robertrico/a2m2053_controller/docs/captures/m2/2026-10-10_motor_on_tach.txt

> motor on
motor on
OK
> status 4
status 4
STATUS MOTORON=0
OK
> status 13
status 13
STATUS READY=0
OK
> tach
tach
TACH edges=196 rpm=392
OK
> tach
tach
TACH edges=196 rpm=392
OK
