robertrico/a2m2053_controller/docs/captures/m0/2026-10-10_boot-safety-reset.png

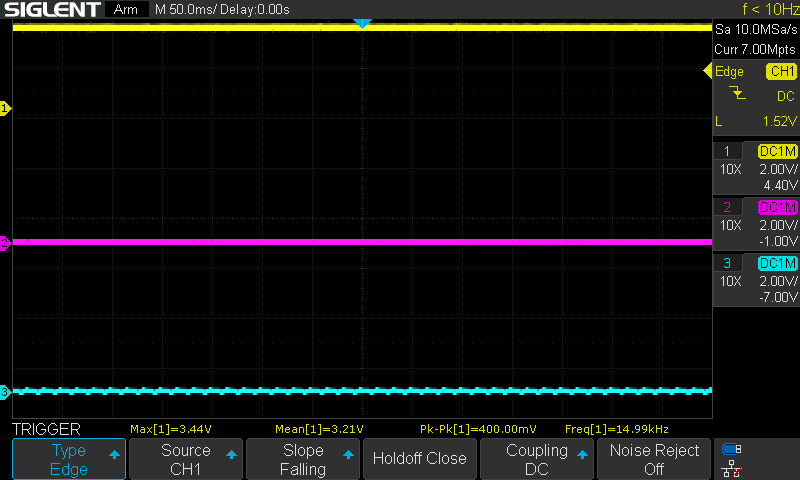
docs/captures/m0/2026-10-10_boot-safety-reset.png
