robertrico/a2m2053_controller/docs/captures/m0/2026-10-10_usb-plug-2us.png

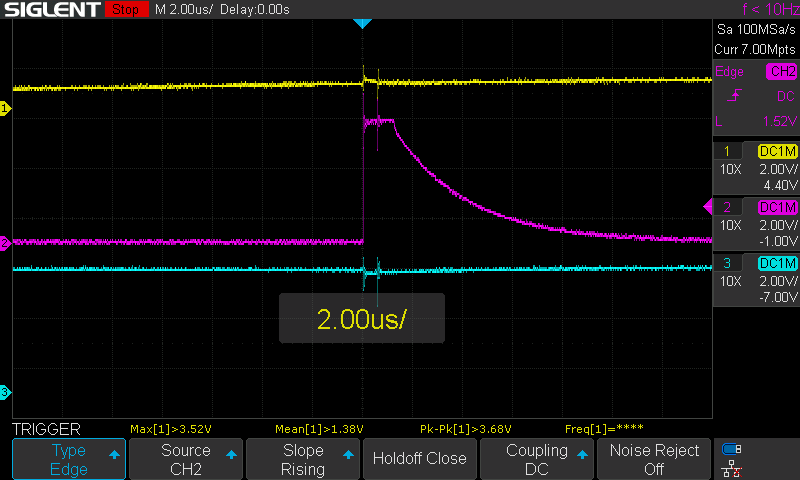
docs/captures/m0/2026-10-10_usb-plug-2us.png
