robertrico/a2m2053_controller/docs/captures/m0/2026-10-10_usb-plug-5ms.png

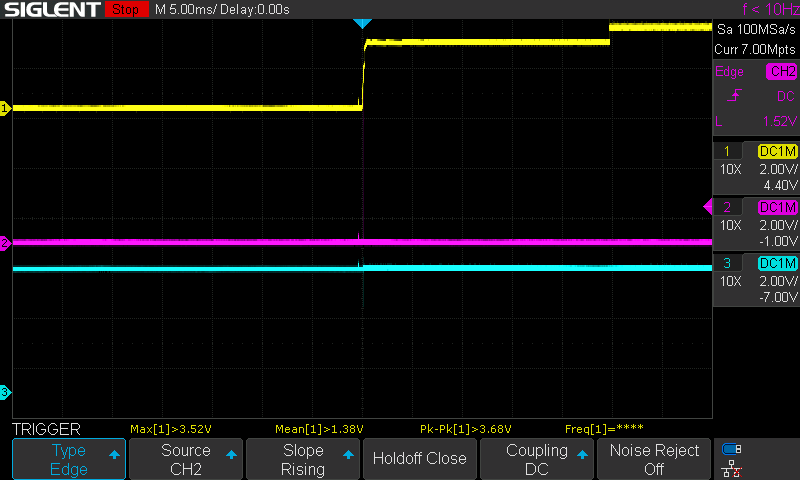
docs/captures/m0/2026-10-10_usb-plug-5ms.png
