robertrico/a2m2053_controller/docs/captures/m1/2026-10-10_settle_ca0-fall_rd-rise_100ns.png

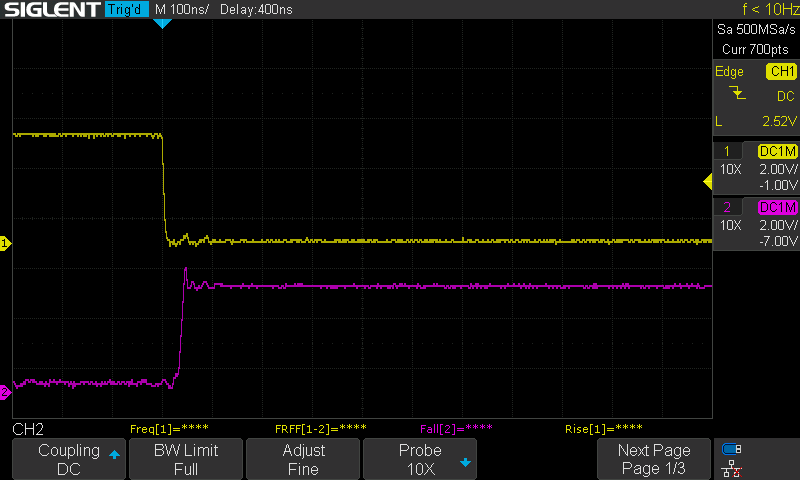
docs/captures/m1/2026-10-10_settle_ca0-fall_rd-rise_100ns.png
