robertrico/a2m2053_controller/docs/captures/m1/2026-10-10_settle_ca0-rise_rd-fall_2us.png

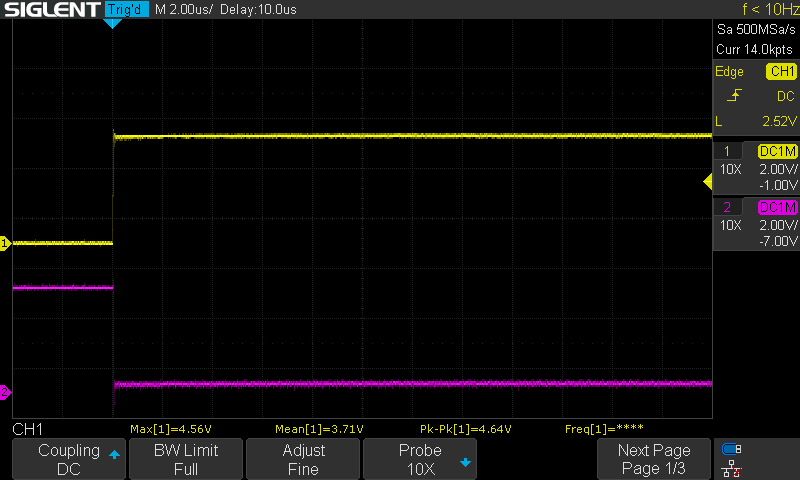
docs/captures/m1/2026-10-10_settle_ca0-rise_rd-fall_2us.png
