robertrico/a2m2053_controller/docs/captures/m2/2026-10-10_tach_track0_2ms.png

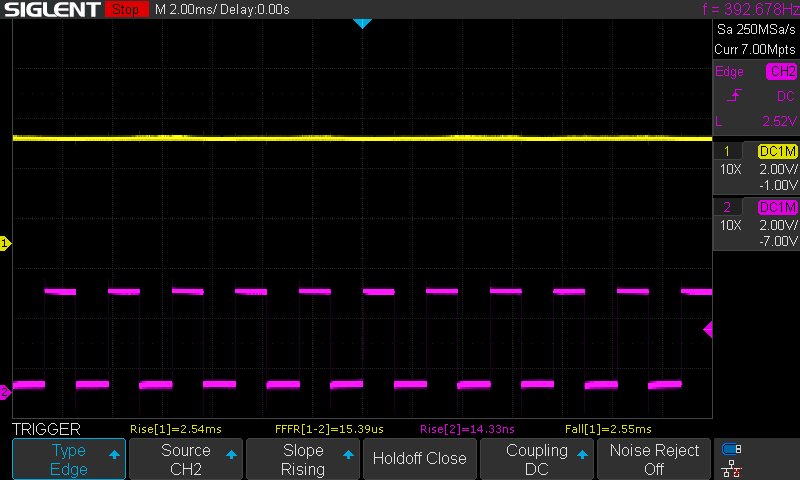
docs/captures/m2/2026-10-10_tach_track0_2ms.png
