robertrico/a2m2053_controller/docs/captures/m3/2026-10-10_rd_rddata0_flat_low_5us.png

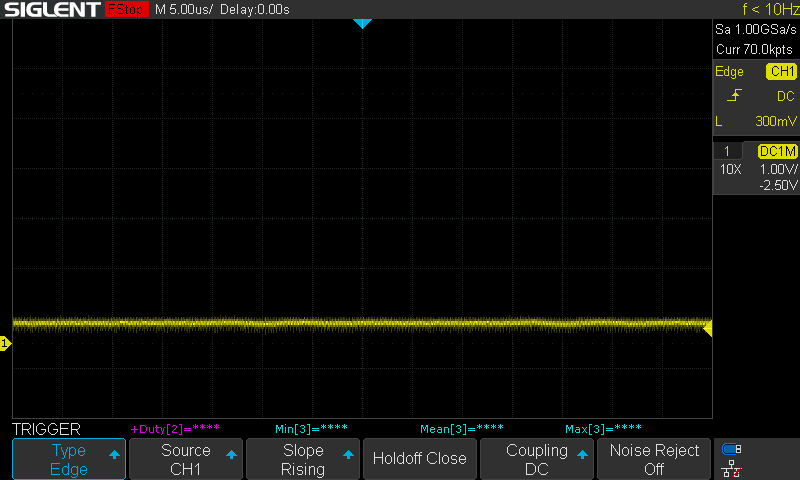
docs/captures/m3/2026-10-10_rd_rddata0_flat_low_5us.png
