robertrico/a2m2053_controller/docs/captures/m5/2026-10-11_console_format-after-readblk.png

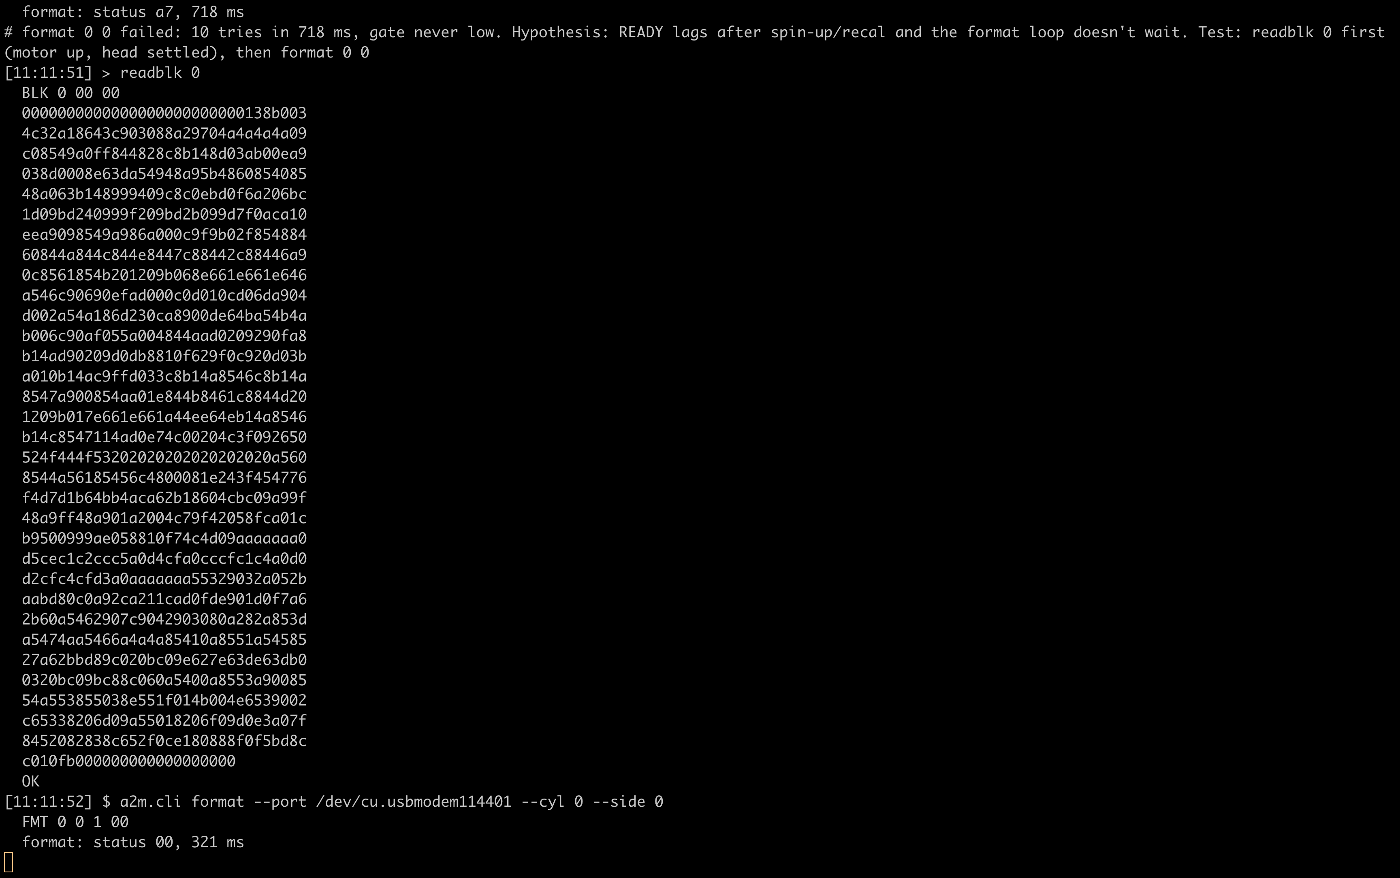
docs/captures/m5/2026-10-11_console_format-after-readblk.png
