robertrico/a2m2053_controller/docs/captures/m5/2026-10-11_console_full-format-46s.png

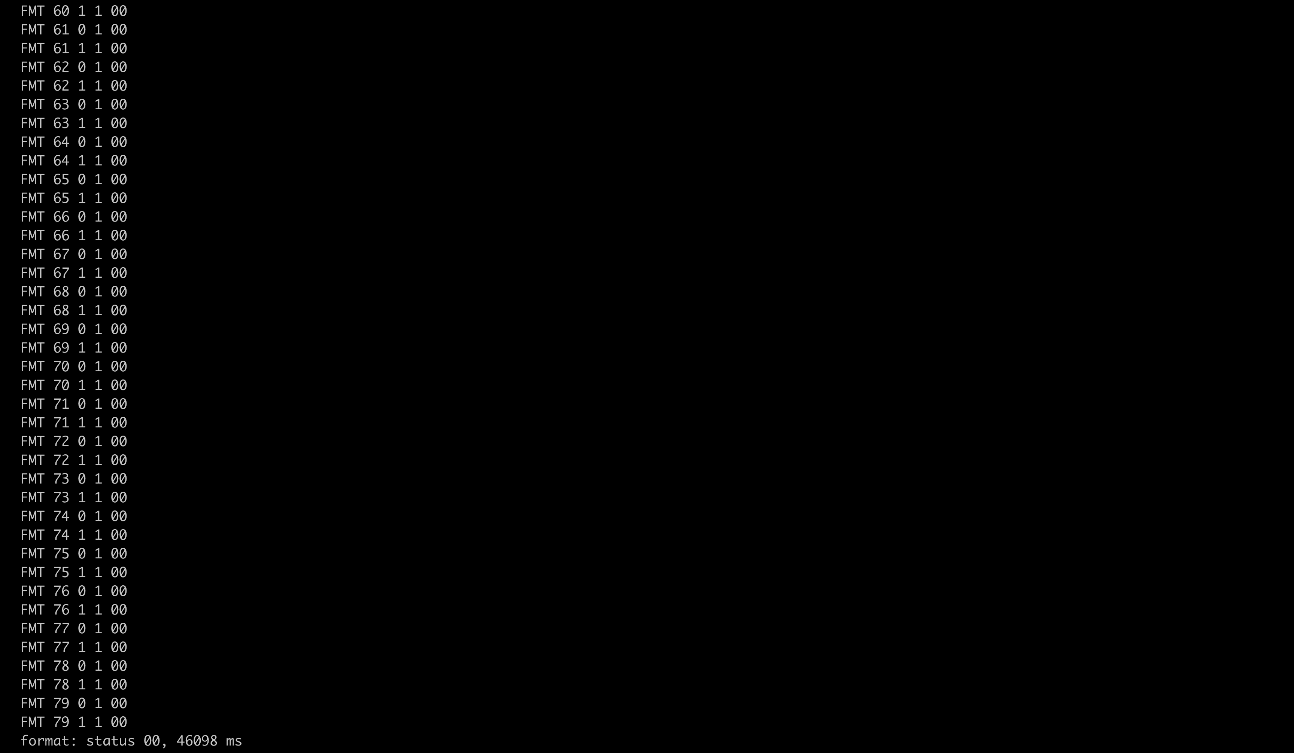
docs/captures/m5/2026-10-11_console_full-format-46s.png
