robertrico/a2m2053_controller/docs/captures/m5/2026-10-11_console_write-timing-notes.png

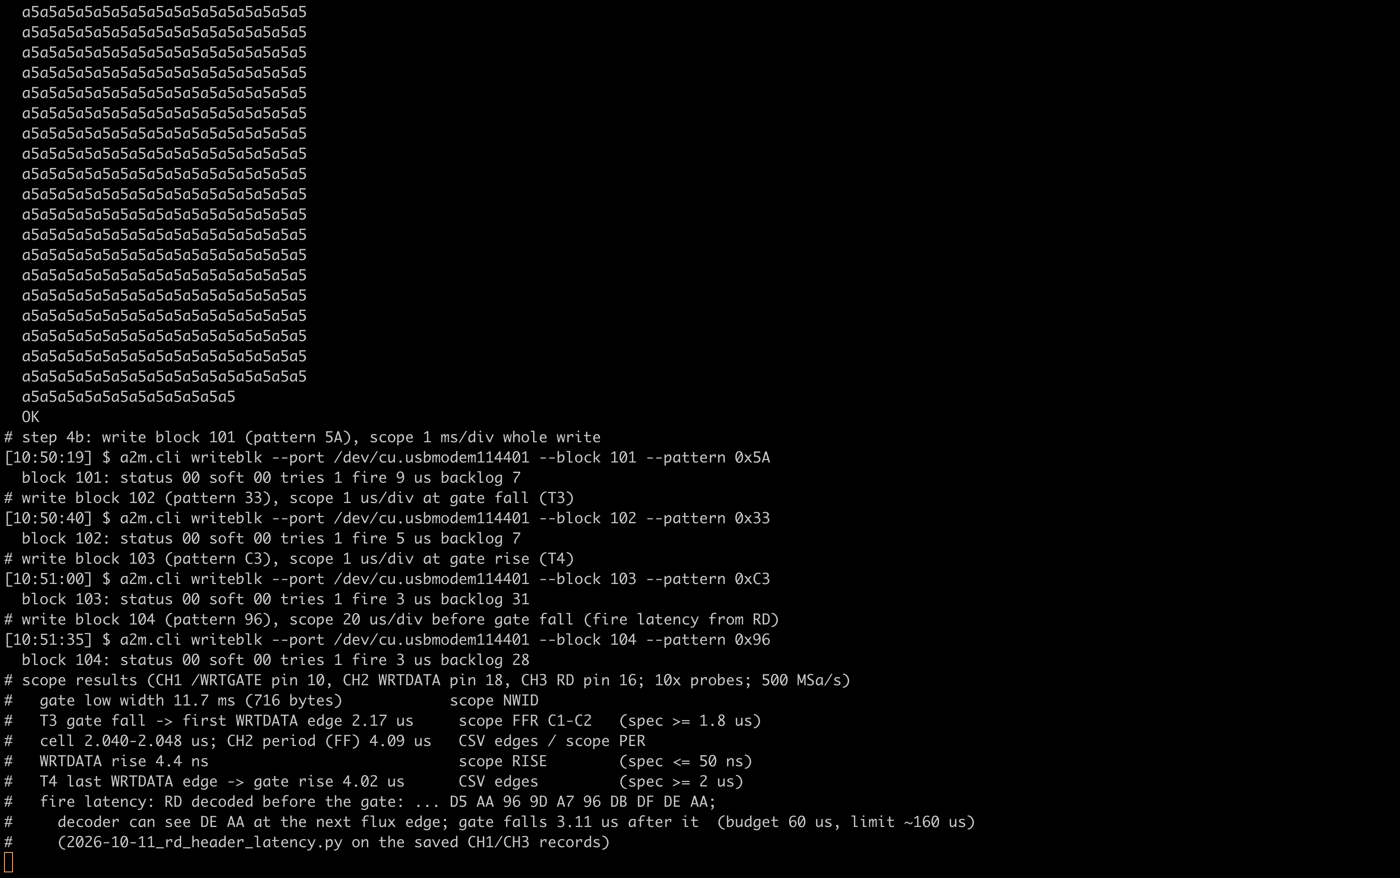
docs/captures/m5/2026-10-11_console_write-timing-notes.png
