robertrico/a2m2053_controller/docs/captures/m5/2026-10-11_first-write_gate-rd_2ms.png

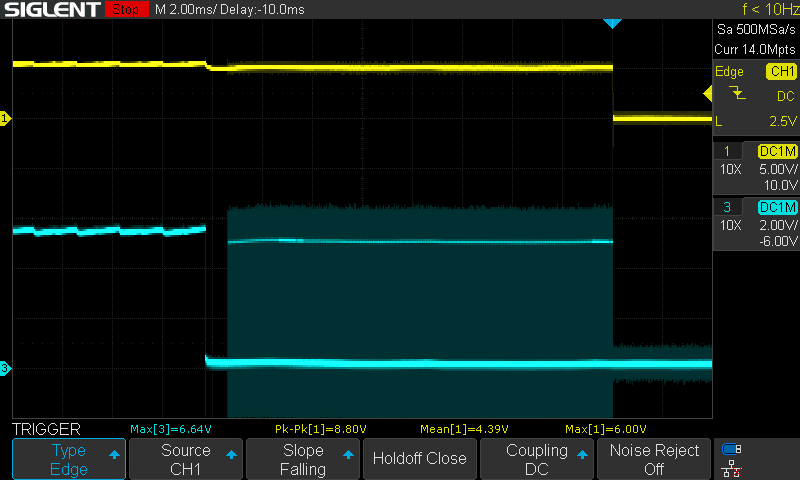
docs/captures/m5/2026-10-11_first-write_gate-rd_2ms.png
