robertrico/a2m2053_controller/docs/captures/m5/2026-10-11_format_t0s0_gate_20ms.png

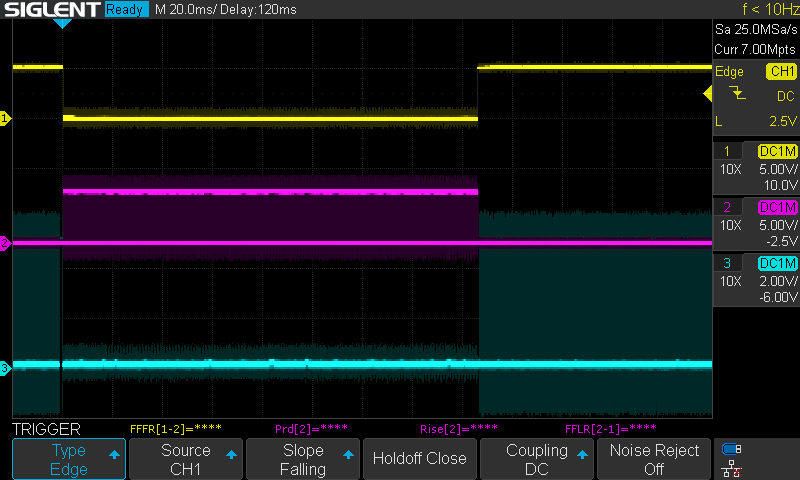
docs/captures/m5/2026-10-11_format_t0s0_gate_20ms.png
