robertrico/a2m2053_controller/docs/captures/m5/2026-10-11_iie_disk2_catalog_unidisk.png

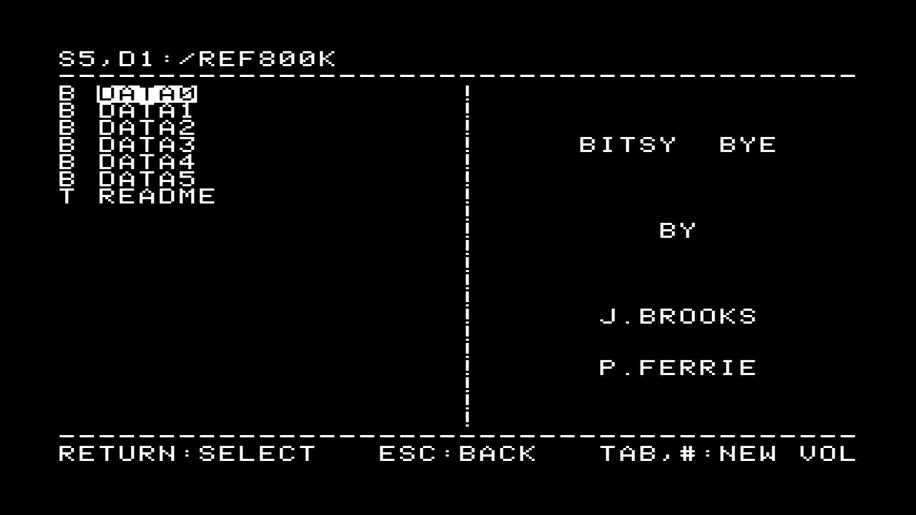
docs/captures/m5/2026-10-11_iie_disk2_catalog_unidisk.png
