robertrico/a2m2053_controller/docs/captures/m5/2026-10-11_write_gate-fall_T3_1us.png

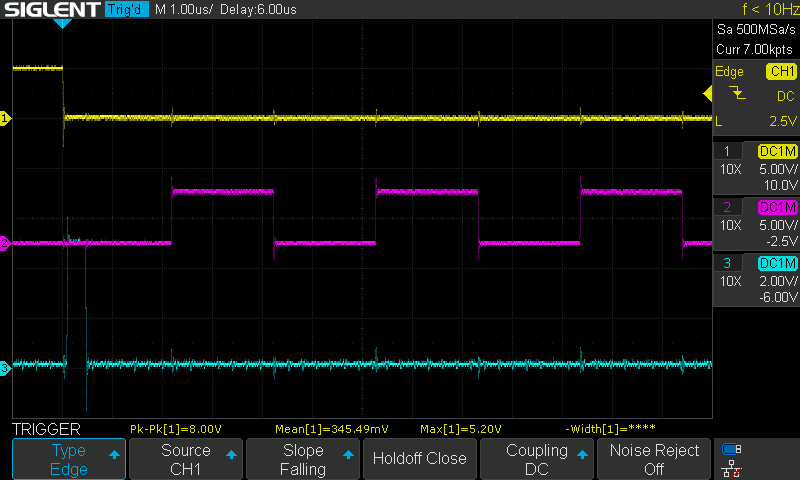
docs/captures/m5/2026-10-11_write_gate-fall_T3_1us.png
