robertrico/a2m2053_controller/docs/captures/m5/2026-10-11_write_rd-before-gate_20us.png

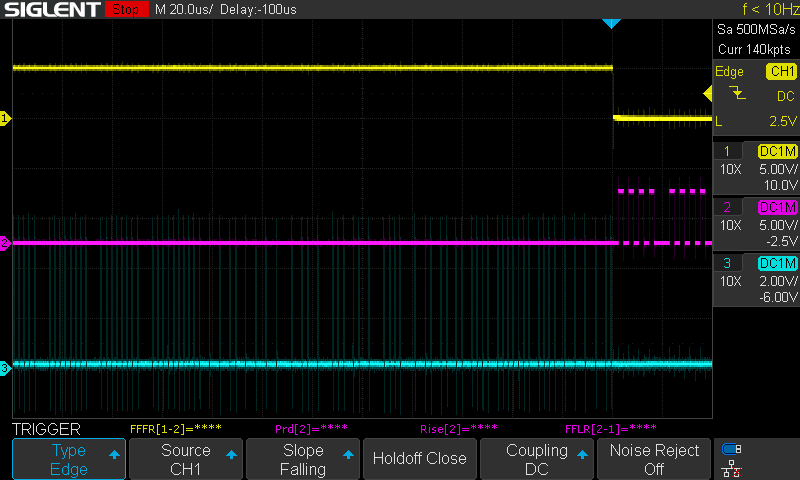
docs/captures/m5/2026-10-11_write_rd-before-gate_20us.png
