robertrico/a2m2053_controller/docs/captures/m5/2026-10-11_writedisk_cadence_100ms.png

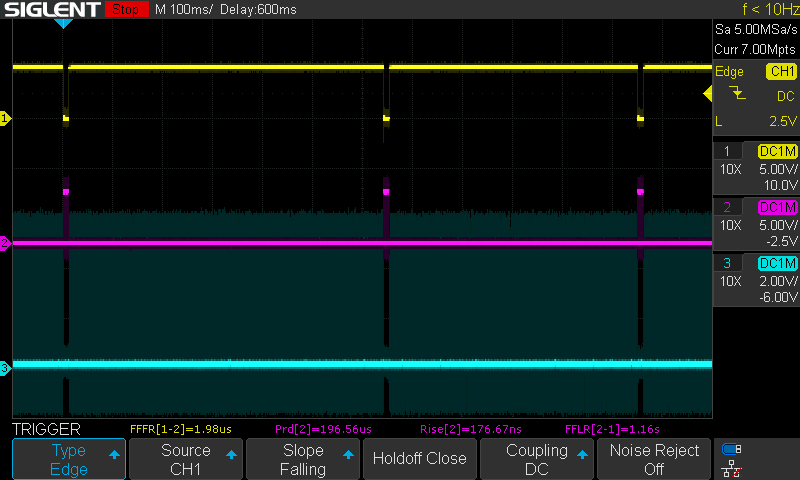
docs/captures/m5/2026-10-11_writedisk_cadence_100ms.png
