robertrico/a2m2053_controller/docs/captures/m5/2026-10-11_writedisk_gcr-data_5us.png

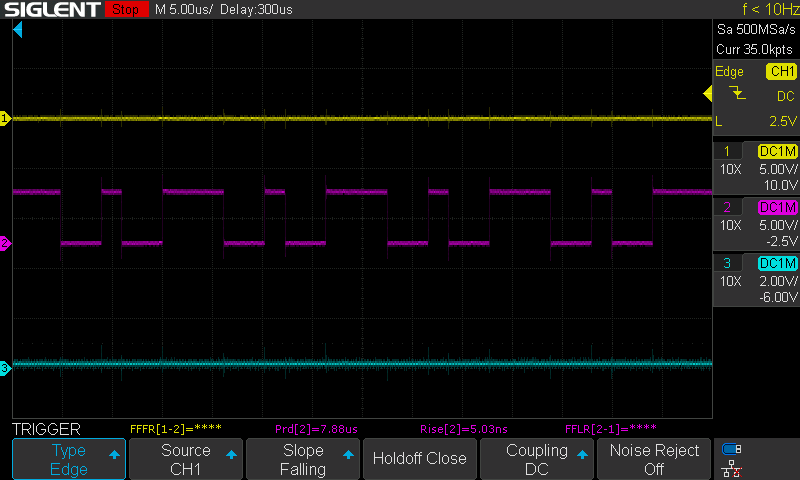
docs/captures/m5/2026-10-11_writedisk_gcr-data_5us.png
