robertrico/a2m2053_controller/docs/captures/m5/2026-10-11_writedisk_one-block_2ms.png

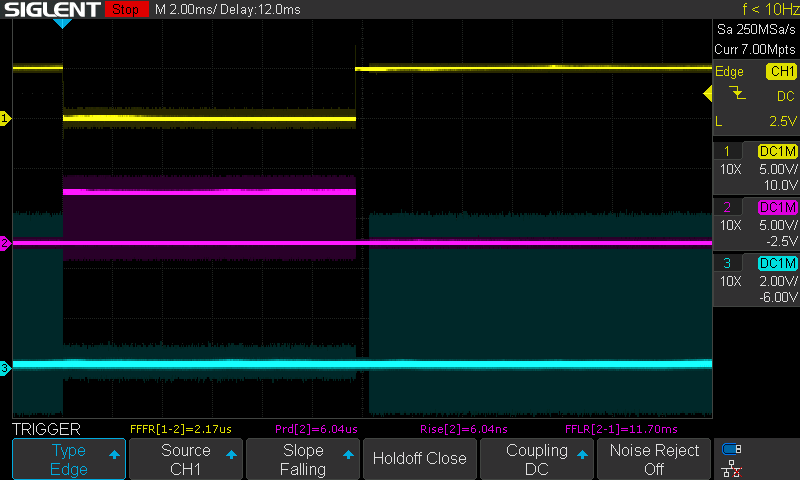
docs/captures/m5/2026-10-11_writedisk_one-block_2ms.png
