robertrico/a2m2053_controller/docs/captures/m6/2026-10-12_ack2_pr5-first-packet_20us.png

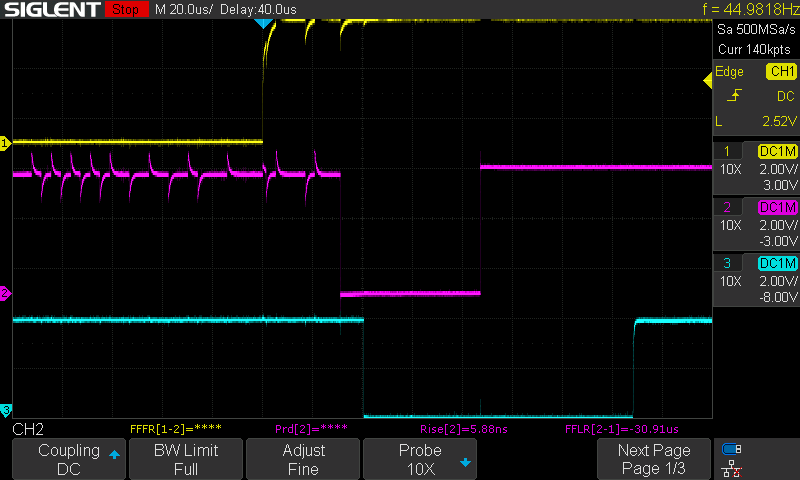
docs/captures/m6/2026-10-12_ack2_pr5-first-packet_20us.png
