robertrico/a2m2053_controller/docs/captures/m6/2026-10-12_ack3_pr5-init-ramfunc_20us.png

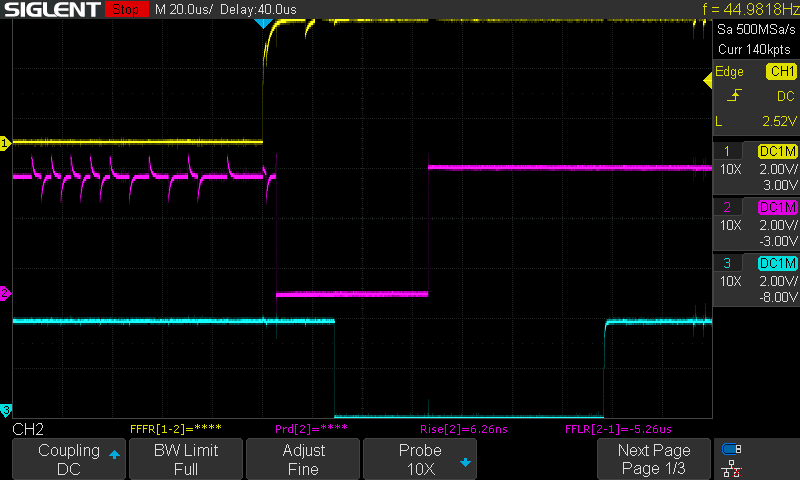
docs/captures/m6/2026-10-12_ack3_pr5-init-ramfunc_20us.png
