robertrico/a2m2053_controller/docs/captures/m6/2026-10-12_ack_wrreq-rise_20us.png

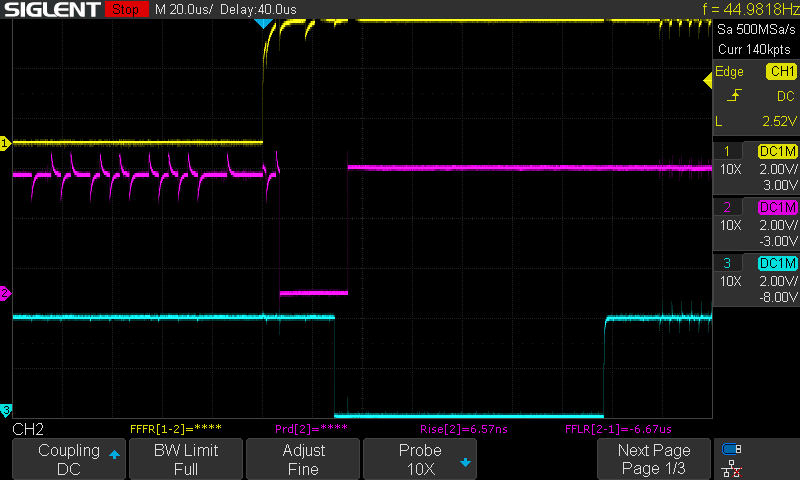
docs/captures/m6/2026-10-12_ack_wrreq-rise_20us.png
