robertrico/a2m2053_controller/docs/captures/m6/2026-10-12_iie_hello-load-list.png

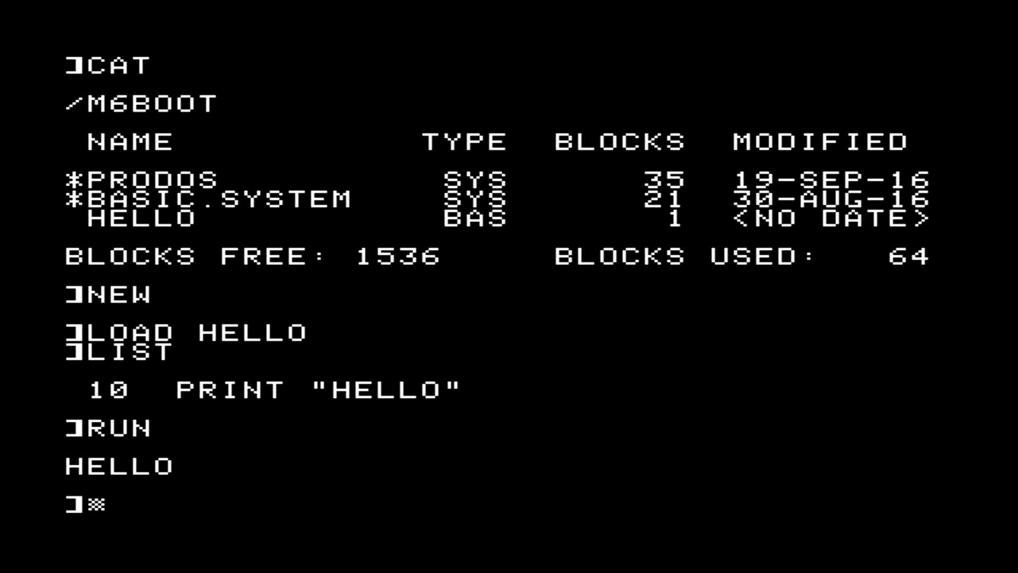
docs/captures/m6/2026-10-12_iie_hello-load-list.png
