robertrico/a2m2053_controller/docs/captures/m6/2026-10-12_iie_prodos-boot-from-board.png

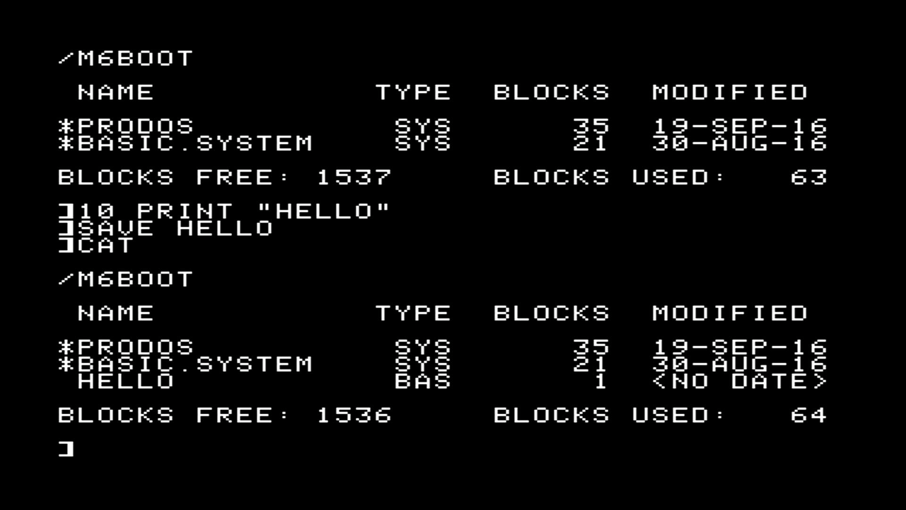
docs/captures/m6/2026-10-12_iie_prodos-boot-from-board.png
