robertrico/a2m2053_controller/docs/captures/m6/2026-10-12_iterm_console.png

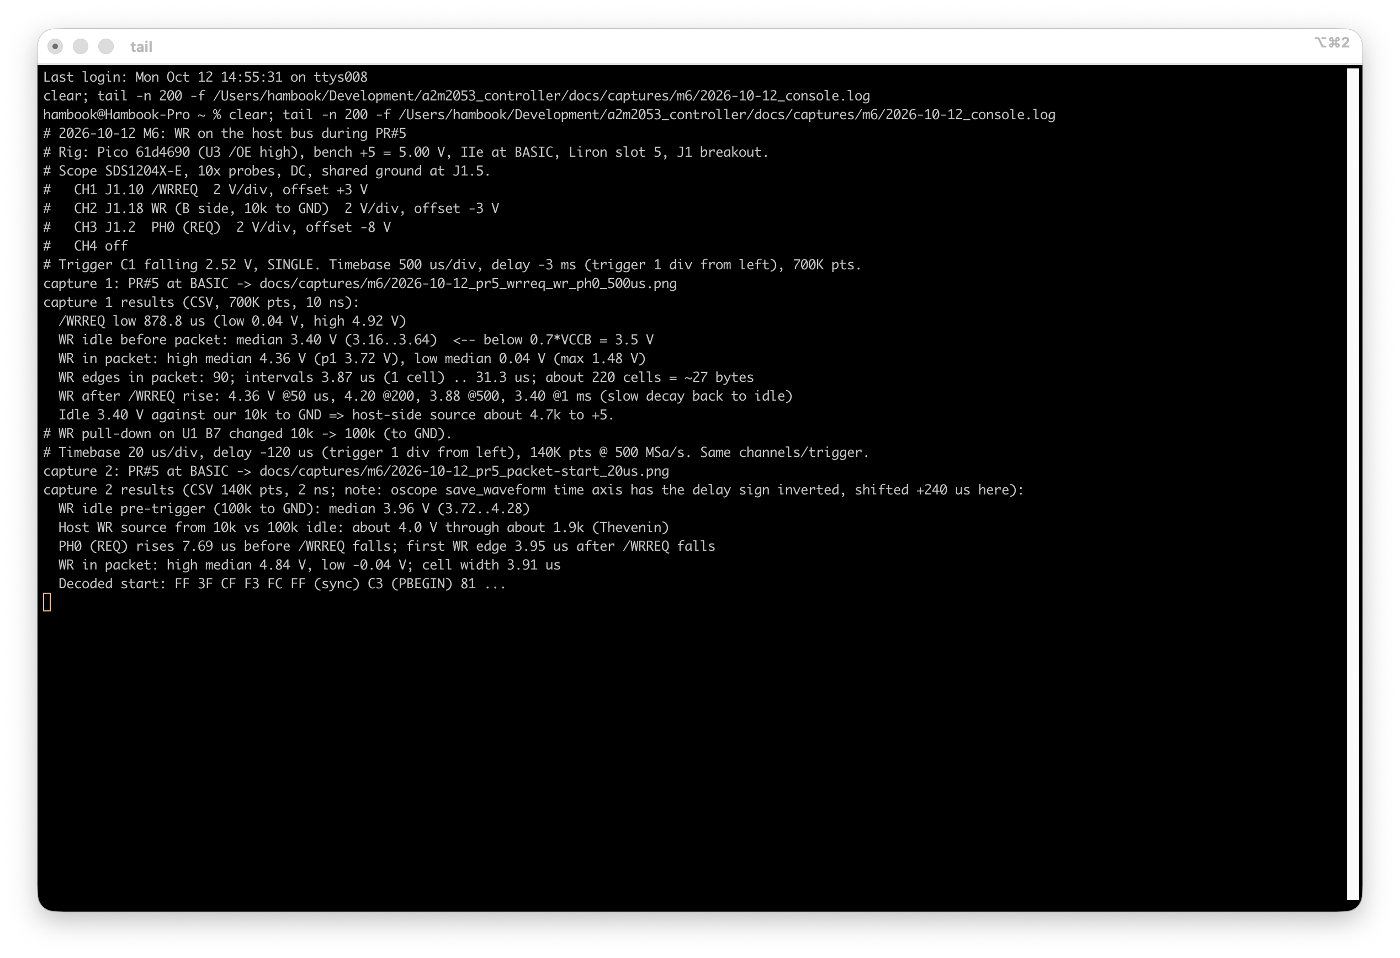
docs/captures/m6/2026-10-12_iterm_console.png
