robertrico/a2m2053_controller/docs/captures/m7/2026-10-12_iie_copy-readme.png

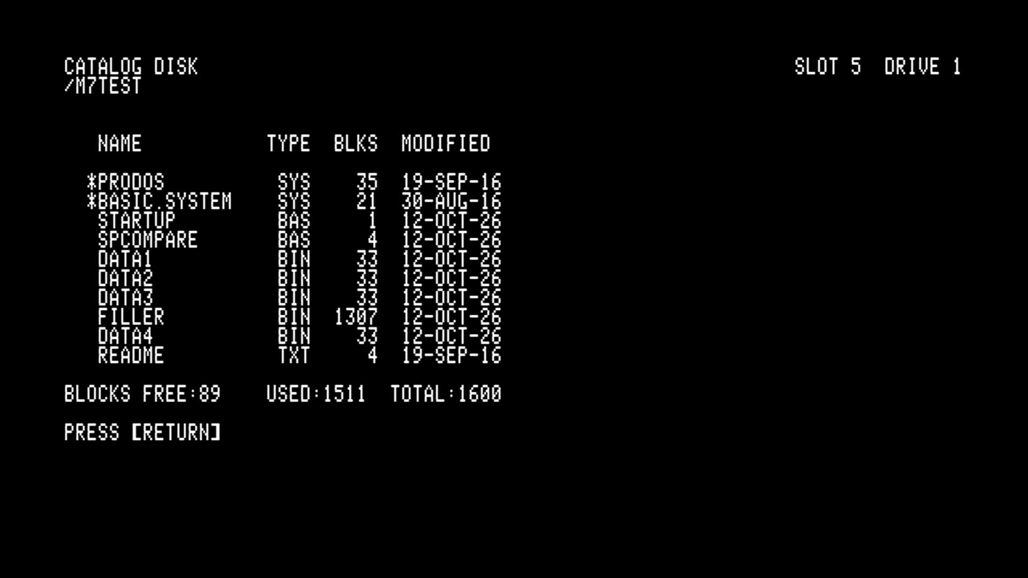
docs/captures/m7/2026-10-12_iie_copy-readme.png
