robertrico/a2m2053_controller/docs/captures/m8/2026-10-15_iie_copyplus-copydisk-done.png

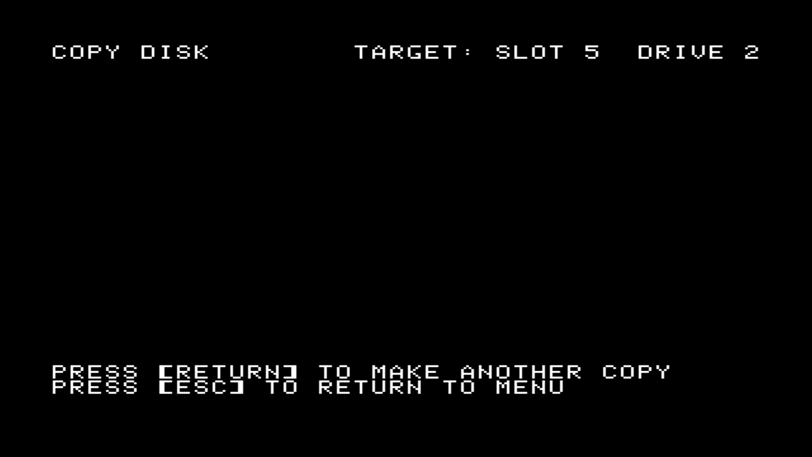
docs/captures/m8/2026-10-15_iie_copyplus-copydisk-done.png
