robertrico/a2m2053_controller/docs/captures/m8/2026-10-15_unidisk-behind_wrreq-ack-ph3out_2ms.png

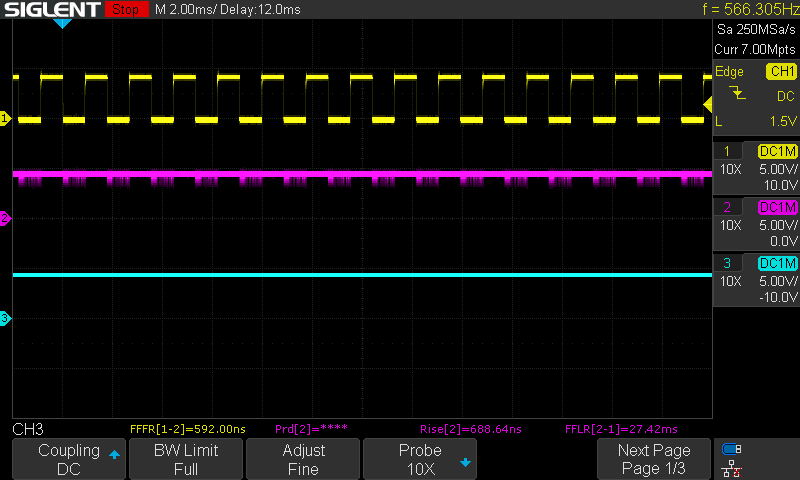
docs/captures/m8/2026-10-15_unidisk-behind_wrreq-ack-ph3out_2ms.png
