robertrico/a2m2053_controller/docs/captures/m9/2026-10-15_iie_copyplus-catalog-ref800k-after-swap-write.png

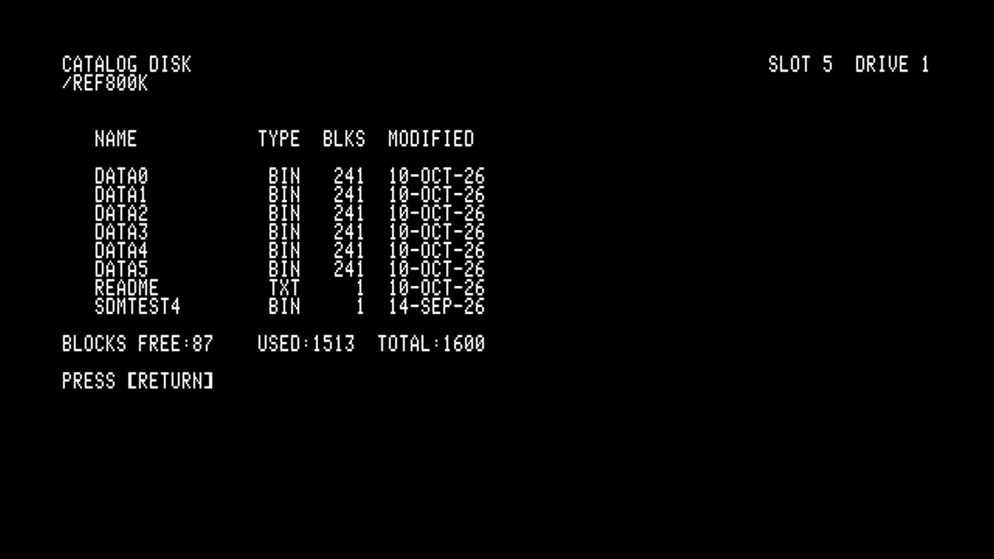
docs/captures/m9/2026-10-15_iie_copyplus-catalog-ref800k-after-swap-write.png
