robertrico/a2m2053_controller/docs/captures/m9/2026-10-15_iie_copyplus-format-wp.png

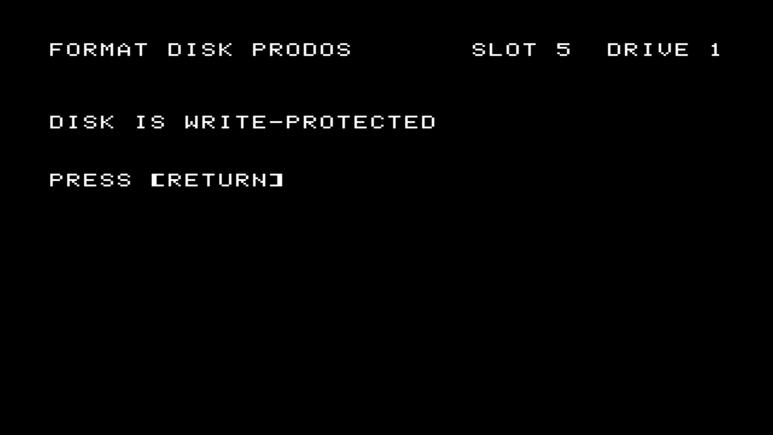
docs/captures/m9/2026-10-15_iie_copyplus-format-wp.png
