robertrico/a2m2053_controller/docs/photos/IF-83_505_bottom_cxd1013.jpeg

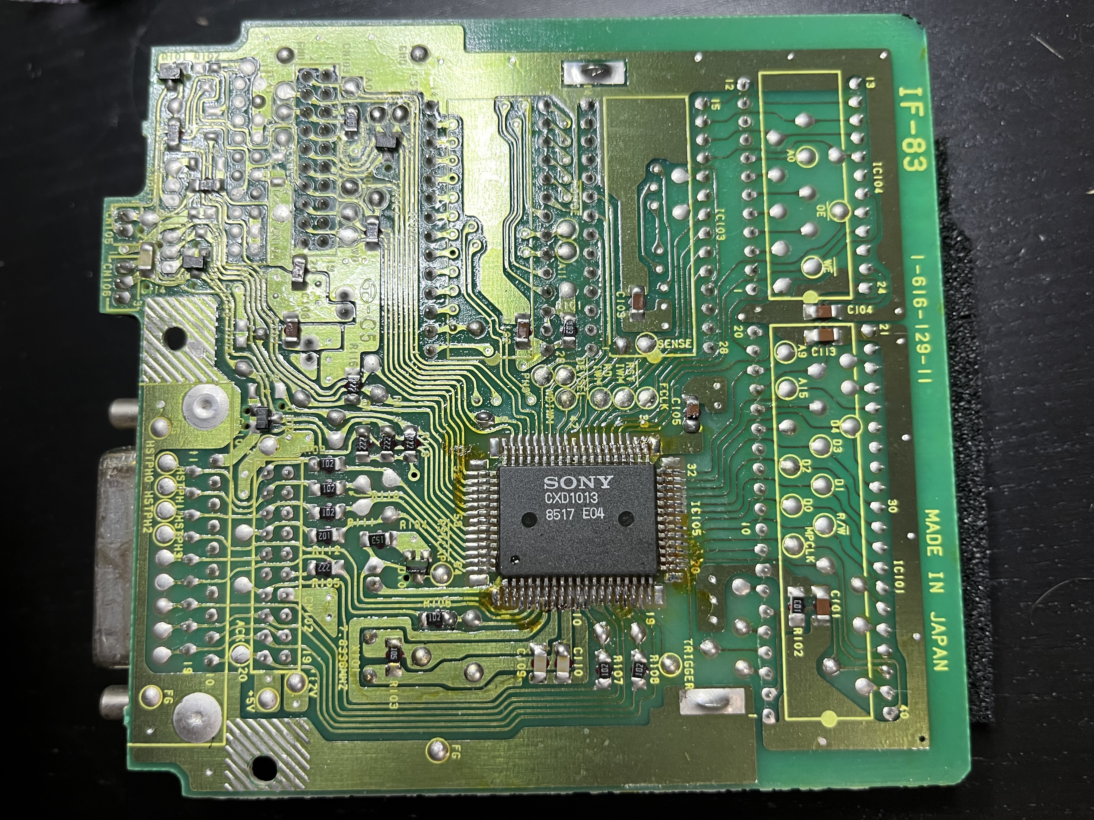
docs/photos/IF-83_505_bottom_cxd1013.jpeg
