robertrico/a2m2053_controller/docs/photos/IF-83_505_top_with_mechanism.jpeg

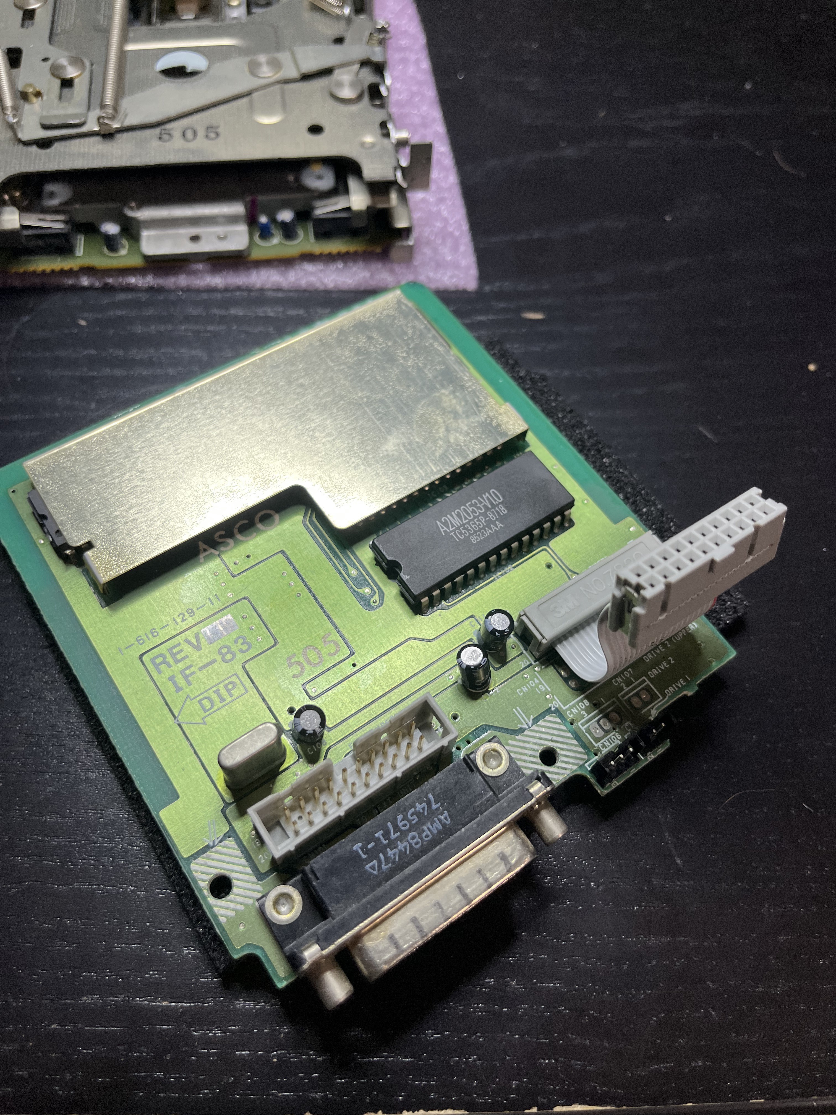
docs/photos/IF-83_505_top_with_mechanism.jpeg
