robertrico/a2m2053_controller/docs/photos/m0/2026-10-10_breadboard-pico-u1-u2.jpg

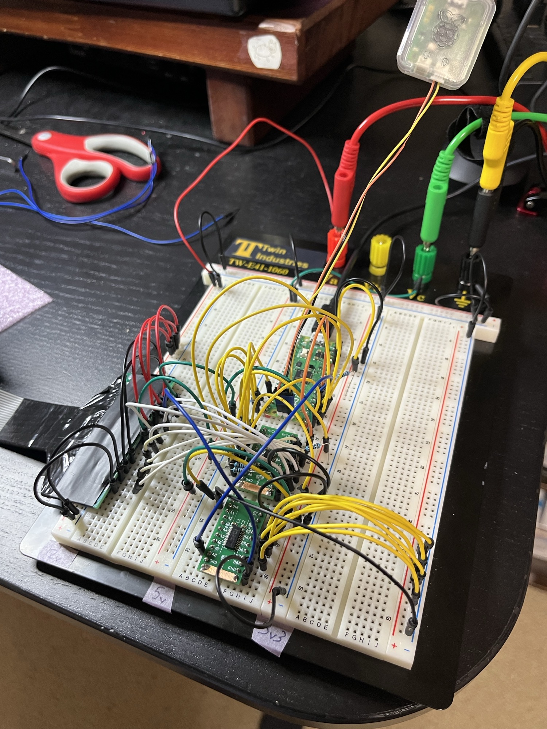
docs/photos/m0/2026-10-10_breadboard-pico-u1-u2.jpg
