robertrico/a2m2053_controller/docs/photos/m0/2026-10-10_rig-overview.jpg

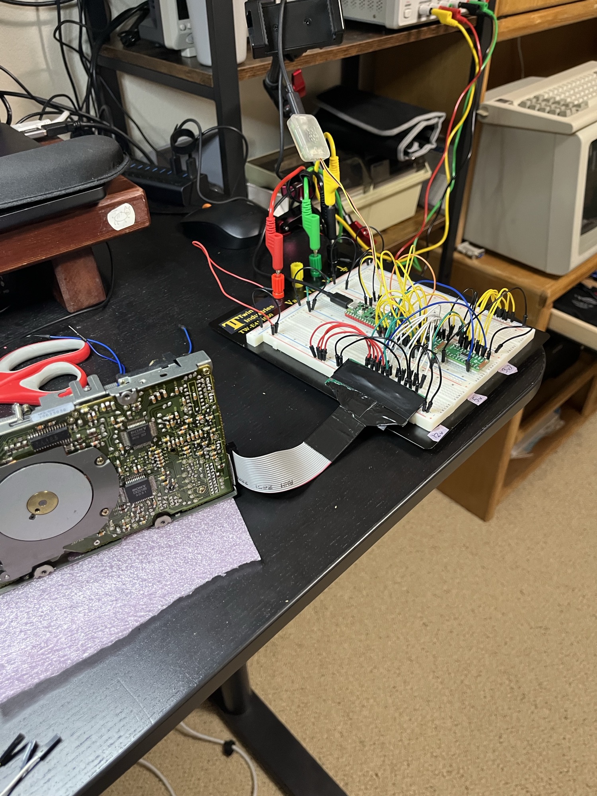
docs/photos/m0/2026-10-10_rig-overview.jpg
