robertrico/a2m2053_controller/docs/photos/m6/2026-10-11_adapter-stray-strand-pos9-pos10.jpg

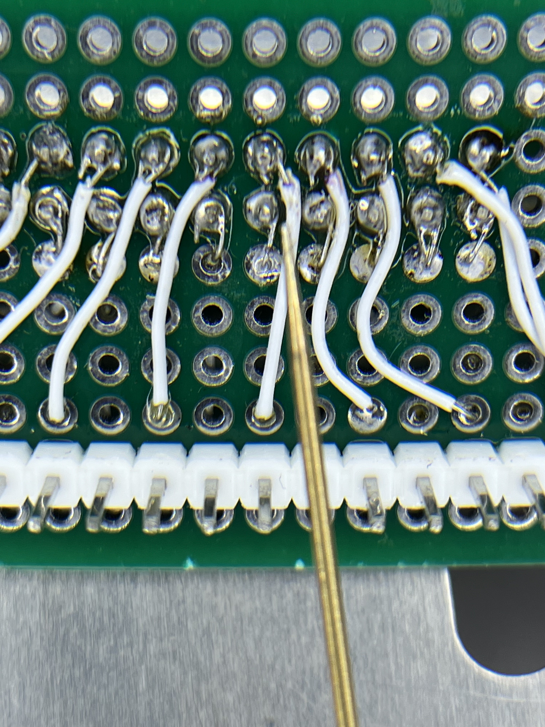
docs/photos/m6/2026-10-11_adapter-stray-strand-pos9-pos10.jpg
