robertrico/a2m2053_controller/docs/photos/m6/2026-10-11_if83-donor-board.jpg

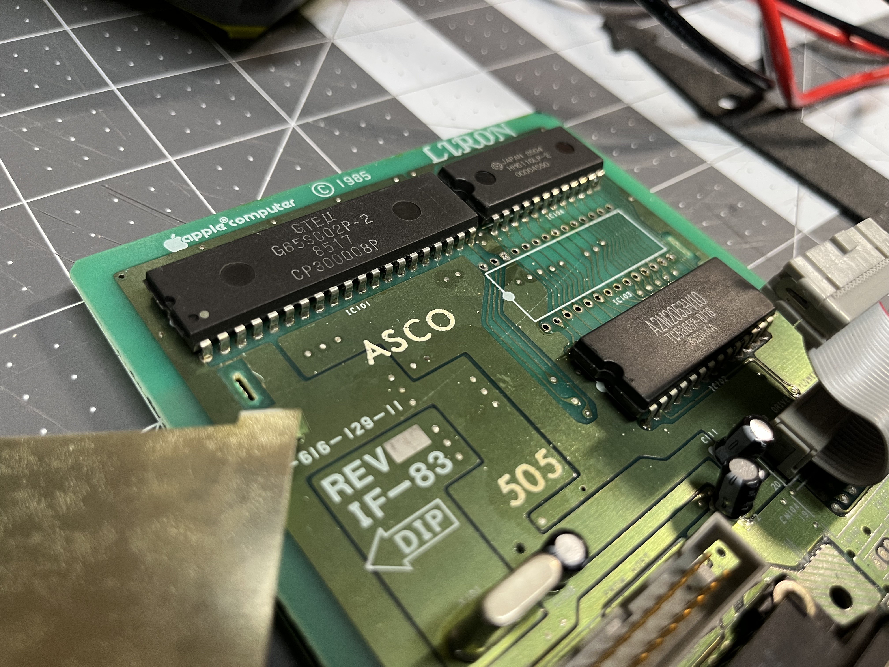
docs/photos/m6/2026-10-11_if83-donor-board.jpg
