robertrico/a2m2053_controller/docs/photos/m6/2026-10-11_iwm-dead-mexico-vs-donor-korea.jpg

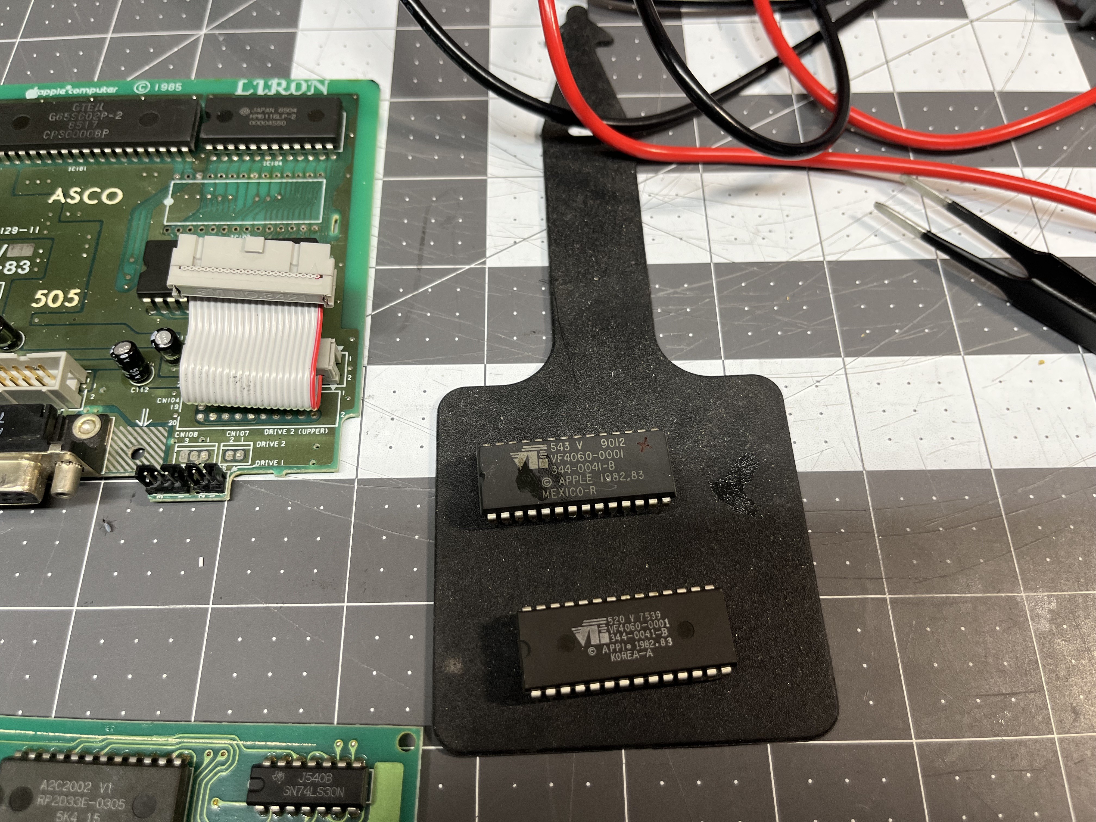
docs/photos/m6/2026-10-11_iwm-dead-mexico-vs-donor-korea.jpg
