robertrico/a2m2053_controller/docs/photos/m6/2026-10-11_liron-iwm-socket-ic105.jpg

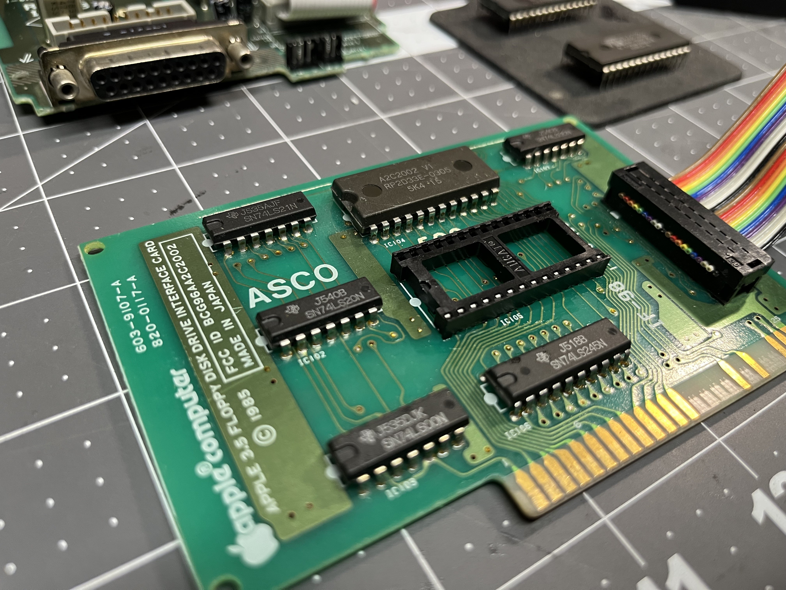
docs/photos/m6/2026-10-11_liron-iwm-socket-ic105.jpg
