robertrico/a2m2053_controller/docs/photos/m6/2026-10-11_u1-burned-8t245.jpg

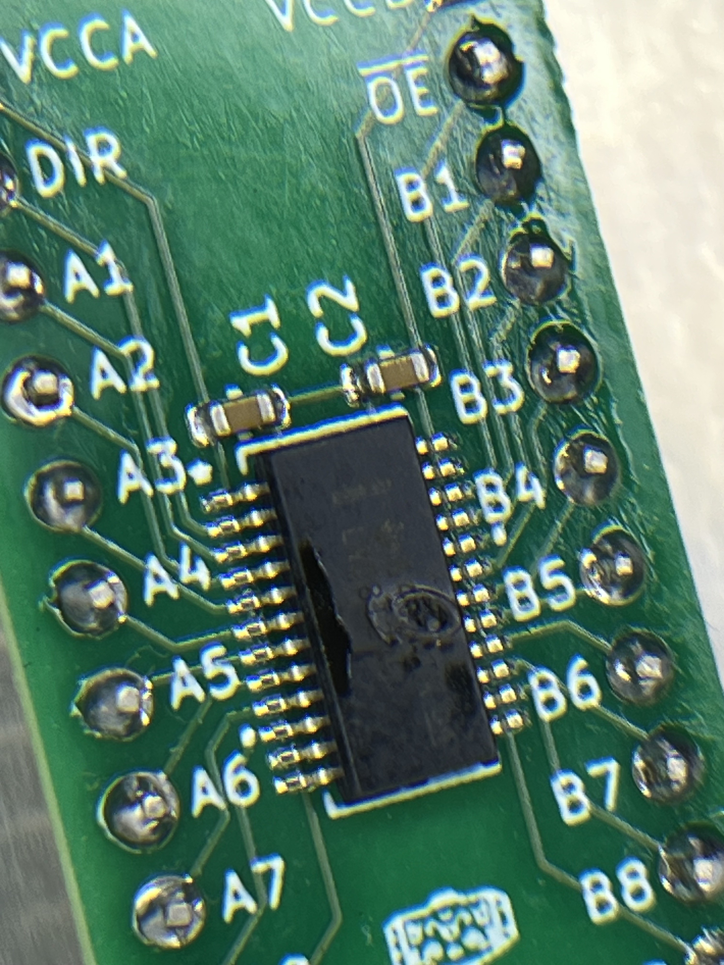
docs/photos/m6/2026-10-11_u1-burned-8t245.jpg
