robertrico/a2m2053_controller/docs/photos/m6/2026-10-11_u1-resistor-leads-over-module.jpg

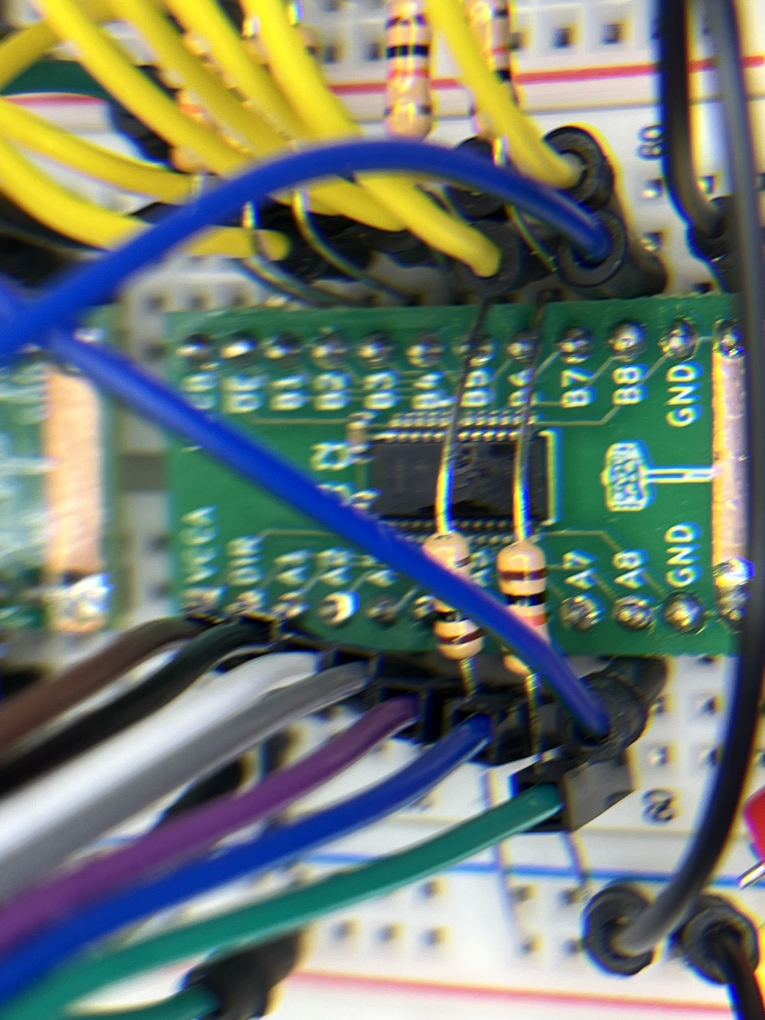
docs/photos/m6/2026-10-11_u1-resistor-leads-over-module.jpg
