robertrico/a2m2053_controller/docs/photos/m7/2026-10-12_bench-all-wired.jpg

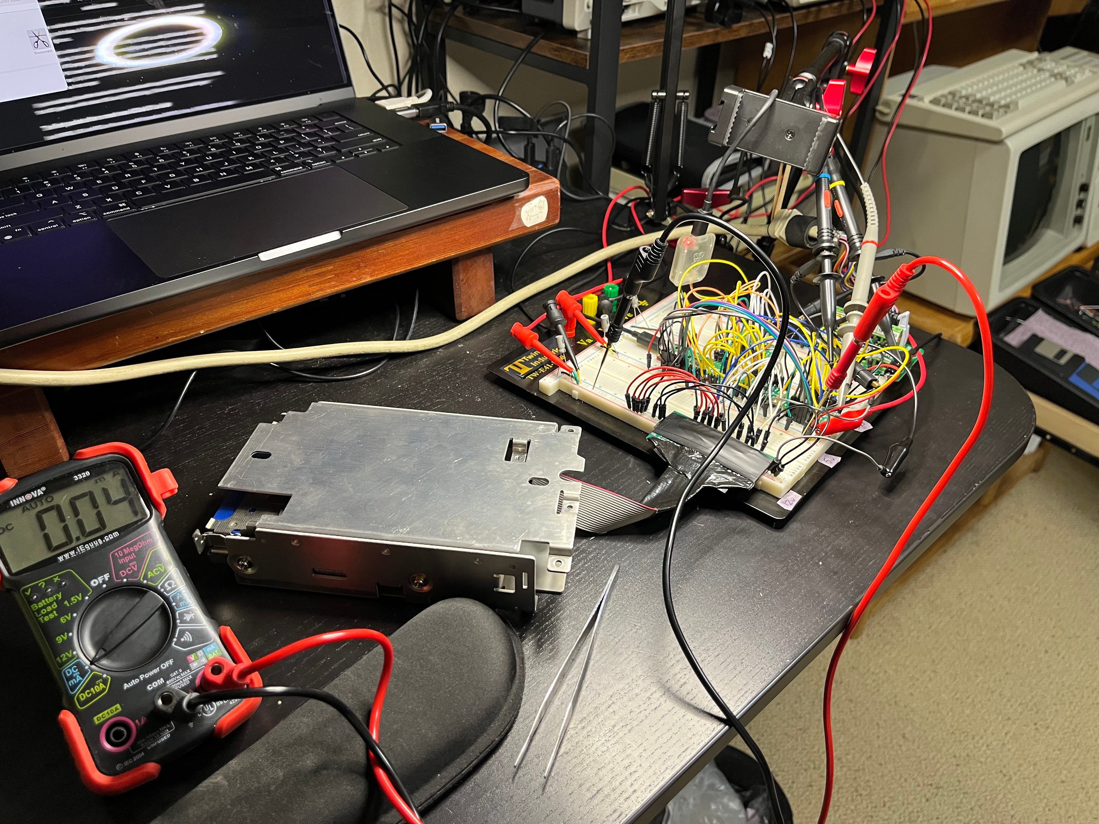
docs/photos/m7/2026-10-12_bench-all-wired.jpg
