robertrico/a2m2053_controller/docs/photos/m7/2026-10-14_j1-in-chassis.jpg

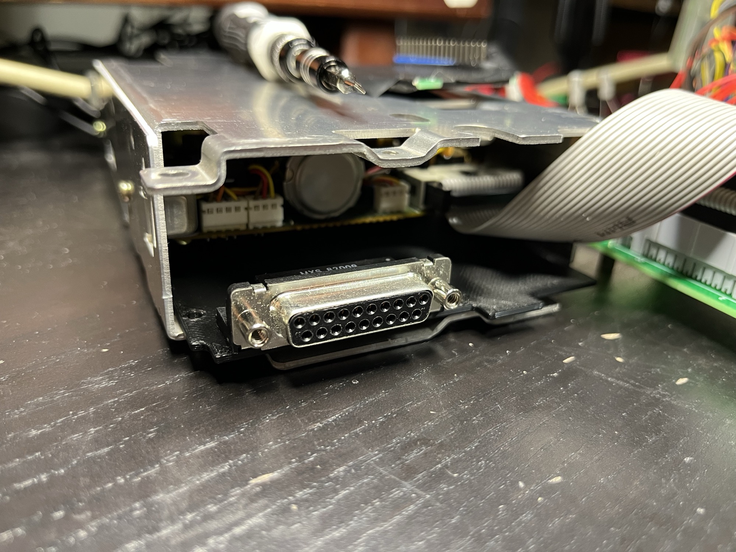
docs/photos/m7/2026-10-14_j1-in-chassis.jpg
