robertrico/a2m2053_controller/docs/photos/mechanism_board_cx23077a_cx20185.jpeg

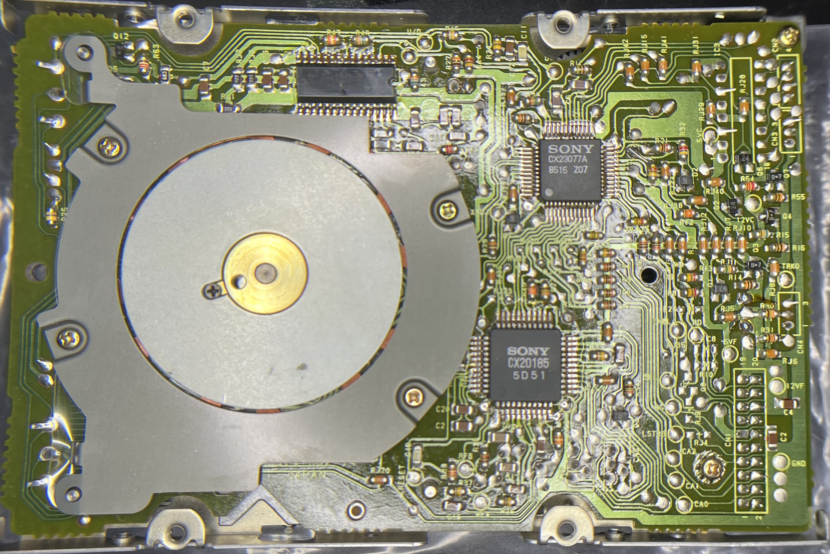
docs/photos/mechanism_board_cx23077a_cx20185.jpeg
