robertrico/a2m2053_controller/hardware/kicad/render/a2m2053.png

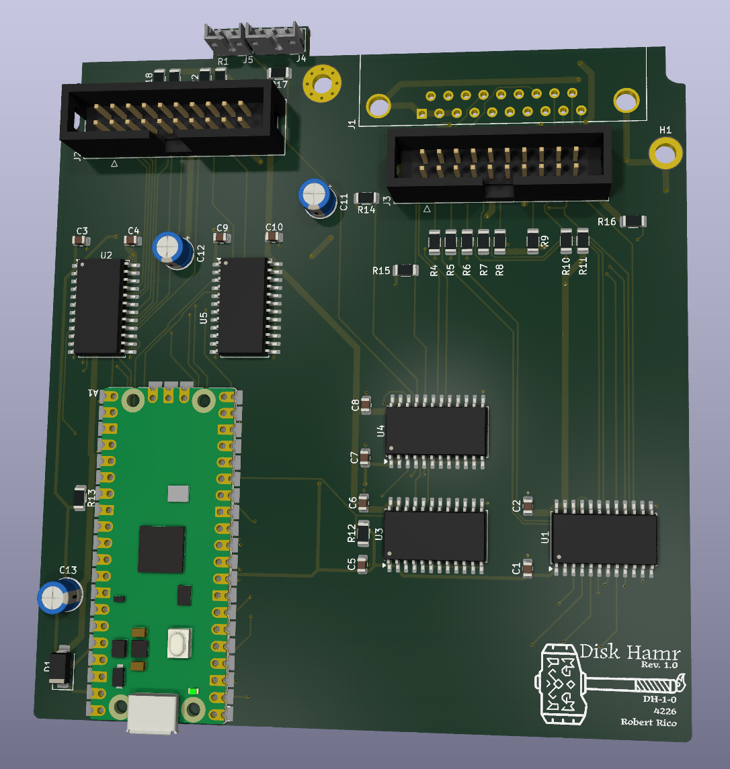
hardware/kicad/render/a2m2053.png
