robertrico/a2m2053_controller/hardware/bom.csv

Item | Qty | References | Value | Package / footprint | Manufacturer | MPN | Vendor | Vendor part | Est. unit USD (unverified; see bom.md) | Notes
1 | 1 | A1 | Pico 2 | Castellated module (RaspberryPi_Pico_SMD_HandSolder) | Raspberry Pi | SC1631 | Digikey | 2648-SC1631CT-ND | 6.12 | Plain Pico 2, no headers, not W. Soldered flat by castellations. $12 min per unit (2026-10-18).
2 | 5 | U1,U2,U3,U4,U5 | SN74LVC8T245DWR | SOIC-24W 7.5 mm 1.27 mm | Texas Instruments | SN74LVC8T245DWR | Digikey | 296-23280-1-ND | 1.10 | Level shifters. Alternates (TSSOP, respin): 74LVC8T245PW, SN74LXC8T245PWR.
3 | 1 | D1 | STPS2L40AF | SMA | STMicroelectronics | STPS2L40AF | Digikey | 497-18870-1-ND | 0.63 | Pico VSYS feed from IIe +5V, blocks USB back-feed. Any 2 A low-Vf SMA Schottky.
4 | 10 | C1,C2,C3,C4,C5,C6,C7,C8,C9,C10 | 100nF 50V X7R | 0805 | Samsung | CL21B104KBCNNNC | Digikey | 1276-1003-1-ND | 0.03 | Decoupling, one VCCA and one VCCB per shifter. Order 15.
5 | 3 | C11,C12,C13 | 4.7uF 50V electrolytic | Radial D5 mm P2.0 mm | Panasonic | ECA-1HM4R7 | Digikey | P5177-ND | 0.145 | Bulk at CN104 (+12V, +5V) as on the IF-83, and 3V3 bulk. Polarized.
6 | 15 | R1,R2,R3,R4,R5,R6,R7,R8,R9,R11,R12,R13,R14,R15,R18 | 10k | 1206 | Yageo | RC1206FR-0710KL | Digikey | 311-10.0KFRCT-ND | 0.02 | Pull-ups and pull-downs, see bom.md for each net. Order 20.
7 | 1 | R10 | 100k | 1206 | Yageo | RC1206FR-07100KL | Digikey | 311-100KFRCT-ND | 0.02 | Host WR pull-down. 100k not 10k (measured, m6).
8 | 1 | R16 | 2k | 1206 | Yageo | RC1206FR-072KL | Digikey | 311-2.00KFRCT-ND | 0.02 | LASTONE/ pull-up on the rear port, pin 16.
9 | 1 | R17 | 180 | 1206 | Yageo | RC1206FR-07180RL | Digikey | 311-180FRCT-ND | 0.02 | In-use LED series resistor. Same value as the IF-83 LED anode pull-up (180 ohm, measured 2026-10-25). About 17 mA from 5 V, inside the 8T245 32 mA rating.
10 | 1 | J1 | DB-19 female right angle PCB mount | D-sub 19 with board locks 38.8 mm apart | - | - | eBay / AliExpress | "DB19 female right angle" | 15.00 | Rear daisy-chain port. Rarest and most expensive part on the board, $15 each on eBay. Purchased; fit-tested in the printed outline and the case opening, M7.2 2026-10-14.
11 | 2 | J2,J3 | 2x10 shrouded box header 2.54 mm vertical | IDC-Header_2x10_P2.54mm_Vertical | Wurth | 61202021621 | Digikey | 732-2096-ND | 0.885 | J2 = CN104 mechanism ribbon, J3 = CN102 host ribbon.
12 | 1 | J4 | AMP CT header 1x3 2.0 mm vertical | TE_AMP_CT_1x03_P2.00mm_Vertical (custom) | TE Connectivity | 292161-3 | Digikey | A98589-ND | 0.72 | Eject button (CN108). Black alternate 6-292161-3. Mates the drive's own lead (TE 173977 receptacle).
13 | 1 | J5 | AMP CT header 1x2 2.0 mm vertical | TE_AMP_CT_1x02_P2.00mm_Vertical (custom) | TE Connectivity | 292161-2 | Digikey | A98588-ND | 0.38 | In-use LED (CN107). Black alternate 6-292161-2. Mates the drive's own lead.
14 | 2 | H1,H2 | M3 mounting hole | 3.2 mm plated on GND | - | - | - | - | 0.00 | Drive's own M3 screws and standoffs. Not a purchased part.
15 | 1 | PCB | Disk Hamr rev 1.0 | 2 layer 100 x 110 mm 1.6 mm FR-4 | - | - | JLCPCB / PCBWay / OSH Park | - | 6.00 | Min track 0.25, clearance 0.2, drill 0.3. ENIG preferred. Qty 5 pricing.
16 | 1 | CBL1 | 20-way IDC ribbon cable; socket to socket | - | - | - | DigiKey | - | 2.50 | Ships with the board. Disk Hamr J2 to the mechanism 20-pin header; the IF-83 mechanism ribbon ends in a flat connector that does not fit the shrouded J2. Length and part number [guess]: about 150 mm; confirm against the drive before ordering.
