robertrico/a2m2053_controller/docs/manual/Disk_Hamr_Owners_Guide_DRAFT.pdf

# Disk Hamr

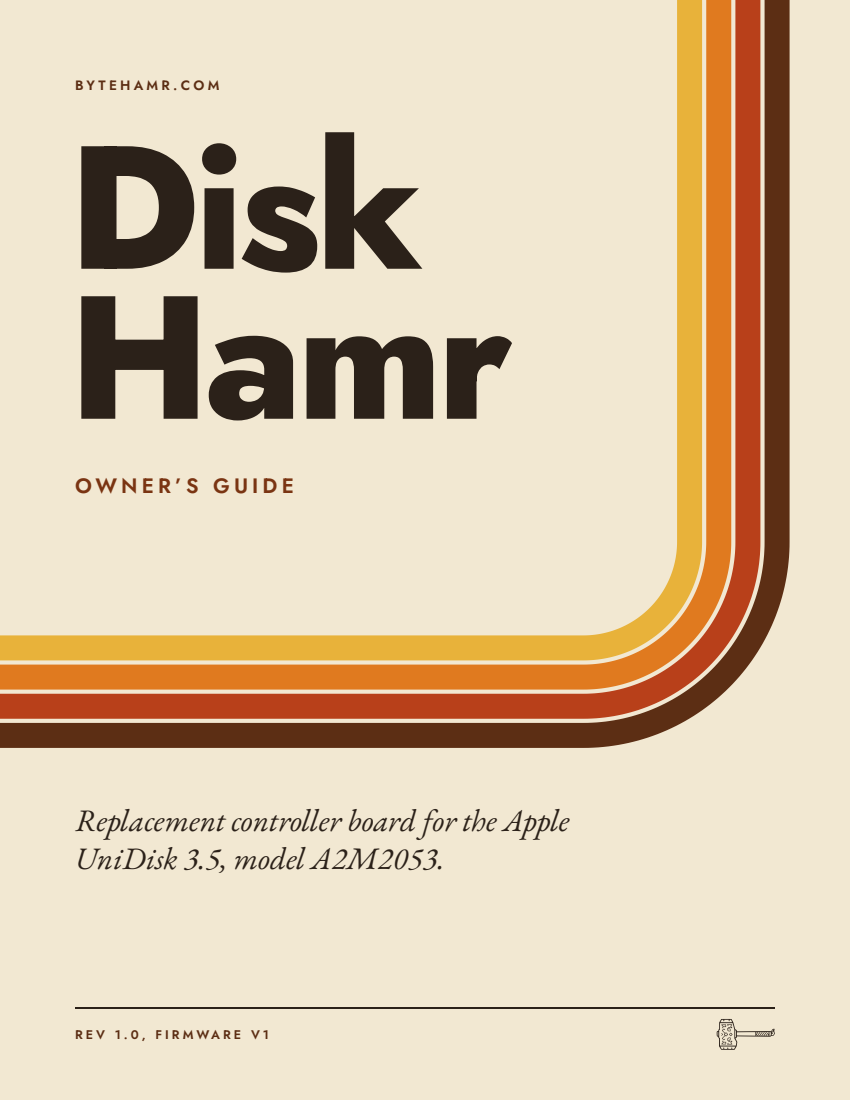
[picture p65: page 1]

Replacement controller board for the Apple
UniDisk 3.5, model A2M2053.

# Contents

## Disk Hamr rev 1.0, firmware v1

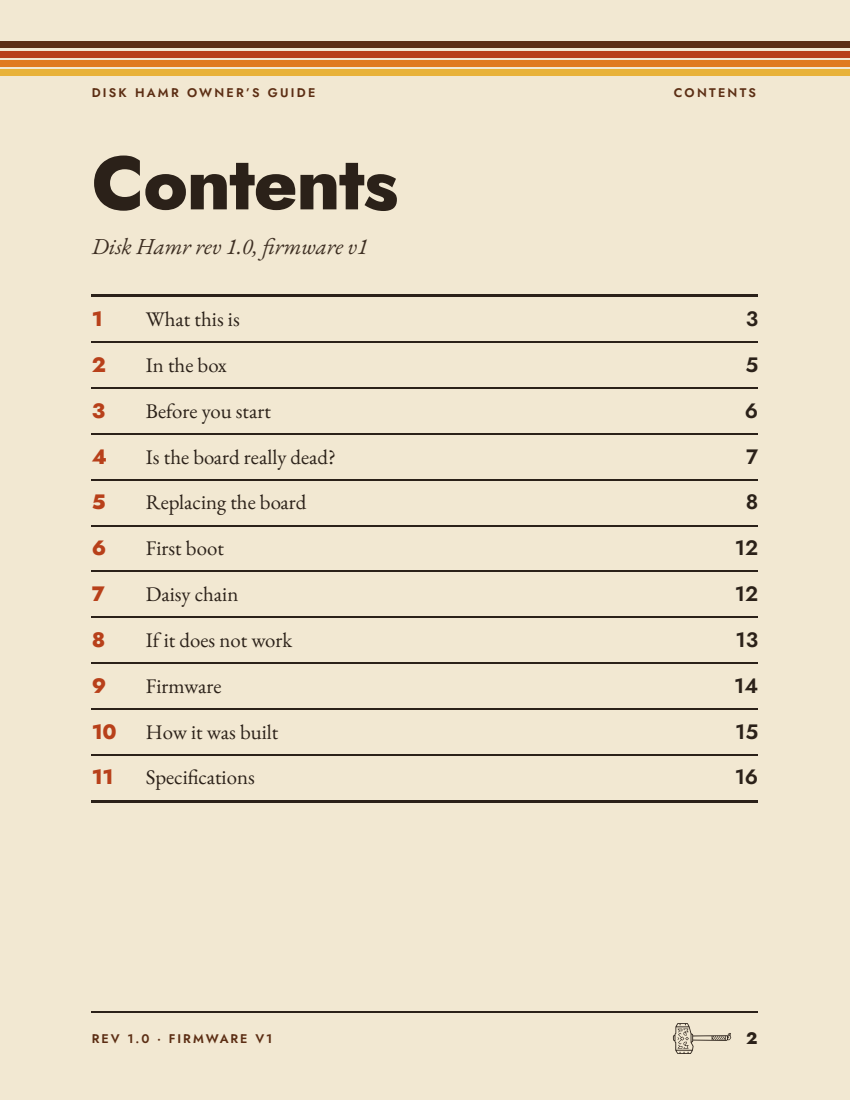
[picture p66: page 2]
What this is; In the box; Before you start; Is the board really dead?; Replacing the board; First boot; Daisy chain; If it does not work; Firmware; 10 How it was built; 11 Specifications; R E V 1 .0 · F I R MWA R E V 1

D I S K H A M R OW N E R ’ S G U I D E | S E CT I O N 1
1

S E CT I O N O N E

# What this is

## Which drive this is for: the UniDisk 3.5, model A2M2053

Apple sold several 3.5-inch drives that look alike and share the same Sony mechanism. Disk Hamr fits exactly one of them. Check before you buy or open anything:

It is not for:

PHOTO 1a

F I G 1 - 1 The underside label with A2M2053 circled, and the front badge.

Front badge reads “UniDisk 3.5”. Beige case, matching the Apple IIe.
Label on the underside reads model A2M2053.
Rear panel has a DB-19 socket for the next drive in the chain, next to the captive cable.
Inside, the controller board’s silk reads IF-83, and it carries a 65C02, ROM, RAM and a large Sony gate array marked CXD1013.

the Apple 3.5 Drive, model A9M0106 (platinum, badge “Apple 3.5 Drive”, for the IIgs, IIc Plus and Macintosh). Same mechanism, different board, different protocol.
the Macintosh 800K External Drive, model M0131, or any Macintosh-only drive.
the Disk II, UniDisk 5.25 or any 5.25-inch drive.
R E V 1 .0 · F I R MWA R E V 1 | 3

D I S K H A M R OW N E R ’ S G U I D E | S E CT I O N 1

## 1 What this is, continued

The UniDisk 3.5 is Apple’s 800K floppy drive for the Apple II. Inside it are a Sony mechanism and a controller board, Apple part IF-83 (service part 661-0307). When the controller board fails there is no repair path: it is built around a Sony gate array with no datasheet and no replacement.

Disk Hamr replaces the whole controller board. The mechanism, the case, the front panel, the LED, the eject button and the drive’s own cables stay. The board speaks SmartPort to the Apple and drives the Sony mechanism directly. The firmware is new code on an RP2350. The original drive’s ROM served as a reference for protocol, status codes and timing.

How it was built. Every step from the first power-up of a bare mechanism to the board in your hands is written up, with scope traces, Apple screenshots and the mistakes, on the project page: bytehamr.com/projects/unidisk-controller. Section 10 of this manual is the short version, with a link to each log.

T E S T E D O N | U N T E S T E D

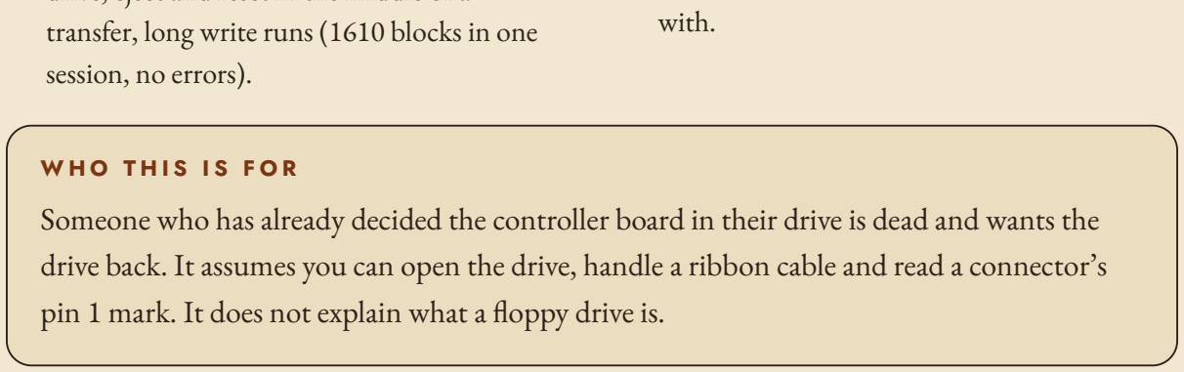
[picture p67: figure]
session, no errors).; with.

Someone who has already decided the controller board in their drive is dead and wants the drive back. It assumes you can open the drive, handle a ribbon cable and read a connector’s pin 1 mark. It does not explain what a floppy drive is.

Apple IIe with the Liron card (Apple 3.5 Disk Controller), ProDOS.
800K double-sided ProDOS disks: boot, read, write, format, catalog, copy.
Daisy chain: Disk Hamr in front of a stock UniDisk 3.5, and behind one.
Disk swaps, write-protected disks, empty drive, eject and reset in the middle of a transfer, long write runs (1610 blocks in one

Apple IIc (with the UniDisk 3.5 ROM) and Apple IIgs (built-in disk port). Both talk the same SmartPort protocol, so it should work. It has never been plugged into either.
Macintosh disks (524-byte blocks) and 400K single-sided disks. Out of scope by design. Any mechanism other than the Sony 800K double-sided unit the UniDisk 3.5 shipped
R E V 1 .0 · F I R MWA R E V 1 | 4

D I S K H A M R OW N E R ’ S G U I D E | S E CT I O N 2
2

S E CT I O N T W O

# In the box

Not included: a micro-USB cable. You only need one for a firmware update, and you already have one.

PHOTO

F I G 2- 1 Box contents on the bench: board, ribbon, QR card.

Disk Hamr rev 1.0, assembled and tested, firmware v1 loaded.

One 20-way ribbon cable, IDC socket at both ends. It connects Disk Hamr’s mechanism header (J2) to the mechanism’s own 20-pin header. The IF-83’s mechanism ribbon ends in a flat connector that does not fit a shrouded header, so this cable replaces it.
This manual, as a QR code to the PDF.
R E V 1 .0 · F I R MWA R E V 1 | 5

D I S K H A M R OW N E R ’ S G U I D E | S E CT I O N 3
3

S E CT I O N T H R E E

# Before you start

The drive’s cables carry three power rails.

The DB-19 and the ribbon from it carry +5 V, +12 V and −12 V next to signal lines. The mechanism ribbon carries +5 V and +12 V. A ribbon plugged in backwards or off by one row puts a supply on a signal pin.

M A RKE D E D G E , P I N 1

P I N 1

KE Y N OTC H

F I G 3- 1 Ribbon cables have a red or marked edge on pin 1; shrouded headers have a key notch.

During development a homemade DB-19 adapter put −12 V on a signal line (the log). (https://bytehamr.com/projects/unidisk-controller/logs/m6-a-loose-strand-put-12-v-on-wrreq/) It destroyed the IWM chip on the Liron card, which then had to be replaced with a donor. (https://bytehamr.com/projects/unidisk-controller/logs/the-liron-card-runs-on-a-unidisk-s-iwm-now/) That chip is socketed and a donor was found, but it is the most expensive mistake available in this job and it is entirely avoidable.

Static. The board has a bare RP2350 module and CMOS level shifters. Touch the chassis before you touch the board.

Use the drive’s own cables and the ribbon in the box. Do not improvise a DB-19 adapter. Match pin 1 on every connector before you push it home. Ribbon cables have a red or marked edge on pin 1; shrouded headers have a key notch; the mechanism header has a pin 1 mark.
Power off the Apple before plugging or unplugging anything on the disk port.
R E V 1 .0 · F I R MWA R E V 1 | 6

D I S K H A M R OW N E R ’ S G U I D E | S E CT I O N 4
4

S E CT I O N F O U R

# Is the board really dead?

Most “dead” UniDisks have dirty heads or a dry carriage rail, so start there: isopropyl on the heads, a drop of light oil on the rail, and try the disk again.

Here is how I knew mine were dead. With the drive plugged into the Liron card, the Apple wouldn’t boot ProDOS from any disk at all, including a Disk II in another slot. The board was holding a line on the SmartPort bus and nothing could get past it. Unplug the drive and the Apple boots again. Two of my drives did exactly that, and cleaning changed nothing.

If you see the same thing, the board is the problem. It doesn’t matter which chip on it failed, since the gate array in the middle of it has no datasheet and no replacement, and that’s why this project replaced the whole board instead of repairing it (Going around the CXD1013). (https://bytehamr.com/projects/unidisk-controller/logs/going-around-the-cxd1013/)

If the Apple boots fine with the drive attached and the drive just never spins or never reads, the mechanism is the more likely suspect, and a new controller board won’t change that.

R E V 1 .0 · F I R MWA R E V 1 | 7

D I S K H A M R OW N E R ’ S G U I D E | S E CT I O N 5 · S T E P S 1 A N D 2
5
S E CT I O N F I V E

# Replacing the board

Tools: a Phillips screwdriver. Nothing else.

1 Open the drive. Four screws on the underside, lid lifts off toward the rear.

PHOTO 5a

F I G 5- 1 The drive on the bench, lid on, rear toward the camera, the four underside screws visible or called out.

### 2 Unplug four cables from the IF-83. Front-panel LED lead (2 pins), eject button lead (3

pins), the ribbon from the front DB-19 (20 way), and the mechanism ribbon (20 way, flat connector). Note which way each one faces.

PHOTO 5b
This is the photo the whole section hangs on.

F I G 5-2 Lid off, the IF-83 in place with all four cables attached and labeled.

R E V 1 .0 · F I R MWA R E V 1 | 8

D I S K H A M R OW N E R ’ S G U I D E | S E CT I O N 5 · S T E P S 3 A N D 4

## 5 Replacing the board, continued

### 3 Unscrew the IF-83. Four M3 screws into the standoffs. Keep the screws; Disk Hamr uses

the same holes.

PHOTO 5c

F I G 5-3 Old board out, standoffs visible.

### 4 Set the old mechanism ribbon aside. It stays with the IF-83. The mechanism end of the

new ribbon goes where it was: pin 1 to pin 1.

PHOTO 5d

F I G 5-4 New ribbon seated on the mechanism header, pin 1 edge and the header’s pin 1 mark both visible.

R E V 1 .0 · F I R MWA R E V 1 | 9

D I S K H A M R OW N E R ’ S G U I D E | S E CT I O N 5 · S T E P S 5 A N D 6

5 Place Disk Hamr on the standoffs, rear DB-19 through the case opening. Four screws. The outline and the rear connector were fitted with 3D prints before the board was made (outline, (https://bytehamr.com/projects/unidisk-controller/logs/the-pcb-outline-fitted-with-a-3d-print/) DB-19, (https://bytehamr.com/projects/unidisk-controller/logs/m7-2-the-rear-db-19-fitted-with-a-3d-print/) populated board). (https://bytehamr.com/projects/unidisk-controller/logs/disk-hamr-printed-fitted-ordered/)

PHOTO 5e

F I G 5-5 Disk Hamr screwed down, no cables yet.

### 6 Plug in the four cables. The silk on Disk Hamr labels each header by its reference; the

two 20-way headers sit at the top edge of the board, the two small ones on the tab beside the rear DB-19:

PHOTO 5f

F I G 5-6 All four cables in, labeled J2, J3, J4, J5.

J2, top left: the new ribbon from the mechanism. Shrouded, keyed.
J3, top right, under the rear DB-19: the ribbon from the front DB-19. Shrouded, keyed. J5, the 2-pin header on the tab: the front-panel LED lead. The shroud only lets it in one way. J4, the 3-pin header beside it: the eject lead. Same.
R E V 1 .0 · F I R MWA R E V 1 | 10

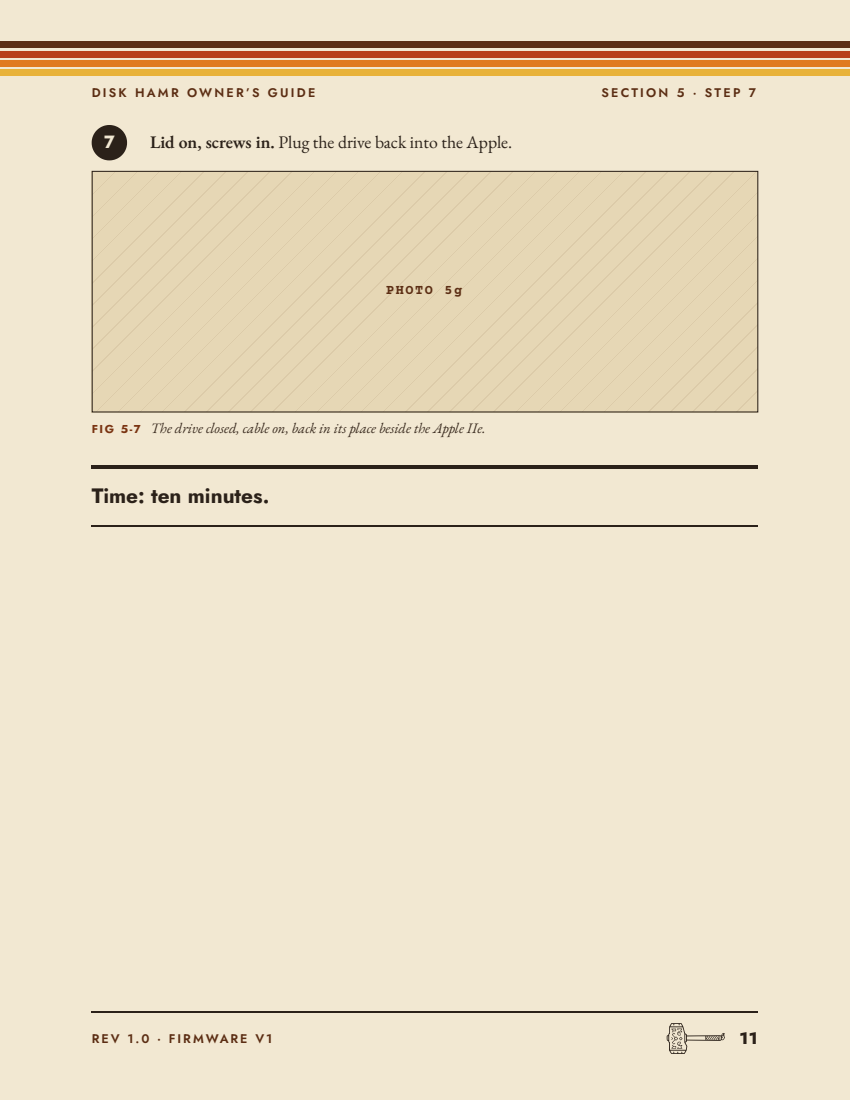
[picture p68: page 11]
PHOTO 5g; R E V 1 .0 · F I R MWA R E V 1

7 Lid on, screws in. Plug the drive back into the Apple.

F I G 5-7 The drive closed, cable on, back in its place beside the Apple IIe.

Time: ten minutes.

D I S K H A M R OW N E R ’ S G U I D E | S E CT I O N S 6 A N D 7
6
S E CT I O N S I X

# First boot

Plug the drive into the Liron card’s DB-19, or into the rear port of another drive. Turn the Apple on.

If the Apple does not boot and the drive is the only thing on the bus, go to section 8.
7
S E CT I O N S E V E N

# Daisy chain

The rear DB-19 is a full SmartPort pass-through. Disk Hamr can sit in front of a stock UniDisk 3.5 or behind one; both orders are tested (the chain log). (https://bytehamr.com/projects/unidisk-controller/logs/m8-the-daisy-chain-once-5v-reached-the-second-drive/) The Apple numbers the drives in cable order: the one plugged into the card is D1, the next is D2.

Liron card

D1
Disk Hamr

D2
stock UniDisk 3.5

N OTHIN G O N
ITS REAR
P O RT

F I G 7- 1 The one plugged into the card is D1, the next is D2.

Chain rules are the same as for the original:

The front LED lights while the drive is being accessed and goes out between accesses. It flickers through a boot and a catalog.
PR#5 (or whichever slot the Liron card is in) boots from the disk in the drive. ProDOS lists it as an 800K SmartPort device in that slot.
The eject button ejects the disk, at any time, as the original did.

The last drive in the chain has nothing on its rear port. Disk Hamr senses this (the LASTONE line on rear pin 16) and tells the Apple it is the last device.
A drive further down the chain only becomes visible after the one in front of it has been initialized, which the Apple does at boot. Plugging a drive onto the rear port after boot needs a reboot.
R E V 1 .0 · F I R MWA R E V 1 | 12

D I S K H A M R OW N E R ’ S G U I D E | S E CT I O N 8
8

S E CT I O N E I G H T

# If it does not work

In order, stopping when it works.

1 Apple will not boot at all with the drive attached. Power off. Reseat J3 (the ribbon from the front DB-19) and check its pin 1 edge. Reseat the DB-19 cable at the Liron card.

### 2 Apple boots, drive never spins. Power off. Reseat J2 at both ends, pin 1 to pin 1. A

reversed mechanism ribbon is the most likely cause of a dead-quiet drive.

### 3 Drive spins, Apple says I/O error. Try a known-good disk. Clean the heads. Try the disk

in a working drive if you have one.

### 4 LED never lights but everything works. The LED lead is in J5 the right way around by

the shroud, so check the LED board itself and its lead.

### 5 Eject button does nothing. Reseat J4. The button is a changeover switch; Disk Hamr

reads the contact that closes when pressed.

Still stuck: open an issue on the repository with what the Apple shows, which slot the card is in and what else is on the chain.

[REPOSITORY URL]

R E V 1 .0 · F I R MWA R E V 1 | 13

D I S K H A M R OW N E R ’ S G U I D E | S E CT I O N 9
9

S E CT I O N N I N E

# Firmware

The board ships with firmware v1, the code that passed the bench milestones. It needs nothing from you, and the plan is that it never will.

If a later version does ship, know this first: updating means taking the board out of the drive. The Pico’s USB jack and its BOOTSEL button face the inside of the case and can’t be reached with the board on its standoffs, so an update is section 5 in reverse, the whole board out, then the swap again. There is no update port on the case and I’m not adding one; a drive from 1985 with a USB socket in the back is a different project.

With the board out:

1 Unplug the drive from the Apple before anything else.

### 2 Hold the BOOTSEL button on the Pico module, plug a micro-USB cable from the Pico

to a computer, release the button. A drive called | RP2350 | appears.
3 | Drag the new | .uf2 | file onto it. The drive disappears when it is done.

### 4 Unplug USB, put the board back in (section 5, steps 5 to 7), plug the drive back into

| the Apple.

If you work out a tidy way to do this without the teardown, a cable routed to a spare opening, a part, a bracket, send it. I’ll link it from the project page.

Source, schematic and firmware: [REPOSITORY URL] . MIT license. Build it yourself with the Pico SDK; the README covers it.

R E V 1 .0 · F I R MWA R E V 1 | 14

D I S K H A M R OW N E R ’ S G U I D E | S E CT I O N 1 0
10

S E CT I O N T E N

# How it was built

Disk Hamr started as a Pico 2 and five level-shifter boards on a breadboard, wired to a mechanism from a dead UniDisk. It was brought up in nine milestones on the bench, each one logged with scope captures and Apple screenshots:

M0 (https://bytehamr.com/projects/unidisk-controller/logs/m0-the-strobe-on-every-power-edge/) and M1 (https://bytehamr.com/projects/unidisk-controller/logs/m1-the-mechanism-answers/) | Power-up behavior of the mechanism, then status reads.
M2 and M3 (https://bytehamr.com/projects/unidisk-controller/logs/m2-m3-the-whole-disk-once-5v-got-there/) | Motor, seek and eject, then raw flux capture decoded on a Mac.
M4 (https://bytehamr.com/projects/unidisk-controller/logs/m4-the-board-reads-the-disk-itself/) | Whole-disk reads on the board itself.
M5 (https://bytehamr.com/projects/unidisk-controller/logs/m5-the-unidisk-reads-a-disk-my-board-wrote/) | Writes and formats. A disk written by Disk Hamr was read back by a working UniDisk, and the other way around.
M6 | SmartPort on the RP2350. The Liron card’s first packet, (https://bytehamr.com/projects/unidisk-controller/logs/m6-the-liron-s-first-packet-reaches-my-board/) then ProDOS booting from a RAM disk (https://bytehamr.com/projects/unidisk-controller/logs/m6-prodos-boots-from-my-board/) through the card.
M7 (https://bytehamr.com/projects/unidisk-controller/logs/m7-a-real-floppy-through-the-liron-card/) | ProDOS booted from a real floppy. Every block the Apple read through Disk Hamr was compared byte for byte against the same disk in a working UniDisk, with the disk in, write-protected and with no disk.
M8 and M9 (https://bytehamr.com/projects/unidisk-controller/logs/m8-the-daisy-chain-once-5v-reached-the-second-drive/) | Daisy chain with the working UniDisk, both orders, a full 800K disk copied across and booted from the copy. Then disk swaps, swap-then-write, write-protected disks, empty drive, eject and resets mid-transfer, 1610 block writes without an error.
The board | Routed, (https://bytehamr.com/projects/unidisk-controller/logs/disk-hamr-the-pcb-is-routed/) laid out again by hand, (https://bytehamr.com/projects/unidisk-controller/logs/disk-hamr-laid-out-again-by-hand-this-time/) printed, fitted and ordered. (https://bytehamr.com/projects/unidisk-controller/logs/disk-hamr-printed-fitted-ordered/)

The board itself was measured against a real IF-83: connector positions, the LED circuit (180 Ω pull-up, transistor sink), the eject switch wiring, and the rear-port pinout, all with a meter on the original board. The layout was printed five times and fitted in the case with the mechanism before any copper was ordered.

All of it, with photos, scope traces and the things that went wrong: bytehamr.com/projects/unidisk-controller.

R E V 1 .0 · F I R MWA R E V 1 | 15

11

# Specifications

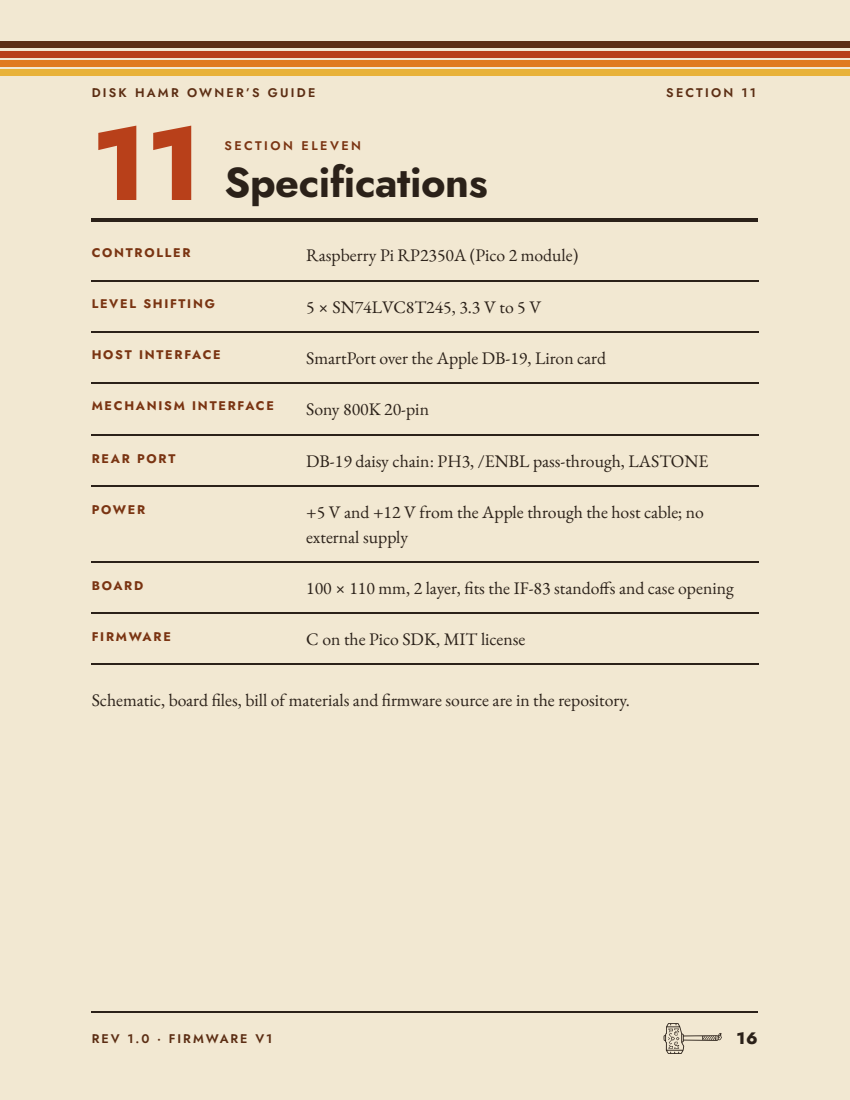
[picture p69: page 16]
C O NTR O L LER; Raspberry Pi RP2350A (Pico 2 module); LEVEL SHI FTIN G; 5 × SN74LVC8T245, 3.3 V to 5 V; H O ST INTERFACE; SmartPort over the Apple DB-19, Liron card; MECHANISM INTERFACE; Sony 800K 20-pin; REAR P O RT; DB-19 daisy chain: PH3, /ENBL pass-through, LASTONE; P OWER; +5 V and +12 V from the Apple through the host cable; no; external supply; B OARD; 100 × 110 mm, 2 layer, fits the IF-83 standoffs and case opening; F IRMWARE; C on the Pico SDK, MIT license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

Schematic, board files, bill of materials and firmware source are in the repository.

# Disk Hamr

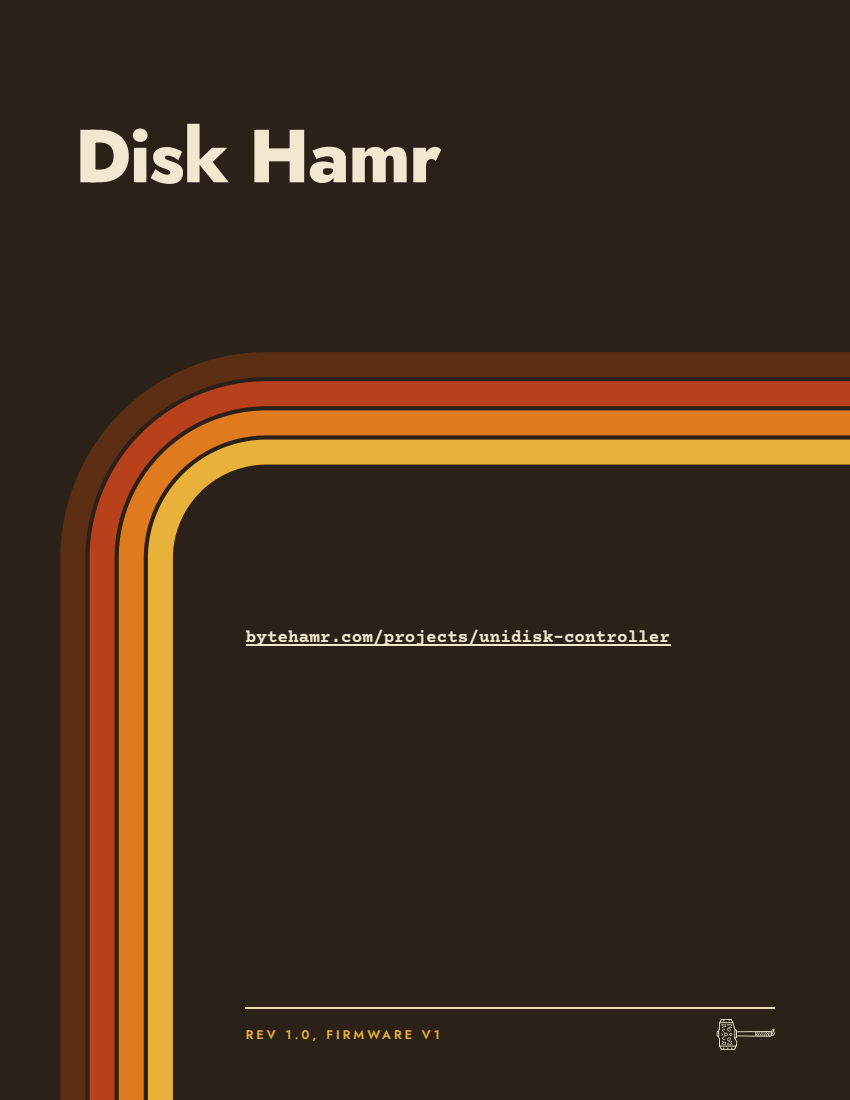
[picture p70: page 17]

bytehamr.com/projects/unidisk-controller
