robertrico/a2m2053_controller/docs/captures/m4/2026-10-10_bracket_step2_readblk.txt

['server on']
block 0: status 00 soft 00
matches reference
block 1: status 00 soft 00
matches reference
block 23: status 00 soft 00
matches reference
block 400: status 00 soft 00
matches reference
block 900: status 00 soft 00
matches reference
block 1300: status 00 soft 00
matches reference
block 1599: status 00 soft 00
matches reference
