robertrico/a2m2053_controller/docs/captures/m4/2026-10-10_step6_errors.txt

readblk 1600
ERR bad command (try help)
status 1
ERR server on
server off
OK
status 1
ERR oe off
OK
BLK 0 af 00
OK
OK
