robertrico/a2m2053_controller/docs/photos/m6/2026-10-11_liron-if98-solder-side.jpg

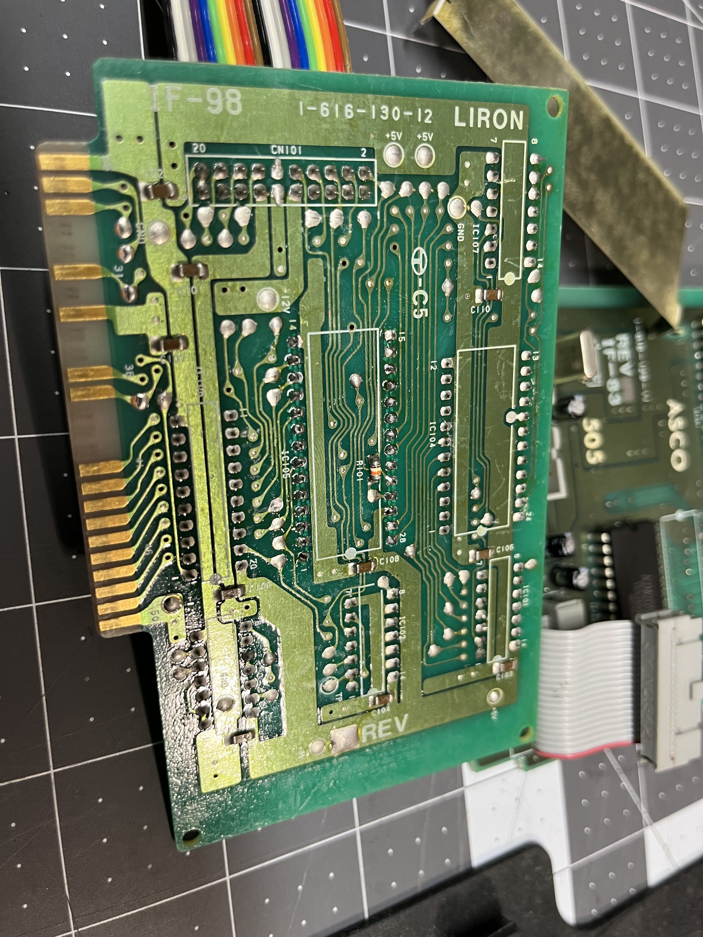
docs/photos/m6/2026-10-11_liron-if98-solder-side.jpg
