robertrico/a2m2053_controller/docs/captures/m3/2026-10-10_rd_testpoint_rddata0_flat_5us.png

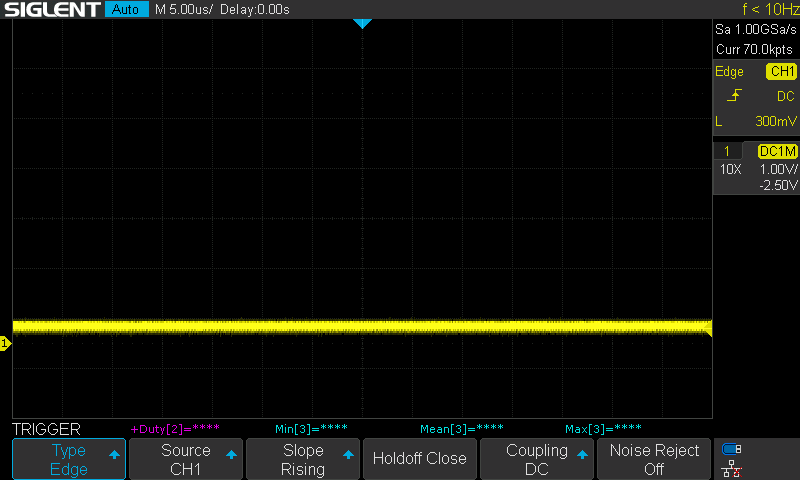
docs/captures/m3/2026-10-10_rd_testpoint_rddata0_flat_5us.png
