robertrico/a2m2053_controller/docs/photos/m05/2026-10-11_drive-a-bracket_test-write-disk.jpg

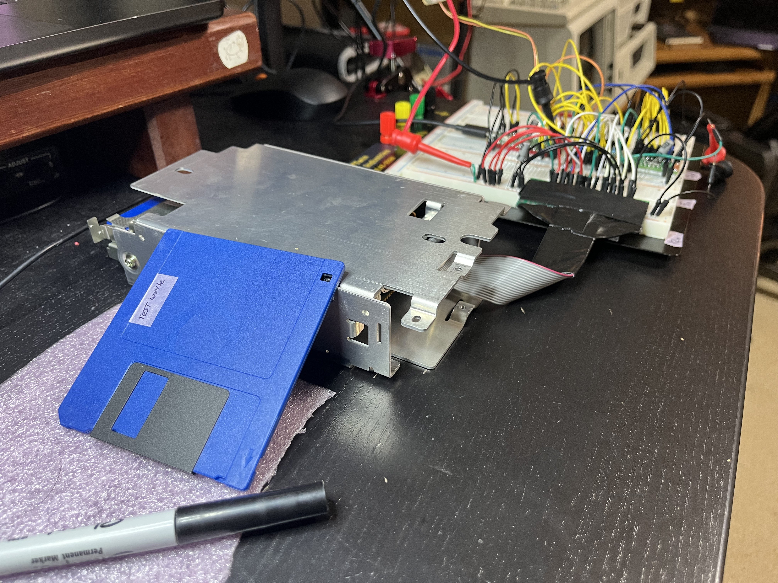
docs/photos/m05/2026-10-11_drive-a-bracket_test-write-disk.jpg
