robertrico/a2m2053_controller/docs/build_log/m4.md

# M4: blocks read on the board

Date: 2026-10-10. Plan: `docs/superpowers/plans/2026-10-10-m4-board-read.md`, Task 9.
Spec: `docs/superpowers/specs/2026-10-10-m4-board-read-design.md`.
Firmware: branch `m4-board-read` at `4908f0a`. Drive A only. REF800K floppy, tab protected.

**Result: PASS.** The RP2350 decodes 800K Apple GCR itself. The whole disk reads
byte-identical to REF800K in 26.1 s.

## Step 1: regression with the server off

`docs/captures/m4/2026-10-10_step1_regression.txt`. Drive ID 800K (DRVIN=0,
SIDES=1, REVISED=1), disk in, protected; motor, recal, seek 40 OK; tach 470 rpm
(zone 3, ERS 472).

## Step 2: single blocks

`docs/captures/m4/2026-10-10_step2_readblk.txt`. Blocks 0, 1, 23, 400, 900, 1300,
1599 (all five zones, both sides): status 00, soft 00, each matches REF800K.

## Step 3: whole disk, Drive A

```
readdisk: 26102 ms, decode 1179 ns/interval (mean), ring backlog max 37 of 8192,
          0 failed track sides, 0 with soft errors
compare vs REF800K.po: 0 blocks differ []
```

Image SHA-256 equals REF800K's (`bfed064f...657742ab`).
`docs/captures/m4/2026-10-10_step3_readdisk_driveA.txt`.

| | M3 (decode on the Mac) | M4 (decode on the RP2350) |
|---|---|---|
| Whole disk | 2 min 12 s | 26.1 s |
| Blocks | 1600/1600 | 1600/1600 |

## Step 4: decode headroom

Mean decode 1179 ns per flux interval (budget 2000 ns: one interval per 2 us at
the worst-case rate). DMA ring backlog peaked at 37 of 8192 intervals, so core 1
never fell behind. Pass. Below the plan's 1500 ns watch line but not far: at the
worst-case rate core 1 would be about 60 % busy; M5 adds encoding work.

## Step 5: Drive B

Skipped (Drive A only).

## Step 6: error paths

`docs/captures/m4/2026-10-10_step6_errors.txt`.

| Check | Result |
|---|---|
| `readblk 1600` | `ERR bad command` |
| mechanism command with the server on | `ERR server on` |
| `server off` | `OK`; outputs off afterwards (`status` -> `ERR oe off`) |
| eject (server off), then `server on` + `readblk 0` with no disk | `BLK 0 af 00`, no mechanism movement |

## Bench findings

### OpenOCD left core 1 debug-halted

After `make flash` / `make reset`, `server on` reported `ERR server did not
start`. Core 1 sat in the boot ROM (PC 0xda, SP 0xf0000000). A cold power cycle
fixed it; `multicore_reset_core1()` before launch did not. Cause: OpenOCD attaches
to both cores (SMP) and leaves core 1 halted under debug. Fix: `set USE_CORE 0`
in the Makefile's OpenOCD config (`4908f0a`); `server on` then works straight
after a reset. The core-1 reset before launch stays (`51f9ff7`, harmless).

### Read data vanished again: disk touching the desk

Mid-session every block came back `0xA7` with only `SOFT_RECAL` set: the decoder
saw no headers at all. The M3-era one-shot `capture` also returned 0 intervals,
and so did the M3 firmware (`e8fc67a`, flashed for an A/B test), so the M4 code
was cleared. Supply voltages at CN104 were normal. The spinning disk was found
touching the desk. After freeing it, flux came back (100000 intervals, 12/12
sectors) and every M4 step passed.

Working theory [guess]: the mechanism mutes RD while spindle speed is out of
tolerance, so drag (or the M3 +5V sag) silences reads instead of corrupting them.
Check next time flux disappears: `tach` and `status 13` (READY). Bench fix: mount
the mechanism so the hub and disk can't touch anything.

## Retest with the mechanism in a bracket

Drive A was mounted in a bracket so the hub and disk can't touch anything, then
reran steps 1 to 3 on `main` (`04ce33c`, same firmware as the pass above).

The first `make flash` failed before anything was erased: OpenOCD's flash ROM
calls timed out (`failed to exit flash XIP mode`) and the QSPI flash ID read back
garbled (`0x0316ef`, then `0x16ef00`), at 5 MHz and at 1 MHz SWD. SWD itself
connected (DPIDR 0x4c013477). A power cycle of the Pico (mechanism supply off
first) cleared it, and the next flash verified OK.

| Step | Result |
|---|---|
| 1 regression | Same as the first pass: 800K ID, disk in, protected, tach 470 rpm at track 40 |
| 2 single blocks | 0, 1, 23, 400, 900, 1300, 1599: status 00, soft 00, all match |
| 3 whole disk | 26101 ms, decode 1179 ns/interval, backlog max 36 of 8192, 0 failed, 0 soft; 0 blocks differ; SHA-256 equals REF800K |

Captures: `docs/captures/m4/2026-10-10_bracket_step{1,2,3}_*.txt`.

## Open

- Drive B whole-disk read (skipped today).
- Decode headroom 1179 ns/interval: watch it in M5 (encode + write).
- Deferred minors from the reviews (in the SDD ledger): core 1 stack for M5,
  encode-side masking, test-depth items.
- Next: M5, write and format.
