robertrico/a2m2053_controller/docs/build_log/m6.md

# M6: SmartPort on the RP2350

Started 2026-10-11. **Paused 2026-10-11** after a bench failure: a homemade
DB-19 adapter bridged -12 V onto a host signal, burned U1 and damaged the
Liron card's IWM. Resumes when proper IDC breakouts arrive and the Liron card
is repaired. No M6 firmware yet; design (spec) not written yet.

## What I tried

Wire the host side (DB-19 from the Liron card) to the prototype for the first
time: 7 host inputs on U1, RD and ACK on a new U3, through a homemade
DB-19-to-breadboard adapter.

### DB-19 breadboard adapter

The adapter brings the DB-19 out on a ribbon in interleaved order. Strip
position (along the breadboard) to DB-19 pin:

| Pos | 1 | 2 | 3 | 4 | 5 | 6 | 7 | 8 | 9 | 10 | 11 | 12 | 13 | 14 | 15 | 16 | 17 | 18 | 19 | 20 |
|---|---|---|---|---|---|---|---|---|---|---|---|---|---|---|---|---|---|---|---|---|
| DB-19 | 1 | 11 | 2 | 12 | 3 | 13 | 4 | 14 | 5 | 15 | 6 | 16 | 7 | 17 | 8 | 18 | 9 | 19 | 10 | - |
| Signal | GND | PH0 | GND | PH1 | GND | PH2 | GND | PH3 | -12V | /WRREQ | +5V | N/C | +12V | /HSTEN | +12V | RD | N/C | WR | ACK | - |

The Apple rails (positions 9, 11, 13, 15) sit between signal positions. They
stay unconnected; the board runs from the bench supply. This interleave is what
made the failure below possible.

### Host-side wiring

Pico pins are physical pin numbers. Shifter silk is 1-indexed (A1-A8, B1-B8).

| Board | Silk | Signal | Strip pos | Pico pin (GPIO) | B-side pull |
|---|---|---|---|---|---|
| U1 (B->A) | B1-B4 | PH0-PH3 | 2, 4, 6, 8 | 4, 5, 6, 7 (GP2-5) | 10k to GND |
| U1 | B5 | /WRREQ | 10 | 9 (GP6) | 10k to +5 |
| U1 | B6 | /HSTEN | 14 | 10 (GP7) | 10k to +5 |
| U1 | B7 | WR | 18 | 11 (GP8) | 10k to GND (100k since 2026-10-12) |
| U1 | B8 | mechanism RD | CN104 16 | 26 (GP20) | 10k to +5 (M0) |
| U3 (A->B) | B1 | RD | 16 | 14 (GP10) | none |
| U3 | B2 | ACK | 19 (J1.20 since 2026-10-12) | 12 (GP9) | 10k to +5 |

U3: DIR to VCCA, /OE = Pico pin 15 (GP11) with 10k to 3V3, unused A pins to
GND. ACK rides U3 with RD and is released with it, the way the original drive
gates both with ENBUS. No 74LVC1G07 (never on hand; dropped).

## What I measured

- Adapter: DB-19 pins 1-4 beep to GND; power pins isolated with the adapter
  alone. Beep tests between rails with the adapter plugged into the Liron, or
  at the IIe PSU connector, are meaningless (bulk caps and board loads read as
  a short while they charge). IIe chip VCC to the +5V position: about 0 ohm;
  to +12V: 750 ohm (load path).
- Rails at the strip, Liron card in, IIe on, nothing on the breadboard:

| Pos | DB-19 | Rail | Measured |
|---|---|---|---|
| 9 | 5 | -12V | -11.98 V |
| 11 | 6 | +5V | 4.80 V |
| 13 | 7 | +12V | 12.3 V |
| 15 | 8 | +12V | 12.3 V |

- `PR#5` with no drive: `NO DEVICE CONNECTED`, as `liron-if.asm` predicts
  (INIT gets no ACK, unit count 0, boot read returns `stat_no_drive`). The
  first try hung with a DMM probe on the adapter; likely the floating ACK line
  [guess]. The ACK pull-up on our side is required.
- Powered, no Apple (bench supply about 5.0 V, M5 firmware): U3 /OE 3.3 V
  (Hi-Z), ACK at +5, PH0-3 and WR at 0 V, /WRREQ and /HSTEN at +5. As expected.

## What broke

### U1 burned on first Apple connect

- Adapter on the Liron, bench supply on, then the IIe on. U1 (8T245) smoked:
  cracked package, burn across the die (latch-up into a VCC-GND short). The
  IIe kept working.
- **Root cause:** a loose wire strand on the adapter bridged strip pos 9
  (-12 V) to pos 10 (/WRREQ, U1 B5). -12 V on a B input drives the input clamp
  hard; the chip latched up. Photo:
  `docs/photos/m6/2026-10-11_adapter-stray-strand-pos9-pos10.jpg`.
- Contributing: pull-up resistors with long bare leads arched over the shifter
  module (`2026-10-11_u1-resistor-leads-over-module.jpg`).
- Process gap: the Apple-rail isolation checks (each rail position vs its
  neighbours and every U1 B pin) were not run before the Apple was connected.
  The rail voltage check could not catch it: rails read correctly, and the
  bridge only shows as rail-to-neighbour continuity.
- Pico check afterwards (SWD, internal pull-down then pull-up on GP2-8 and
  GP20, new U1 seated, VCCB unpowered): every pin follows both pulls. Pico
  inputs survived. Console log: `docs/captures/m6/2026-10-11_console.log`.

### Liron card: IWM WRDATA output damaged

- With the working UniDisk back on the Liron (adapter out), the drive is not
  recognised. The IIe boots normally; the drive makes mechanism sounds and its
  LED pulses faintly. The UniDisk was disconnected right away and stays off
  the card until it is repaired.
- Liron DB-19, IIe at the BASIC prompt, nothing attached (DC volts to pin 1):
  rails normal; PH0-3 about 1.3 V; /WRREQ about 1.0 V; /HSTEN 3.92 V; WR about
  0.6 V. No pre-failure baseline, so these idle levels prove nothing on their
  own.
- Diode mode, card pulled from the IIe (red on pin 1): PH0-3 0.825-0.834 V,
  /WRREQ 0.925 V, /HSTEN 0.751 V, ACK 0.87 V, RD 0.866 V, **WR (pin 19) 0**.
- WR traces to IWM pin 8 (WRDATA). Diode mode on the IWM, red on pin 14
  (GND), a dead IF-83 drive board vs the Liron (an earlier 0.643 V for the
  drive board's pin 8 was a misread):

| IWM pin | Signal | Dead IF-83 board | Liron |
|---|---|---|---|
| 13 | D3 | 0.588 | 0.468 |
| 12 | D2 | 0.587 | 0.468 |
| 11 | D1 | 0.588 | 0.468 |
| 10 | D0 | 0.588 | 0.467 |
| 9 | /WRREQ | 0.812 | 0.927 |
| 8 | WRDATA | 0.814 | 0 |
| 7 | /DEV | 0.679 | 0.513 |

  The data pins read uniformly lower on the Liron (board-level difference).
  **The Liron IWM's WRDATA output is dead;** every other pin has its diode. Pin 8 is next to pin 9 (/WRREQ), which took the
  -12 V. With WR dead the host cannot send command packets, which explains the
  UniDisk not being found.

## Lessons

- No homemade connectors carrying live rails next to signals. Proper IDC
  breakouts are on order, one for the host side and one for the mechanism
  side (the homemade CN104 tap has the same weaknesses).
- Before any Apple power, always run the rail-isolation checks: each Apple rail
  position against its neighbours and every signal row. These are never
  trimmed from a checklist.
- Pull resistors: short leads, flat on the breadboard, never over a module or
  header.
- Set a low current limit on the bench +5 for any first connect.

## Next

1. Liron repair: confirm the card's IWM part number matches the donor
   (344-0041-B) and whether it's socketed. Diode-check the donor IWM's output
   pins (1, 2, 27, 28, 8, 9, 19, 20) against the other dead board's IWM. Swap.
2. Test the repaired card without the UniDisk: scope PR#5 for the PH0+PH2 reset
   pulse and FM on WR. Then a write test on the working UniDisk (save a file).
3. Rebuild the host and mechanism sides on the IDC breakouts, rail-isolation
   checks first, low current limit on first connect.
4. Then resume M6 design: RAM disk content (proposed: ProDOS image in flash
   with a RAM write overlay), spec, plan.

## Liron repaired (2026-10-11, same day)

- The Liron card is the Apple 3.5 Floppy Disk Drive Interface Card,
  820-0117-A, board IF-98 (1-616-130-12). Its IWM (IC105) was soldered in.
  It and the donor (also soldered on the IF-83) were desoldered, and a
  28-pin socket fitted at IC105.
- Dead IWM pulled: VF4060-0001 / 344-0041-B, date code 543 V 9012, MEXICO-R.
- Donor fitted: VF4060-0001 / 344-0041-B, 520 V 7539, KOREA-A, from a dead
  IF-83 drive board (same part number).
- Result: with the working UniDisk on the card, the IIe lists S5,D1 /REF800K,
  1600 blocks (`docs/captures/m6/2026-10-11_iie_liron-repaired_volumes.png`).
- Photos: `docs/photos/m6/2026-10-11_liron-*.jpg`, `..._iwm-dead-mexico-vs-donor-korea.jpg`,
  `..._if83-donor-board*.jpg`.
- Cost of the accident: one 8T245 and one IWM (no longer made). One dead
  IF-83 board has given up its IWM.
- Write check: ADTPro sent REF800K from the Mac onto disk 2
  through the repaired Liron and the working UniDisk, and read it back. The card
  writes, so WR and /WRREQ work on the donor IWM.
- Disk 2 no longer holds the M5 board-formatted copy. Re-format it with our
  board once the host side is rebuilt.

## Host side rebuilt on an IDC breakout (2026-10-12)

The homemade DB-19 adapter is replaced by a 2x10 IDC-to-screw-terminal
breakout (J1, IDC20P-B, DIN-rail mount) on a fabricated DB-19-to-IDC20
cable. The cable follows Apple's drive-internal mapping (same as CN102,
research_notes sec. 10): DB-19 n -> J1 2n-1 for 1-9, DB-19 11-19 -> J1
2, 4 ... 18, and **ACK (DB-19 10) -> J1.20**; J1.19 has no wire. The old
adapter had ACK on position 19; U3 B2 now goes to J1.20.

J1 splits the rows: the odd row carries GND and every Apple rail, the even
row carries the signals (plus ACK on 20). -12 V (J1.9) and /WRREQ (J1.10)
are on different rows.

| J1 | DB-19 | Signal | Shifter |
|---|---|---|---|
| 1, 3, 5, 7 | 1-4 | GND | - |
| 2 | 11 | PH0 | U1 B1 |
| 4 | 12 | PH1 | U1 B2 |
| 6 | 13 | PH2 | U1 B3 |
| 8 | 14 | PH3 | U1 B4 |
| 9 | 5 | -12V | - (no wire) |
| 10 | 15 | /WRREQ | U1 B5 |
| 11 | 6 | +5V | - (no wire) |
| 12 | 16 | N/C | - |
| 13, 15 | 7, 8 | +12V | - (no wire) |
| 14 | 17 | /HSTEN | U1 B6 |
| 16 | 18 | RD | U3 B1 |
| 17 | 9 | N/C (HDSEL) | - |
| 18 | 19 | WR | U1 B7 |
| 19 | - | no wire | - |
| 20 | 10 | ACK | U3 B2 |

### Continuity and isolation (beeper, all unpowered)

Setup: IIe off, DB-19 end unplugged from the Liron, Pico and Debug Probe
unplugged, bench supply off.

| Check | Result |
|---|---|
| DB-19 11, 12, 13, 14, 15, 17, 19 -> U1 B1-B7 | all beep |
| DB-19 18 -> U3 B1 (RD), DB-19 10 -> U3 B2 (ACK) | beep |
| DB-19 1-4 -> board GND | beep |
| DB-19 5, 6, 7, 8 (Apple rails) -> every other DB-19 pin | open |
| Bench +5 rail and 3V3 (VCCA) -> DB-19 5-8 | open |
| DB-19 1 (GND) and bench +5 rail -> DB-19 9-19 | open |
| U1 B1-B8 adjacent pairs, U3 B1-B2, B2-B3 | open |
| DB-19 18 (RD) -> DB-19 10-19; DB-19 10 (ACK) -> 11-19 | open |

### First low-power connect (2026-10-12)

Setup: Pico unplugged (VCCA = 0, shifters Hi-Z), mechanism ribbon unplugged,
bench +12 off, bench +5 only (limit 0.05 A), DMM in series in the bench +5
lead. DB-19 plugged into the Liron with the IIe off, then IIe on.

- Bench +5 current: 0.04 mA before and after IIe power-on. No step, no
  back-feed.
- Per board (DMM in series with each VCCB): U1, U2, U3 0.04 mA each.
- The bench supply's own current readout is not usable at this level: it
  showed 0.03 A for a 0.1 mA load, and its 0.01 A limit tripped well below
  10 mA. Use the DMM for small currents; 0.05 A is the practical limit floor.
- A first attempt read 1.43 V in CC at 0.01 A: the mechanism was still on the
  bench +5 through the old CN104 tap. Its logic draws tens of mA on +5 alone.

Levels at J1, reference J1.1, IIe on, bench +5 at 5.15 V:

| J1 | Signal | Measured |
|---|---|---|
| 9 | -12V | -12.16 V |
| 11 | +5V (Apple) | 4.73 V |
| 13, 15 | +12V | 12.38 V, 12.38 V |
| 2, 4, 6, 8 | PH0-3 | about 40 mV, changing (Liron boot scan) |
| 10 | /WRREQ | 5.15 V (idle, our 10k pull-up) |
| 14 | /HSTEN | 5.15 V (idle, our 10k pull-up) |
| 16 | RD | 4.67 V (Liron pull-up; U3 Hi-Z) |
| 18 | WR | 3.56 V (IWM high against our 10k to GND) |
| 20 | ACK | 4.88 V |

Bench +5 was at 5.15 V (5.13 V at VCCB vs J1.1). Lowered to 5.00 V: U3
drives RD and ACK at VCCB, which should not sit 0.4 V above the Liron's
4.73 V supply. The mechanism's +5 margin comes from the J2 rework, not from
a higher setpoint.

### Pico on the host bus: inputs over SWD (2026-10-12)

Pico running `61d4690` (M5 firmware; U3 /OE held high, so RD and ACK stay
off the bus), bench +5 at 5.00 V, IIe at BASIC. Host inputs read from SIO
GPIO_IN (`0xd0000004`) over SWD without halting.

- First read: PH0-3 = 0110 while J1 showed PH2 low (50 mV) and PH3 high
  (3.89 V). The PH2/PH3 jumpers were shifted at the Pico header. Fixed;
  after that the Pico read 0x1e8 on GP2-8 (PH1 + PH3 high, /WRREQ, /HSTEN
  and WR high), matching J1.
- WR idles at 3.56 V on the B side against a 0.7 x VCCB = 3.5 V input
  threshold; it reads 1, but the margin is 60 mV. Check on the scope with
  live FM data.

Live test: 25 s of sampling (99856 reads, about 4 kHz) while typing `PR#5`.
The IIe reports "no device connected" (expected: no SmartPort firmware yet).

| GP2-8 | Reads | State |
|---|---|---|
| 0x1e8 | 99491 | idle: PH1 + PH3 |
| 0x1d4 | 321 | PH0 + PH2: SmartPort reset |
| 0x1c0 | 42 | all phases low |
| 0x1ec | 1 | PH0 (REQ) + PH1 + PH3 |
| 0x1ac | 1 | REQ + PH1 + PH3 with /WRREQ low: host sending a packet |

The reset pulse, REQ and a packet write all reach the Pico. Our 10k
pull-up holds ACK high, so the Liron sees a ready device and starts a
command packet. That packet is what the M6 receiver has to decode.

### WR on the scope during PR#5 (2026-10-12)

Scope: CH1 J1.10 /WRREQ, CH2 J1.18 WR, CH3 J1.2 PH0 (REQ), 10x, 2 V/div,
trigger CH1 falling 2.52 V, single. Setup and numbers:
`docs/captures/m6/2026-10-12_console.log`.

- Whole packet (`2026-10-12_pr5_wrreq_wr_ph0_500us.png`): /WRREQ low for
  879 us. WR in the packet swings 0.04 V to 4.36 V (median high). WR idle sat
  at **3.40 V**, below the 8T245's guaranteed 3.5 V input-high at VCCB = 5 V,
  with +/-0.25 V noise. After the packet WR decays back to idle over about 1 ms.
- Cause: our 10k pull-down on U1 B7. Changed it to **100k**: idle WR is now
  3.96 V (3.72-4.28 V). From the two idle levels, the host drives WR idle as
  about 4.0 V through about 1.9k, so 4.0 V is the ceiling.
- Packet start (`2026-10-12_pr5_packet-start_20us.png`): REQ (PH0) rises
  7.7 us before /WRREQ falls; the first WR edge comes 3.95 us after. Cell
  width 3.91 us. Decoded (a 1 is a transition): `FF 3F CF F3 FC FF` sync,
  `C3` packet begin, then `81` (destination). This is the standard SmartPort
  command packet, and the same self-sync bytes the 3.5 drive writes as its
  track preamble (M5).

## Next (2026-10-12)

The 2026-10-11 list above is done except the mechanism-side breakout.

1. M6 brainstorm and spec: FM receiver, ACK handshake, RAM disk content
   (proposed: ProDOS image in flash plus a RAM write overlay). The spec also
   replaces the 74LVC1G07 references with "ACK on U3 with RD".
2. Mechanism side on the J2 breakout (arrives 2026-10-13), with the +5 V/GND
   rework and a read scan at 5.0 V.
3. Re-format disk 2 with our board, whenever it's convenient.

## Firmware ready for the bench (2026-10-12)

Spec `docs/superpowers/specs/2026-10-12-m6-smartport-ramdisk-design.md`,
plan `docs/superpowers/plans/2026-10-12-m6-smartport-ramdisk.md`, branch
`m6`. Not yet run on hardware.

What the firmware does:

- Answers the Liron card as a SmartPort device from power-on (`sp on`),
  serving an 800K ProDOS volume: `docs/private/ref/m6_boot800k.po` (PRODOS +
  BASIC.SYSTEM from ProDOS 2.4.1, built with AppleCommander, git-ignored)
  linked into flash, with a 384-block RAM write overlay (lost at power off).
- fm_rx (PIO0 SM0) arms on /WRREQ low and DMAs one bit per 3.911 us cell;
  fm_tx (PIO0 SM1) sends a 0.98 us low pulse per 1. ACK (GP9) and RD (GP10)
  reach the bus only while U3 /OE (GP11) is low.
- INIT takes the ID only when we have none; LASTONE/ (GP1, internal pull-up)
  high makes the INIT reply `$40` ("last"), so the card stops there.
- Console: `sp` (state, counters, ACK latency, host pin levels), `sp on|off`,
  `splog on|off` (one `SPL` line per transaction, on at boot). M5 commands
  are unchanged; while one runs, the bus is not served.

Host tests (no hardware): 12 C test programs and 87 pytest cases pass. A
code review against both ROMs found no protocol bug; it led to an ACK guard
(no ACK once the card has given up, stat `late`), 0.5 us edge blanking in
fm_rx, and more simulated cases (stalled main loop, stray command during a
WRITEBLOCK). The
bus engine runs against a simulated Liron card with the card ROM's
timeouts; the PIO programs run in a cycle model. Model results:
- ACK comes about 1 us before the card's write underrun (`C8` always closes
  an RX chunk half a cell before its cell ends); the card's window is about
  105 us after underrun.
- fm_tx: falling edges on whole 3.911 us cells, pulse 0.98 us, parks high.

### Bench steps

Setup as at the end of the 2026-10-12 session: J1 wired and checked, bench
+5 at 5.00 V, mechanism ribbon unplugged, bench +12 off, U3 fitted with the
ACK pull-up, scope probes on J1.

1. `make -C firmware` (expect "M6 RAM disk image: ..."), then `make -C
   firmware flash`. The flash holds 864 KB, so programming takes longer than
   before.
2. Console tail. `sp`: expect `SP on id=0`, `img=819200`, `ovl=0/384`, and
   pins with the IIe off PH0-3=0, WRREQ=1, HSTEN=1.
3. IIe on (always after the Pico is up: the card sends INIT only once at
   boot; otherwise `PR#5`), card in slot 5. Expect `SPL RESET`, `SPL CMD dest=1 cmd=05` (INIT,
   `st=40`), then STATUS (`cmd=00`) and READBLOCK (`cmd=01 blk=0, 1, ...`), and
   the IIe boots to BASIC.SYSTEM's `]` prompt. If it shows `NO DEVICE
   CONNECTED` instead, run `sp` and note the counters (pkts, acks, cksum, ign,
   tmo).
4. Scope, ACK timing: CH1 J1.10 /WRREQ, CH2 J1.20 ACK, trigger CH1 rising,
   single, during `PR#5`. `measure_delay` CH1 rise to CH2 fall. Expect ACK low
   around the /WRREQ rise (model: about 1 us before). The card gives up
   about 105 us after it.
5. Scope, reply: CH3 J1.16 RD, trigger CH2 (ACK) rising after a command.
   Expect 1 us low pulses on 3.91 us cells, starting about 20 us after REQ
   (J1.2) rises.
6. BASIC: `CATALOG`, `10 PRINT "HELLO"`, `SAVE HELLO`, `CATALOG`, `NEW`,
   `LOAD HELLO`, `LIST`. `sp` shows `ovl` going up by the blocks written.
7. `sp off`, then `PR#5`: `NO DEVICE CONNECTED` (bus released). `sp on`,
   `PR#5`: boots again.

If step 3 fails, the order to look: `sp` pins (PH lines and /WRREQ move?),
`pkts` (fm_rx sees packets?), `cksum` (bits wrong: scope WR against the
3.91 us cell), `acks` but no boot (reply side: scope RD and REQ).

## M6 passed on the bench (2026-10-12)

Firmware on branch `m6`: first run `8649c44`, then `d0a05c1` (splog fix,
rescue reset in `make flash`) and `2e7311a` (hot path in RAM). Console log:
`docs/captures/m6/2026-10-12_m6fw_console.log`. Raw scope CSVs (500 MSa/s)
stay local; screenshots are committed.

### What I measured

- **Boot.** Pico up, board on, IIe on, `PR#5`: ProDOS 2.4.1 booted from the
  board through the Liron card to BASIC.SYSTEM on the first try.
  `CAT` shows `/M6BOOT` (only in our flash image): PRODOS, BASIC.SYSTEM.
  Board side: 150 packets, 150 ACKs, 150 replies; 0 checksum errors, 0
  ignored, 0 timeouts, 0 re-reads; 3 INIT (reply `$40`, ID 1), 3 STATUS,
  144 READBLOCK. (`2026-10-12_iie_prodos-boot-from-board.png`)
- **Write.** `10 PRINT "HELLO"`, `SAVE HELLO`: 5 WRITEBLOCKs, 3 blocks in the
  RAM overlay (file, directory, bitmap), free blocks 1537 -> 1536. `NEW`,
  `LOAD HELLO`, `LIST`, `RUN` prints HELLO.
  (`2026-10-12_iie_hello-load-list.png`)
- **ACK timing** (CH1 J1.10 /WRREQ, CH2 J1.20 ACK, CH3 J1.2 REQ; 10x,
  2 V/div; trigger CH1 rising 2.52 V; 20 us/div; computed from CSV):

| Packet | Firmware | /WRREQ rise to ACK low | ACK low to REQ low |
|---|---|---|---|
| READBLOCK during boot | `8649c44` | 6.68 us | 21.92 us |
| INIT after `PR#5` bus reset | `d0a05c1` (code in flash) | 30.93 us | 9.40 us |
| INIT after `PR#5` bus reset | `2e7311a` (hot path in RAM) | 5.29 us | 23.32 us |

  The card's ACK window ends about 105 us after its write underrun, so the
  margin is now about 100 us. ACK swings 4.72 V to -0.02 V. The ACK probe
  picks up crosstalk spikes from WR (J1.18), well short of the threshold.
- /WRREQ crosses the 8T245's 3.5 V input-high within 0.2 us of the rise
  (3.7 V for about 1 us, 5.0 V after 5 us).

### What broke

- **ACK 31 us late on the first packet after idle.** The engine reported
  -3 us for the same packet: it sampled /WRREQ at the top of its loop, then
  spent the 30 us finishing the last chunk and decoding, so it never saw the
  rise first. Cause [guess, fits the fix]: flash cache misses after a quiet
  bus. Fix: receive, decode, ACK and the pin access run from RAM
  (`__not_in_flash_func`); `ack_us` now uses the last low sample, so it is an
  upper bound (6 us against 5.3 us on the scope).
- **`SPL` lines never printed.** Gated on 96 free bytes; the CDC TX buffer is
  64. Now a line is formatted first and printed when it fits.
- **Flash timed out** on the 864 KB image ("failed erasing sectors 0 to
  216") while core 1 ran from flash; a second try left the flash half
  erased. An OpenOCD rescue reset, then program, worked. `make flash` now
  does the rescue reset first.
- **IIe would not start after a power cycle with the Pico left running**
  (twice; once the Pico's inputs read all ones afterwards). Cold boot of
  everything fixed it each time. Rule from now on: Pico off at shutdown;
  power-up order Pico, board, IIe. Root cause not chased.

### Next

1. M7: the floppy back end behind the same SmartPort engine (REQ_READ /
   REQ_WRITE to core 1), worst-case hold-off measured against the card.
2. J2 breakout for the mechanism side (arrives 2026-10-13), with the +5 V
   rework and a read scan at 5.0 V.
