robertrico/a2m2053_controller/docs/build_log/m7.md

# M7: the floppy behind SmartPort

Started 2026-10-12. Spec
`docs/superpowers/specs/2026-10-12-m7-floppy-behind-smartport-design.md`,
plan `docs/superpowers/plans/2026-10-12-m7-floppy-behind-smartport.md`,
branch `m7`. Built before the J2 mechanism breakout was wired, as if it were.

## Firmware ready for the bench (2026-10-12)

Not yet run on hardware.

What changed from M6:

- SmartPort calls go to a store: the M6 RAM disk or the floppy. The floppy
  store turns each call into a request to the M5 mechanism server on core 1
  and waits; ACK stays low meanwhile, so the card waits too (its reply wait
  has no timeout).
- The mechanism server runs from boot (U2 and U4 enabled, /ENBL low, motor off).
  The disk is the floppy at boot; `sp disk ram` switches back to the M6 RAM
  disk, `sp disk floppy` back again.
- STATUS follows the disk: general byte `$F8`, `$E8` with no disk, `$FC`
  write-protected (ROM `Leda3`). READ/WRITE errors `$2F` no disk, `$2B`
  write-protected, `$2D` bad block, `$27` I/O. A read that needed a retry for
  bad data or a bad address, or found the head on the wrong cylinder, returns
  `$67` with the data (ROM `$E7`).
- CONTROL `$04` ejects (`$27` if the disk stays in). The eject button (wired
  straight to GP22, GND when pressed) is ignored until `ejbtn on`. When on, a 20 ms press
  ejects on release. The LED (GP26) is on while a request runs and while the motor turns.
- A Ctrl-Reset on the IIe during a long seek: the board lets go of the bus at
  once and drops the pending reply, so the card's single INIT try works.
- `imgcopy` writes the flash image to the floppy block by block (verified
  writes, about 13 min at M5 speed [estimate]). It makes a bootable test disk.
- The flash image now also holds `SPCOMPARE` (`tools/apple/SPCOMPARE.bas`,
  built by `tools/apple/mkimage.sh`).
- `splog` lines carry `ms=`, the time core 1 held the card off. `sp` shows
  `disk=`, `server=`, the maximum hold-off and the last mechanism reply.

Host tests: all C test programs pass, including `test_sp_floppy` (the M6
simulated Liron card against the floppy store and the M5 server on the fake
drive: boot reads, a seek to track 79 while the card waits, write, no disk,
write-protect, eject, a card reset during the seek). A code review against
both ROMs led to: sequence numbers on core-1 requests (no wedge after a slow
reply), the reset release above, the ROM's check order (no disk and
write-protect before the block range), `$27` on a failed eject, `$67`
following the ROM's `Z57` bits, and the eject button off by default.

### Bench steps

Prerequisite (HANDOFF): J2 wired, ribbon rung out, isolation checks done
(+12 V against RD, WRTDATA and every signal), heavy +5 V run and the 4.7 uF
caps at the terminals, a clean read scan on drive A at 5.0 V, U2 channel
order checked. REF800K write-protected.

Power order: Pico (USB) first, then bench +5, then +12, then the IIe. At
shutdown everything off, the Pico too.

1. `make -C firmware flash`. Console `sp`: expect `disk=floppy server=on`.
   `oe off` is still the kill switch for the mechanism outputs.
2. REF800K in drive A, IIe on, `PR#5`. REF800K has no PRODOS file, so expect
   ProDOS's "UNABLE TO LOAD PRODOS" (or the card's own message). The `SPL`
   lines should show READBLOCK 0 (and more) with `ms=` values and `s=00`.
   That is the floppy path working end to end.
3. Make a bootable floppy: disk 2 in drive A (tab open; this overwrites disk 2,
   which only holds a REF800K copy), console `imgcopy`, wait for `IMGCOPY END
   00 1600 ...`. Then `PR#5`: ProDOS boots `/M6BOOT` from the floppy.
4. Scope the hold-off: CH1 /WRREQ (J1.10), CH2 ACK (J1.20), trigger CH1
   rising, 50 ms/div, during a `CAT` after a long seek (for example right
   after `PR#5`). ACK stays low for the whole core-1 time; compare with `ms=`.
5. Comparison program: `LOAD SPCOMPARE` (it is on disk 2 after step 3),
   `RUN`. Note the screen. Then with the working UniDisk on the Liron instead
   of our board (same disk 2), `RUN` again; they must match, except our
   STATUS `$05` bytes. Repeat with no disk and with the tab set.
6. Eject: CONTROL `$04` (any utility with an eject, or by hand). The button
   only after the GP22 wiring is settled, then `ejbtn on`.
7. Ctrl-Reset during a read that moves the head (for example `CAT` right after
   swapping to a far track): the IIe recovers and `PR#5` still works.
8. Write: in BASIC on disk 2, `SAVE HELLO`, `CATALOG`, power everything off
   and on, `CATALOG` again: the file survives (it is on the floppy now).

Watch item: core 1 now runs its idle loop from flash all the time. Compare
`ack_us` with the M6 value (5.3 us); if it grew, look at flash contention.

If step 2 shows `s=27` on every read: `sp` (mech `st=`, `soft=`), then a
`readdisk` with `server off` as in M4 to separate the mechanism from the
SmartPort side.

## M7 passed on the bench (2026-10-12)

Firmware `525d050`, then `f54d07d` (STATUS `$05` byte 7 = `$FF`, re-send cap).
Mechanism on the old CN104 tap (J2 rework not done yet; beep checks first: no
shorts). Test disk 1 = `/M7TEST`, built by `tools/apple/mktest.sh` and written
by the working UniDisk through ADTPro, so our board reads a disk it did not
write. Console log: `docs/captures/m7/2026-10-12_m7fw_console.log`.

### What I measured

- **Boot from the floppy.** `PR#5`: the STARTUP sentinel `M7 SENTINEL
  2026-10-13 /M7TEST`, then FILE 1-4 OK with the expected 16-bit sums (55487,
  62070, 61550, 61308) and ALL 4 FILES OK. DATA1-3 sit on tracks 2-6, DATA4 on
  track 72. (`2026-10-12_iie_m7test-sentinel-boot.png`) Board side for that
  boot: 223 commands, all `$00` (INIT `$40`), 0 checksum errors, 0 timeouts, 0
  re-reads, ACK 4-6 us after /WRREQ.
- **Write.** Copy II Plus copied README from the slot 6 disk onto `/M7TEST`:
  16 WRITEBLOCKs, all `$00` (blocks 1508-1510 and the directory/bitmap),
  114-725 ms each with the verify revolution. Data packet ACK at most 34 us
  after /WRREQ. (`2026-10-12_iie_copy-readme.png`)
- **Comparison with the working UniDisk** (SPCOMPARE, same disk, both
  drives): identical in all three states once byte 7 of STATUS `$05` returned
  `$FF` like the UniDisk's.

| State | ST0 | Reads (RB0-2) | RB1600 | Both drives |
|---|---|---|---|---|
| Writable | `F8 40 06 00` | `$00`, sums 56491 / 0 / 15100 | `$2D` | identical |
| Write-protected (window open) | `FC 40 06 00` | `$00`, same sums | `$2D` | identical |
| No disk | `E8 40 06 00` | `$2F` | `$2F` | identical |

  ST3 (DIB `DISK 3.5`, type `$01`, version `$10`), ST1 (`$21`) and ST5 match
  in every state. Screens: `2026-10-12_iie_spcompare-{unidisk,ours}-*.png`.
- **Hold-off** (core-1 time per command, `ms=` in the log, 109 commands that
  needed the mechanism): median 198 ms, 90th percentile 595 ms, longest 844 ms
  (a read after the motor had stopped). The card waited through every one;
  no retries, no late ACKs.
- **Eject** from the console (`server off`, `eject`, `server on`): the disk
  came out, and the board then answered `$2F` with an empty drive.

### What broke

- **I/O error on the first try:** READBLOCK 0 returned `$27` after exactly
  2000 ms, the motor spin-up timeout. The bench supply was in current limit
  at the 0.03-0.05 A used for host-side work, so the rail collapsed when the
  motor started. That also dropped the Pico's USB and left U1's outputs
  reading all ones (the board browned out with the mechanism). Fixed by
  setting the limits for the mechanism: about 0.5 A on +5 and 1.0 A on +12
  (motor running: 0.14 A / 0.13 A in M2; eject 0.5 A on +12).
- **190 re-sends during the brown-out:** while the rail sagged, the card held
  REQ high without reading and our re-read path re-sent the stale `$27` reply
  for 10 s. Harmless, but unbounded; capped at 5 re-sends per reply in
  `f54d07d` (matching the card's 5 read tries).
- **"I/O ERROR" with no disk** was `RUN SPCOMPARE` trying to load the program
  from the empty drive: our `$2F` is the right answer, and the UniDisk gives the
  same. `RUN` alone (program in memory) works.

### Next

1. J2 breakout with the heavy +5 V run, caps and the read scan, so the
   mechanism no longer depends on the old tap.
2. M8: daisy chain, our board in front of the working UniDisk and behind it.
3. Wire the front eject button: a plain switch straight to GP22 (no shifter,
   internal pull-up). The firmware on main has it on by default.
