robertrico/a2m2053_controller/docs/build_log/m3.md

# M3: raw flux capture and decode

Date: 2026-10-10. Plan: `docs/superpowers/plans/2026-10-07-m0-m3-mechanism-bringup.md`, Task 12.
Firmware: branch `m3-flux`, `f54d27d` (PIO1 + DMA capture, single-call USB dump).
Tools: `tools/a2mflux.py`, 34 host tests. Status: **PASS** (Step 4: 1600/1600 blocks, byte-identical).

## Reference disk

`/Applications/ADTPro-v.r.m/disks/REF800K.po`, built with AppleCommander, outside
git. /REF800K/, 1600 blocks: DATA0-DATA5 (BIN, 120K each, Python
`random.Random(0xA22053 + i)`) and README. 1453 unique non-zero blocks.
SHA-256 `bfed064fef52e30578723b3c9fcc6768ab52907f4bb1aa4670f70823657742ab`.
Written to an 800K floppy with ADTPro on the working UniDisk. An ADTPro
readback later came back byte-identical, so the media is good.

## Drives

| Tape | Mechanism | Notes |
|---|---|---|
| A | The one M0-M2 ran on | Eject gears cleaned in M2; eject still weak. Primary drive from here on. |
| B | Second dead-board drive | Backup for A/B comparisons. |

## Capture path works first time

First capture: `FLUX BEGIN 0` with a valid CRC, 2.14 s round trip (2 s window
plus dump), so the firmware path and USB dump were fine from the start. The
histogram of the first good capture (Drive A, T0 S0) shows three peaks at
2.0, 4.0 and 6.0 us, which matches the 2.0-count PIO overhead fix.
`probe` confirmed the default byte order GROUP_ORDER = CHECKSUM_ORDER = (0, 1, 2).

## The read failures were the +5V supply path

For most of the session reads failed: 0 intervals, or patchy captures that
dropped out mid-capture and noise-only histograms (0.8-2 us smear).

What it looked like:
- RD on the read-data address (8 / 9) sat at about 0.4 V with ~0.23 V p-p
  noise, at the CN104 pin and at the mechanism's own RD test point.
- Drive A gave patchy data after a head-flex reseat; Drive B gave nothing.
- Status reads, tach, seek, recal and eject all worked throughout.

What it was: resistance in the +5V/GND path between the bench supply and the
drive. With the motor running, CN104 pin 11 measured as low as 4.01 V
(pin 13: 11.57 V); ERS minimum is 4.75 V. The supply stayed in CV, current
well under 0.5 A, so it was IR drop in contacts and jumpers, not a load fault.
Switching either channel moved the other (shared return resistance). After
reworking the contacts, and later adding bulk caps at the tap, both drives
read every sector.

Ruled out along the way: firmware, decoder, disk (readback byte-identical),
write mode (tab protected, no erase), head position, heads lifted.

## 12-track scans (tracks 0, 5, 20, 40, 60, 79, both sides)

| Run | Drive | Result |
|---|---|---|
| scan, scan2 | A, before the power fix | patchy; 11 sectors decoded total, all byte-exact |
| scan_mech2, scan_mech2b | B, before the power fix | 0 intervals everywhere |
| scan3 | B, contacts reworked | 124/124 sectors, all match REF800K |
| scan5_drive2 | B | 124/124, all match |
| scan6_driveA | A | 124/124, all match |
| scan7_driveA_caps | A, bulk caps added at the tap | 124/124, all match |

Every decoded sector across all runs matched REF800K; none misplaced.

## Step 4: full disk, Drive A

`a2mflux.py disk --port /dev/cu.usbmodem114401 --out docs/private/ref/read_800k_driveA.po --compare REF800K.po`

```
1600/1600 blocks good -> ../docs/private/ref/read_800k_driveA.po
compare vs /Applications/ADTPro-v.r.m/disks/REF800K.po: 0 blocks differ []
exit code 0
```

160 track-sides, every one complete on the first try (no retries), 2 min 12 s
(18:35:55 to 18:38:07). The image's SHA-256 equals REF800K's
(`bfed064f...657742ab`). Log: `docs/captures/m3/2026-10-10_full_disk_driveA.txt`.

## Step 4 repeated on Drive B

Same command, `--out docs/private/ref/read_800k_driveB.po`: 1600/1600 blocks
good, 0 differ, exit code 0. 160 track-sides, no retries, 2 min 11 s
(18:39:45 to 18:41:56). SHA-256 equals REF800K's. Log:
`docs/captures/m3/2026-10-10_full_disk_driveB.txt`.

Both test-bed mechanisms read the whole disk byte-identical.

## Design requirement for the PCB

The drive's +5V and +12V and GND need low-resistance paths: wide traces or
pours from the input connector to CN104, all four CN104 GND pins tied, and
bulk capacitance at CN104 on both rails, as the original IF-83 board has:
4.7 uF 50 V electrolytic (read off the IF-83). Use the same part.
The read amplifier fails silently when +5V sags at the connector.
