robertrico/a2m2053_controller/docs/build_log/m1.md

# M1: mechanism status reads

Date: 2026-10-10. Plan: `docs/superpowers/plans/2026-10-07-m0-m3-mechanism-bringup.md`, Task 10.
Firmware: branch `m1-console` at `c5e1deb` (Tasks 6 and 7), flashed over SWD,
Verified OK. Console on `/dev/cu.usbmodem114401`, driven by a small script
(pyserial is not installed).

## Firmware built for M1

Two plan tasks, each implemented by a subagent and checked by a separate
review, then one review over the whole branch (`d2a080f..c5e1deb`).

| Commit | What |
|---|---|
| `b3195a0` | Mechanism register map and sequences behind a 4-function bus (`mech_bus_t`): status, command, step, recal, seek, motor, eject, head select. Host-tested with a fake bus. |
| `4bce641` | Fix: motor turned off when spin-up times out |
| `89882d1` | USB console, GPIO mechanism bus, `_Static_assert` that the bus mask can't include GP18 (/WRTGATE) |
| `b524a8b` | Fix: over-long console lines rejected instead of truncated |
| `bb36c53` | Console echo and backspace; READY timeout 0.5 s -> 1 s |
| `c5e1deb` | Plan fix: settle-time scope steps, power rule for Task 10 |

Host tests: crc32 3/3, mech 75/75, console 33/33, check_wrtgate ok. No
compiler warnings from `src/`.

What the reviews caught, all in code or text copied from the plan:

- `mech_motor(on)` returned "not ready" after a 2 s spin-up timeout and left
  the motor running. It now sends MOTOR_OFF first.
- `read_line` kept the first 79 characters of a longer line and ran them, so
  `motor on` followed by junk would still turn the motor on. Over-long lines
  now get `ERR line too long` and nothing runs.
- The plan's settle-time step scoped CA0 while toggling `status 1` and
  `status 0`. Those addresses differ only in SEL, so CA0 would never move.
  Rewritten to use `status 12` / `status 14`, which differ only in CA0.
- The ERS gives 500 ms max for READY after stepping at full rate; the plan
  used exactly 500 ms. Raised to 1 s.
- Without echo, `screen` showed nothing while typing. The firmware now echoes
  and handles backspace.

Smaller items are deferred to M2/M3; the list is in the SDD ledger.

Bench safety carried from M0: the firmware can now hold /ENBL low, so the
LSTRB strobe the 8T245 makes on a Pico power edge could reach a selected
drive. Rule: `oe off` and mechanism supply off before any Pico USB unplug or
replug. SWD flash and `make reset` are fine.

## Step 1: drive identification

`oe on`, `enbl on`, `status`, no disk:

```
STATUS DIRTN=0 CSTIN=1 STEP=1 WRPROT=0 MOTORON=1 TK0=0 SWITCHED=0 TACH=0 RDDATA0=0 RDDATA1=0 SUPERDRIVE=0 REG_B=0 SIDES=1 READY=1 DRVIN=0 REVISED=1
```

DRVIN=0, SIDES=1, REVISED=1, SUPERDRIVE=0 and MOTORON=1 all match the
expected 800K mechanism. The mechanism stayed silent through `oe on` and
`enbl on`.

## Step 2: disk in / out, write-protect tab

| State | CSTIN | WRPROT | TK0 | Capture |
|---|---|---|---|---|
| No disk | 1 | 0 | 0 | `docs/captures/m1/2026-10-10_status_no-disk.txt` |
| Disk in, write-enabled (hole covered) | 0 | 1 | 1 | `..._status_disk_write-enabled.txt` |
| Disk in, protected (hole open) | 0 | 0 | 1 | `..._status_disk_protected.txt` |

WRPROT is active low as documented: 0 = protected. It also reads 0 with no
disk. The first insert was labeled "protected" on the bench but the tab was
the other way round; flipping it confirmed the polarity.

The mechanism spun the motor for about half a second by itself when the disk
went in. The console was idle and no command had been sent.

TK0 read 0 before the first insert and 1 with a disk in. The head may have
moved during the insert cycle. M2's recal will show where it is.

TACH read 0 once and 1 once with the motor off. That is just the level the
tach line rests at.

## Step 3: settle time (CA0 change to RD valid)

Scope CH1 on CN104 pin 2 (CA0), CH2 on CN104 pin 16 (RD), 10x probes, DC.
`status 12` (SIDES = 1) and `status 14` (DRVIN = 0) differ only in CA0.

| Edge | Delay (50 % to 50 %) | Edge time | Capture |
|---|---|---|---|
| CA0 rise -> RD fall | 27 ns (scope measurement) | CA0 rise 6.8 ns, RD fall 8.2 ns | `2026-10-10_settle_ca0-rise_rd-fall_2us.png` |
| CA0 fall -> RD rise | 35.2 ns (scope `measure_delay` FFR, re-measured at the start of M2; first estimate off the screen was 36 ns) | CA0 fall 5.5 ns, RD rise 13.9 ns | `2026-10-10_settle_ca0-fall_rd-rise_50ns_measured.png` |

RD is actively driven both ways; the rise isn't a slow pull-up edge. Settle
is well under the 5 us threshold, so `settle` stays at its 10 us default. M4
can drop it to 1 us, still more than 25 times the measured delay.

## Shutdown

`enbl off`, `oe off` on the console, then mechanism supply off. Pico and probe
left on; scope off.

## Open

- Where the head is after a disk insert (TK0 went 0 -> 1). M2 recal answers it.
- Next: M2, motor, step, recal, seek, eject (Task 11). No new firmware needed.

## Surprises

- The mechanism spins briefly on disk insert without being commanded.
- TK0 changed from 0 to 1 across the disk insert.
