robertrico/a2m2053_controller/docs/captures/m6/2026-10-11_iie_liron-repaired_volumes.png

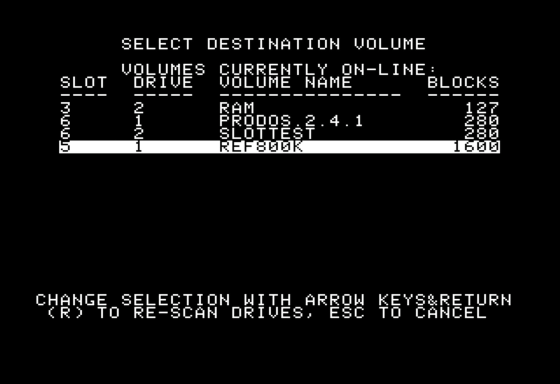
docs/captures/m6/2026-10-11_iie_liron-repaired_volumes.png
