robertrico/a2m2053_controller/docs/photos/m6/2026-10-11_liron-repaired-donor-iwm.jpg

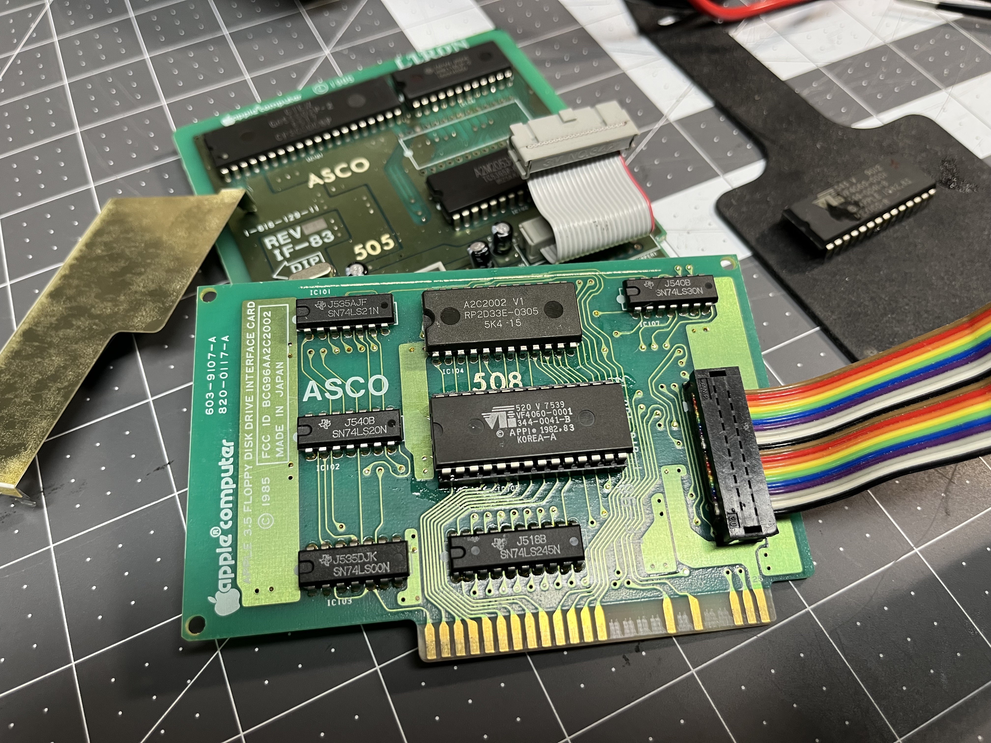
docs/photos/m6/2026-10-11_liron-repaired-donor-iwm.jpg
