robertrico/a2m2053_controller/hardware/kicad/a2m2053.kicad_pcb

## KiCad design hardware/kicad/a2m2053.kicad_pcb (2026-10-25)

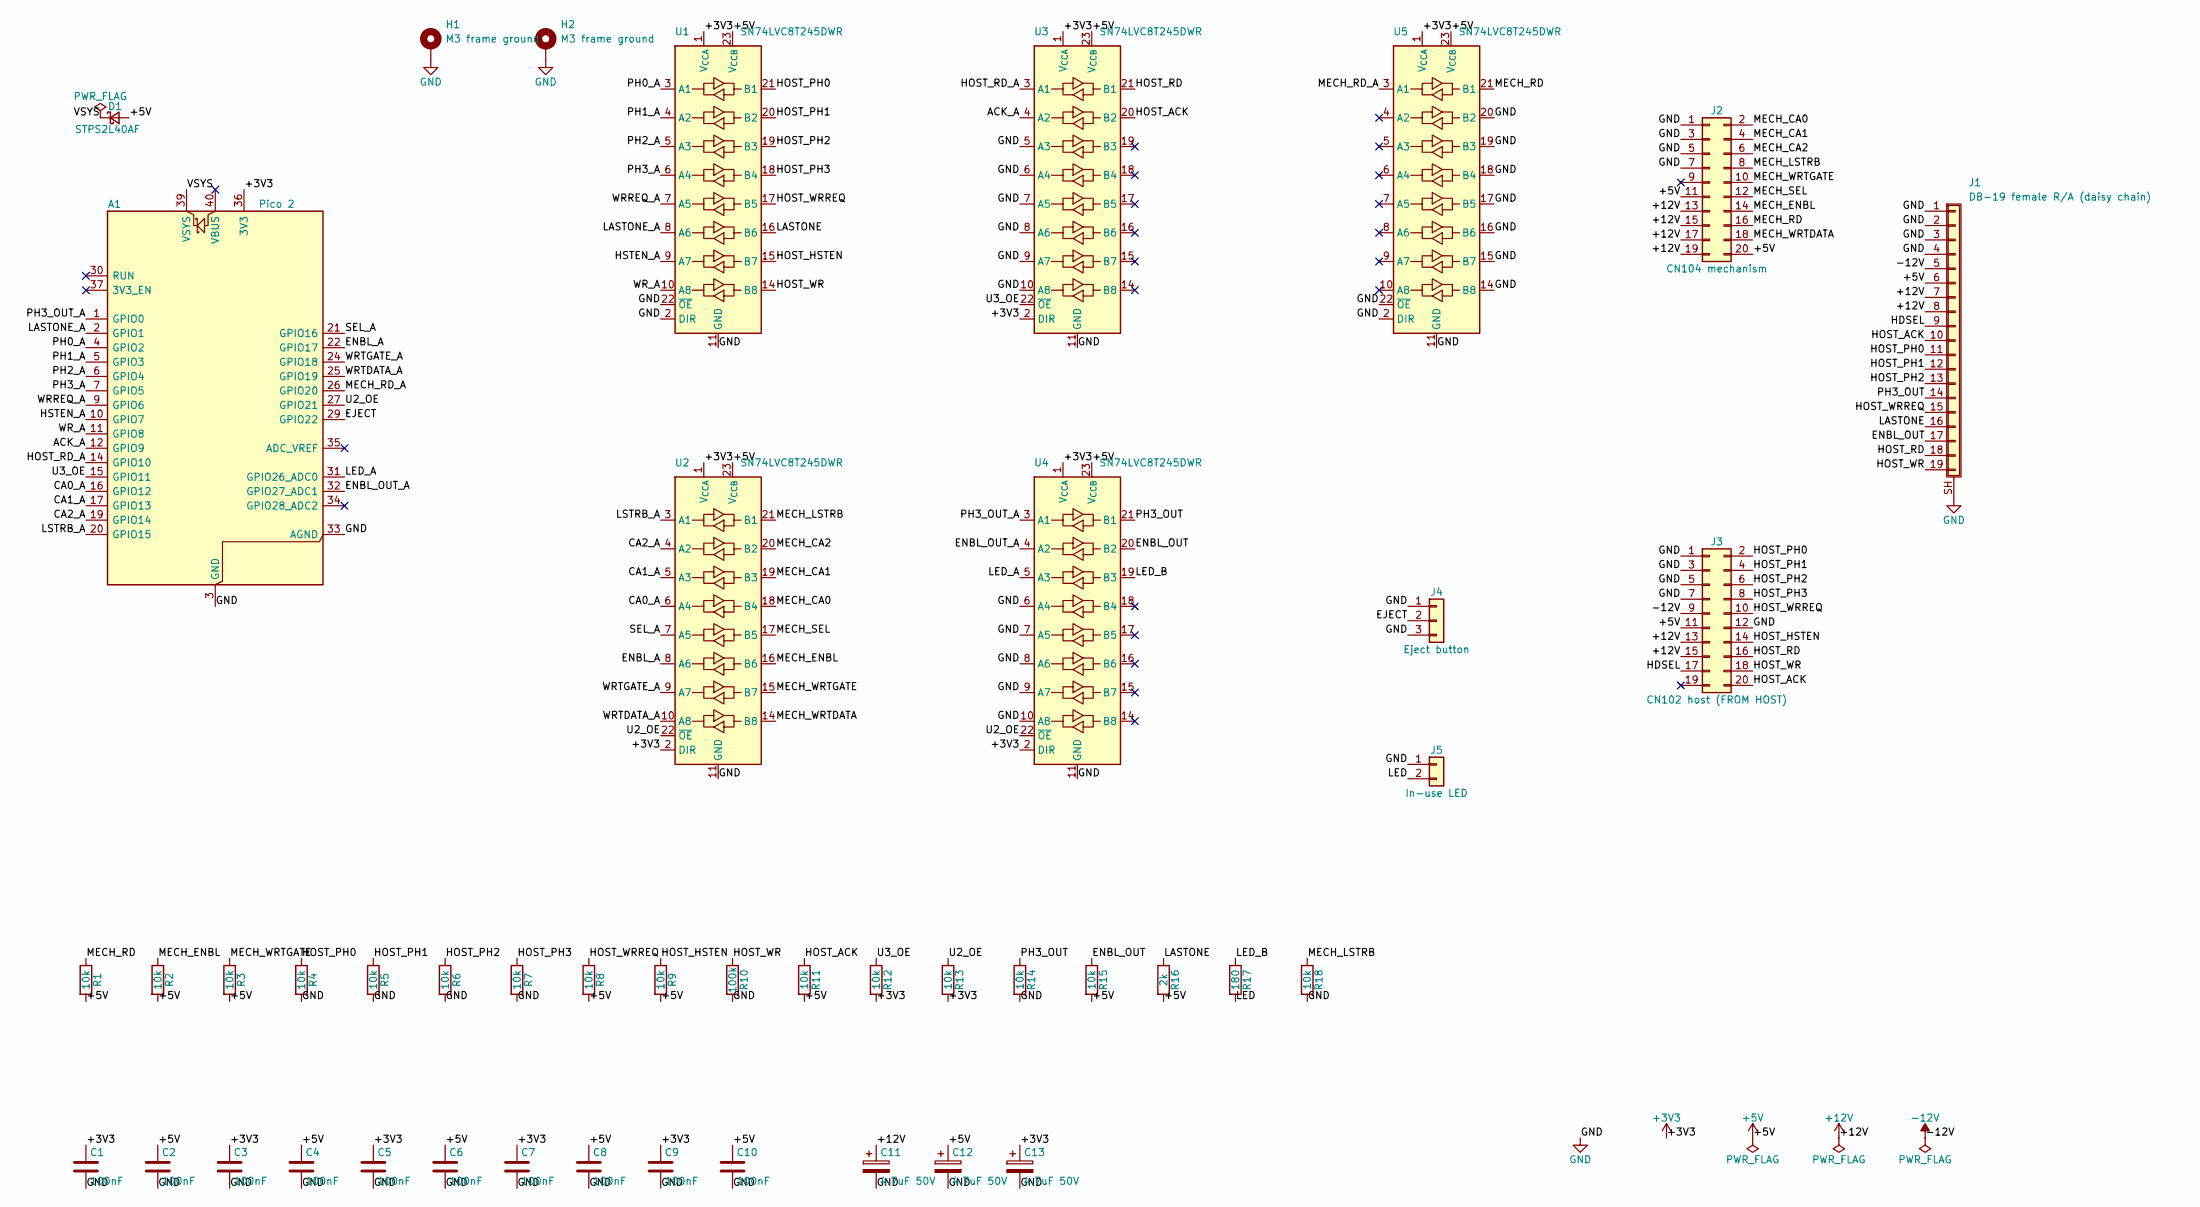
[picture p79: schematic a2m2053.kicad_sch]

Parts:
A1: Pico 2; RaspberryPi_Pico_SMD_HandSolder
C1, C2, C3, C4, C5, C6, C7, C8, C9, C10: 100nF; C_0805_2012Metric
C11, C12, C13: 4.7uF 50V; CP_Radial_D5.0mm_P2.00mm
D1: STPS2L40AF; D_SMA
H1: M3 frame ground; MountingHole_3.2mm_M3_Pad_5.2mm
H2: M3 frame ground; MountingHole_3.2mm_M3_Pad_Via
J1: DB-19 female R/A (daisy chain); DSUB-19_Female_Horizontal_P2.77x2.84mm_MountingHoles38.8mm
J2: CN104 mechanism; IDC-Header_2x10_P2.54mm_Vertical
J3: CN102 host (FROM HOST); IDC-Header_2x10_P2.54mm_Vertical
J4: Eject button; TE_AMP_CT_1x03_P2.00mm_Vertical; MPN 292161-3
J5: In-use LED; TE_AMP_CT_1x02_P2.00mm_Vertical; MPN 292161-2
R1, R2, R3, R4, R5, R6, R7, R8, R9, R11, R12, R13, R14, R15, R18: 10k; R_1206_3216Metric
R10: 100k; R_1206_3216Metric
R16: 2k; R_1206_3216Metric
R17: 180; R_1206_3216Metric
U1, U2, U3, U4, U5: SN74LVC8T245DWR; SOIC-24W_7.5x15.4mm_P1.27mm

Connections:
+3V3: A1.36 (3V3), C1.1, C3.1, C5.1, C7.1, C9.1, C13.1, R12.2, R13.2, U1.1 (V_{CCA}), U2.1 (V_{CCA}), U2.2 (DIR), U3.1 (V_{CCA}), U3.2 (DIR), U4.1 (V_{CCA}), U4.2 (DIR), U5.1 (V_{CCA})
/ACK_A: A1.12 (GPIO9), U3.4 (A2)
/CA0_A: A1.16 (GPIO12), U2.6 (A4)
/CA1_A: A1.17 (GPIO13), U2.5 (A3)
/CA2_A: A1.19 (GPIO14), U2.4 (A2)
/EJECT: A1.29 (GPIO22), J4.2
/ENBL_A: A1.22 (GPIO17), U2.8 (A6)
/ENBL_OUT: J1.17, R15.1, U4.20 (B2)
/ENBL_OUT_A: A1.32 (GPIO27_ADC1), U4.4 (A2)
/HDSEL: J1.9, J3.17
/HOST_ACK: J1.10, J3.20, R11.1, U3.20 (B2)
/HOST_HSTEN: J3.14, R9.1, U1.15 (B7)
/HOST_PH0: J1.11, J3.2, R4.1, U1.21 (B1)
/HOST_PH1: J1.12, J3.4, R5.1, U1.20 (B2)
/HOST_PH2: J1.13, J3.6, R6.1, U1.19 (B3)
/HOST_PH3: J3.8, R7.1, U1.18 (B4)
/HOST_RD: J1.18, J3.16, U3.21 (B1)
/HOST_RD_A: A1.14 (GPIO10), U3.3 (A1)
/HOST_WR: J1.19, J3.18, R10.1, U1.14 (B8)
/HOST_WRREQ: J1.15, J3.10, R8.1, U1.17 (B5)
/HSTEN_A: A1.10 (GPIO7), U1.9 (A7)
/LASTONE: J1.16, R16.1, U1.16 (B6)
/LASTONE_A: A1.2 (GPIO1), U1.8 (A6)
/LED: J5.2, R17.2
/LED_A: A1.31 (GPIO26_ADC0), U4.5 (A3)
/LED_B: R17.1, U4.19 (B3)
/LSTRB_A: A1.20 (GPIO15), U2.3 (A1)
/MECH_CA0: J2.2, U2.18 (B4)
/MECH_CA1: J2.4, U2.19 (B3)
/MECH_CA2: J2.6, U2.20 (B2)
/MECH_ENBL: J2.14, R2.1, U2.16 (B6)
/MECH_LSTRB: J2.8, R18.1, U2.21 (B1)
/MECH_RD: J2.16, R1.1, U5.21 (B1)
/MECH_RD_A: A1.26 (GPIO20), U5.3 (A1)
/MECH_SEL: J2.12, U2.17 (B5)
/MECH_WRTDATA: J2.18, U2.14 (B8)
/MECH_WRTGATE: J2.10, R3.1, U2.15 (B7)
/PH0_A: A1.4 (GPIO2), U1.3 (A1)
/PH1_A: A1.5 (GPIO3), U1.4 (A2)
/PH2_A: A1.6 (GPIO4), U1.5 (A3)
/PH3_A: A1.7 (GPIO5), U1.6 (A4)
/PH3_OUT: J1.14, R14.1, U4.21 (B1)
/PH3_OUT_A: A1.1 (GPIO0), U4.3 (A1)
/SEL_A: A1.21 (GPIO16), U2.7 (A5)
/U2_OE: A1.27 (GPIO21), R13.1, U2.22 (~OE), U4.22 (~OE)
/U3_OE: A1.15 (GPIO11), R12.1, U3.22 (~OE)
/WRREQ_A: A1.9 (GPIO6), U1.7 (A5)
/WRTDATA_A: A1.25 (GPIO19), U2.10 (A8)
/WRTGATE_A: A1.24 (GPIO18), U2.9 (A7)
/WR_A: A1.11 (GPIO8), U1.10 (A8)
GND: A1.3 (GND), A1.8 (GND), A1.13 (GND), A1.18 (GND), A1.23 (GND), A1.28 (GND), A1.33 (AGND), A1.38 (GND), C1.2, C2.2, C3.2, C4.2, C5.2, C6.2, C7.2, C8.2, C9.2, C10.2, C11.2, C12.2, C13.2, H1.1 (1_1), H2.1 (1_1), J1.1, J1.2, J1.3, J1.4, J1.SH (Shield), J2.1, J2.3, J2.5, J2.7, J3.1, J3.3, J3.5, J3.7, J3.12, J4.1, J4.3, J5.1, R4.2, R5.2, R6.2, R7.2, R10.2, R14.2, R18.2, U1.2 (DIR), U1.11 (GND), U1.12 (GND), U1.13 (GND), U1.22 (~OE), U2.11 (GND), U2.12 (GND), U2.13 (GND), U3.5 (A3), U3.6 (A4), U3.7 (A5), U3.8 (A6), U3.9 (A7), U3.10 (A8), U3.11 (GND), U3.12 (GND), U3.13 (GND), U4.6 (A4), U4.7 (A5), U4.8 (A6), U4.9 (A7), U4.10 (A8), U4.11 (GND), U4.12 (GND), U4.13 (GND), U5.2 (DIR), U5.11 (GND), U5.12 (GND), U5.13 (GND), U5.14 (B8), U5.15 (B7), U5.16 (B6), U5.17 (B5), U5.18 (B4), U5.19 (B3), U5.20 (B2), U5.22 (~OE)

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
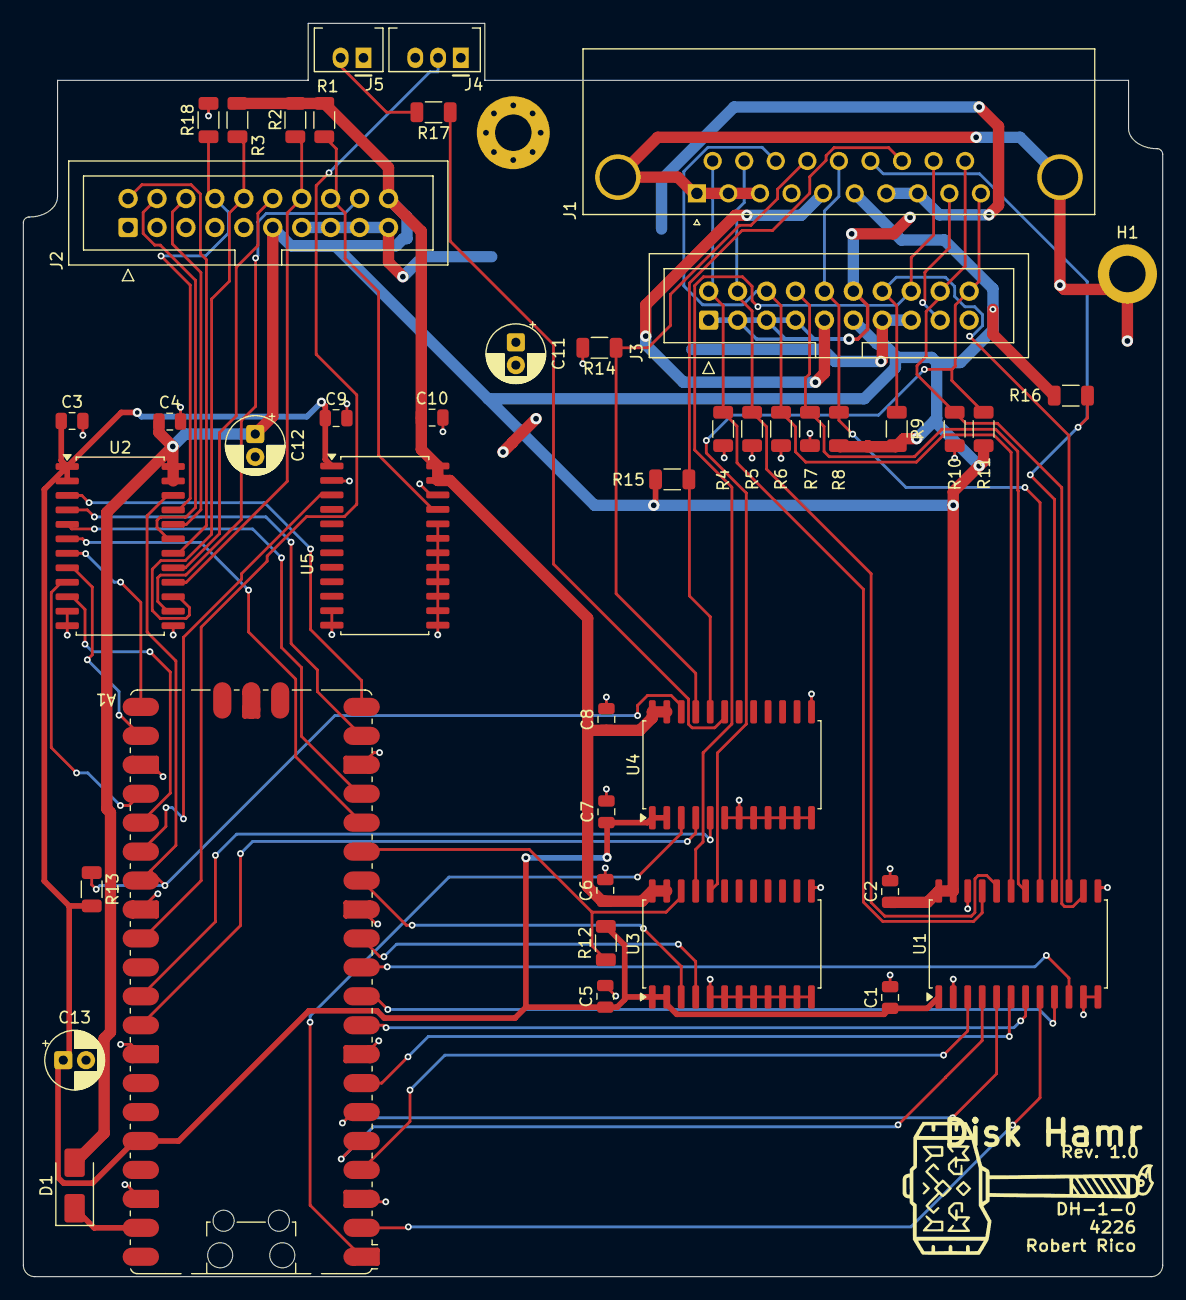
[picture p80: board a2m2053.kicad_pcb from above]

Board: 2 copper layers, 100.0 x 110.0 mm, 45 parts (0 on the bottom side), 55 nets.
