robertrico/a2m2053_controller/(commit log)

2026-10-07 docs: initial research, design spec and CLAUDE.md
    Research digest, level shifting and pin budget, IWM doc index, board and
    mechanism notes, and the draft design spec for an RP2350-based UniDisk 3.5
    replacement controller. Third-party documents live in git-ignored
    docs/private/; docs/SOURCES.md lists where to fetch each one.
    Claude-Session: https://claude.ai/code/session_019D81FRPgvuWMWqj8SiQoUE
2026-10-07 feat(fw): RP2350 scaffold with safe pin init and host tests
    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
2026-10-07 docs(plan): safer M0 bench steps (power order, OpenOCD path, reset)
    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
2026-10-10 docs: add own photos of IF-83 board (top, CXD1013 underside)
    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
2026-10-10 docs(m0): bench rig, boot safety and power-cycle results
    CN104 orientation confirmed by continuity. Mechanism idle on the bench:
    10 mA on +5V, 0 A on +12V. Scaffold firmware flashed over SWD.
    Boot safety passes on SWD reset: U2 /OE, LSTRB and CA1 stay quiet.
    A Pico power cycle with the mechanism powered drives LSTRB to 5 V
    (about 1.5 ms on unplug, 1.3 us on replug) while VCCA is below the
    8T245 minimum. /ENBL stays high, so the mechanism ignores it. Bench
    rule: mechanism supply off before power-cycling the Pico.
    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
2026-10-10 docs(m0): add bench photos
    Rig overview, breadboard with Pico 2 and U1/U2, scope probes on the rig,
    and the supply at idle. EXIF stripped, orientation baked into the pixels.
    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
2026-10-10 fix(fw): turn the motor off when spin-up times out
    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
    [mech.c, test_mech.c]
2026-10-10 fix(fw): reject over-long console lines instead of truncating
    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
    [main.c]
2026-10-10 fix(fw): console echo and backspace; READY timeout 1 s
    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
    [main.c, mech.h]
2026-10-10 docs(plan): fix M1 settle-time scope steps and power rule
    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
2026-10-10 fix(fw): hold LSTRB high 500 ms for eject
    The ROM's few-microsecond eject strobe does nothing when the Pico drives
    the Sony mechanism directly: on the bench, three tries left the disk in
    with no sound or current. The ROM's short strobe goes through the
    CXD1013, which presumably stretches it. tashnotes (mci.md) says the
    eject strobe must be held high for about 0.5 s when driving the drive
    directly, as a Mac does.
    mech_eject now strobes EJECT with LSTRB high for MECH_EJECT_STROBE_US
    (500 ms). Other commands keep the short strobe. The fake bus records
    strobe length per address, and test_eject_success checks both.
    Claude-Session: https://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
    [fake_bus.h, mech.c, mech.h, test_mech.c]
2026-10-10 fix(fw): eject strobe back to the short in-spec pulse
    ERS 699-0452 sec. 3.4.7 limits the eject LSTRB pulse to 1 us min,
    300 ms max, so the 500 ms hold from 087297d was out of spec. The bench
    also showed the short strobe works: after `cmd 14` the drive's EJECT
    status (address 6) goes high for its 2 s timeout and +12V draws about
    0.28 A. The disk doesn't move because the eject motor stalls, which is
    a mechanical fault in this drive, not a strobe problem.
    Keeps the fake bus strobe-length tracking; test_eject_success now checks
    the eject strobe sits inside the ERS window.
    Claude-Session: https://claude.ai/code/session_019D81FRPgvuWMWqj8Si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
    [mech.c, mech.h, test_mech.c]
2026-10-10 docs(m2): motor, zone speeds, seek timing; eject stalls mechanically
    Zones 1-5 within 0.5 % of the ERS speeds, tach confirmed on the scope at
    60 pulses per revolution. Full-stroke seek about 6.2 ms per track. Eject
    command is accepted (EJECT status high, +12V draws about 0.28 A) but the
    motor stalls: mechanical. Also records the +5V drop at the connector and
    the M1 settle time re-measured with the scope (35.2 ns).
    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
2026-10-10 feat(tools): flux-to-nibble decoder and 800K track parser
    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
2026-10-10 test(tools): pin drift tracking with a 12 % drift case
    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
    [test_flux_track.py]
2026-10-10 fix(tools): disk always cleans up; capture waits for the counted payload
    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
    [cli.py, serialio.py, test_proto_cli.py]
2026-10-10 test(tools): capture test now fails on the old END search
    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
    [test_proto_cli.py]
2026-10-10 feat(fw): PIO+DMA flux capture with CRC-checked USB dump
    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
2026-10-10 fix: single-call flux dump, PIO overhead 2 counts, sector range check
    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
    [cli.py, flux.py, main.c, test_flux_track.py, track.py]
2026-10-10 docs(plan): M3 bench notes for timing, port, motor and RD polarity
    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
2026-10-11 docs(m3): +5V path was the read failure; both drives read every sector
    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
2026-10-11 docs(m3): IF-83 bulk caps are 4.7 uF 50 V
    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
2026-10-11 docs(plan): Task 12 commands use the explicit Pico port
    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
2026-10-11 docs(spec): M4 board-side block read design
    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
2026-10-11 docs(plan): M4 board-side block read implementation plan
    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
2026-10-11 fix(fw): clamp the decoder's cell estimate so noise can't wedge it
    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
    [flux_dec.c, flux_dec.h, test_flux_dec.c]
2026-10-11 feat(fw): track buffer and lock-free inter-core queues
    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
2026-10-11 fix(fw): bound every server path by the request cap; tighten policy tests
    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
    [fake_drive.h, mech_server.c, mech_server.h, test_mech_server.c]
2026-10-11 feat(fw): continuous flux stream into a DMA ring buffer
    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
2026-10-11 fix(fw): match replies to requests; one head position across server on/off
    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
    [main.c]
2026-10-11 fix(fw): make server on idempotent and never reset queues under a live core 1
    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
    [main.c]
2026-10-11 feat(tools): readdisk and readblk for the board-side reader
    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
2026-10-11 fix(tools): framed readdisk stream scan; clean CLI errors
    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
    [cli.py, proto.py, serialio.py, test_proto_cli.py]
2026-10-11 fix: real decode-headroom metric; keep the firmware's ERR reason on the host
    Host side of the DISK END change (mean ns/interval, max ring backlog),
    flux_stream_backlog_max/reset, readdisk output, the bench plan text, and
    the ERR line parser that no longer drops "server timeout".
    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
    [cli.py, flux.c, flux.h, proto.py, test_proto_cli.py]
2026-10-11 fix(fw): server owns the motor; ignore impossible foreign tracks; oe off as kill switch; test header deps
    Also carries the firmware half of the decode-headroom metric
    (srv_stats decode_us/intervals, DISK END mean/backlog in do_readdisk).
    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
    [fake_drive.h, main.c, mech_server.c, mech_server.h, test_mech_server.c]
2026-10-11 fix(fw): reset core 1 before launching it
    On the bench, after an SWD flash or `make reset`, core 1 stayed in the boot
    ROM (PC 0xda, SP 0xf0000000) and `server on` reported "did not start"; a
    cold power cycle fixed it. The SDK says to reset core 1 before launch when it
    may not be in its boot-ROM wait state.
    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
    [main.c]
2026-10-11 build(fw): OpenOCD attaches to core 0 only
    With both cores attached (SMP), OpenOCD left core 1 debug-halted after
    `make flash`/`make reset`, so `server on` reported "did not start" until a
    cold power cycle. `set USE_CORE 0` leaves core 1 alone; verified on the
    bench: server on -> OK right after a reset.
    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
2026-10-11 docs(m4): whole disk read on the board, byte-identical in 26 s
    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
2026-10-11 docs(m4): retest with the mechanism in a bracket, still byte-identical
    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
2026-10-11 docs(spec): M5 board-side write and format design
    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
2026-10-11 feat(tools): drive ROM track layout and M5 fixtures
    Implement synthetic ROM track generation for M5 (disk write/format).
    Adds SYNC_PACKED constant, rom_data_field(), rom_sector(), and rom_track_bytes()
    to synth.py. Generates fixture files rom_track_t17s1.bin, rom_track_t70s0.bin,
    rom_dfield_s5.pay, rom_dfield_s5.bin for firmware tests. mkfixtures.py supports
    --rom-only flag for M5 fixture generation without REF800K.
    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
    [synth.py, test_synth_rom.py]
2026-10-11 feat(fw): wtrack builds the ROM's data-field and track images
    Implements wtrack_data_field, wtrack_track, and wtrack_order functions that
    build byte images matching the drive ROM's layout (liron.asm Se3b9). Data
    fields include GCR encoding, track images include preamble, sector gaps, and
    address/data field pairs in interleaved order.
    Test coverage: layout verification, Python fixture matching, track lengths and
    limits, sector ordering, flux-level decoding.
    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
    [test_wtrack.c, wtrack.c, wtrack.h]
2026-10-11 feat(fw): flux_dec reports each good header at its epilog
    Add a header callback to the flux_dec_sink_t interface. The callback is
    invoked once per address field whose checksum and DE AA epilog are good,
    before foreign/range checks. This allows M5 write operations to start
    immediately after the header.
    Verified with TDD: failing tests now pass. All existing tests still pass.
    New tests verify the callback fires at the right time and reports
    correct header values for good, foreign, and bad-data cases.
    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
    [flux_dec.c, flux_dec.h, test_flux_dec.c]
2026-10-11 fix(fw): erase-tail wait after an aborted stuck write
    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
    [fake_drive.h, mech_server.c, test_mech_server.c]
2026-10-11 feat(fw): format one track side in the ROM layout, with verify
    Fake drive: a recorded track is a ring, so the zeros after the last 1
    lead the first interval of the next revolution. Without it the sector
    straddling the revolution seam never decoded.
    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
2026-10-11 feat(fw): flux_tx PIO write driver; /WRTGATE fenced to flux_tx.c
    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
2026-10-11 fix(fw): M5 final-review fixes (BLK backlog phase, late-byte drain, format wait/stop, len==0 guard)
    - BLK backlog now spans load..fire only
    - drain stdin after writeblk ERR timeout so payload is not run as commands
    - core 0 format wait outlasts core 1 (SRV_FORMAT_TS_WAIT_MS)
    - flux_tx_load ignores len==0; format_ts rejects empty track image
    - format stops on any console byte (FMT STOPPED, FORMAT END with IOERR)
    - spec: WRTDATA idle level; flux_tx_busy comment
    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
    [console.c, flux_tx.c, flux_tx.h, main.c, mech_server.c, mech_server.h]
2026-10-11 fix(fw): wait for READY after a seek that only recalibrated
    A seek to track 0 from an unknown position recalibrates and then has
    delta 0, so it returned before READY. The format loop then read READY
    high and used up all 10 tries in 0.7 s without writing (M5 bench).
    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
    [mech.c, test_mech.c]
2026-10-11 docs(m5): board writes and formats; UniDisk catalogs our disk
    Bench 2026-10-11: sector write + verify, whole-disk writes byte-identical
    to REF800K, board format in 46 s, and a board-formatted disk catalogs in
    the working UniDisk. Gate timing and 3.1 us fire latency on the scope.
    ADTPro byte-for-byte check of disk 2 still pending.
    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
2026-10-11 docs(m5): ADTPro image of the board-written disk matches REF800K
    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
2026-10-11 docs(m6): host wiring, -12V bridge failure, Liron IWM damage
    First host-side bring-up through a homemade DB-19 breadboard adapter.
    A loose strand bridged -12 V onto /WRREQ: U1 (8T245) burned and the
    Liron card's IWM WRDATA output died. Root cause, measurements, photos
    and the repair plan are in docs/build_log/m6.md. M6 paused until IDC
    breakouts arrive and the card is repaired.
    ACK now rides U3 with host RD (as built); 74LVC1G07 dropped from
    CLAUDE.md, pin_budget.md and pins.h.
    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
    [pins.h]
2026-10-11 docs(m6): IWM pin 7-13 diode readings, donor vs Liron
    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
2026-10-12 docs(m6): Liron IWM was soldered; socket added
    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
2026-10-12 docs(m6): first low-power host connect, J1 levels
    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
2026-10-12 docs(m6): host inputs live on the Pico, PR#5 activity seen
    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
2026-10-12 docs: handoff, M6 host side proven; wiring table updates
    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
2026-10-12 feat(m6): SmartPort wire format: IWM framing, packet decode and encode
    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
2026-10-12 feat(m6): SmartPort device logic: INIT/ID, STATUS/DIB, block commands
    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
2026-10-12 feat(m6): RP2350 SmartPort HAL, flash image, console sp/splog, polled main loop
    PIO0 fm_rx/fm_tx with DMA, ACK and U3 /OE on SIO. RD idles high.
    The ProDOS image is linked from docs/private (never committed).
    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
2026-10-12 fix(m6): review findings: no late ACK, fm_rx edge blanking, keep the pending command
    - ACK only while REQ is high and < 90 us after the underrun; count late
    and late_entry, measure the data-packet ACK too.
    - fm_rx ignores WR for 0.49 us after an edge (ringing, slow crossings).
    - An ignored packet during the data wait no longer replaces the command;
    a new command invalidates the old reply for re-reads.
    - Sim: stalled main loop, stray command during WRITEBLOCK. PIO model:
    slow rising edges, ringing.
    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
    [main.c, sp_bus.c, sp_bus.h, test_fm_pio.py, test_sp_bus.c]
2026-10-13 fix(m6): splog prints only when the whole line fits; make flash does a rescue reset first
    The CDC TX buffer is 64 bytes, so the old 96-byte gate never printed.
    Flashing the 864 KB image timed out while core 1 ran from flash.
    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
    [main.c]
2026-10-13 perf(m6): SmartPort hot path in RAM; ACK latency is an upper bound when the rise was not seen
    Bench: the INIT after a bus reset was ACKed 31 us after /WRREQ rose
    (cold flash cache) while the engine reported -3 us.
    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
    [sp_bus.c, sp_bus.h, sp_dev.c, sp_hw.c, sp_ram.h, sp_wire.c]
2026-10-13 feat(m7): mechanism server media query, eject, debounced eject button
    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
2026-10-13 feat(m7): floppy behind SmartPort: server from boot, sp disk ram|floppy, imgcopy, LED, eject
    Core 1 answers REQ_MEDIA/REQ_EJECT and tags every reply. splog shows the
    core-1 time per command (ms=), sp shows the hold-off maximum.
    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
2026-10-13 fix(m7): review findings: no wedge on slow replies, release the bus on reset, ROM order and codes
    - Requests carry a sequence number; late replies are dropped and a
    timeout no longer locks the floppy out. Waits cover a button eject.
    - A bus reset while core 0 waits ends the wait, releases the bus and
    clears the ID, so the card's single INIT try after Ctrl-Reset works.
    - No disk / write-protect before the block range (ROM Le8b2); a failed
    eject is $27; $67 follows the ROM's Z57 bits.
    - Eject button off until ejbtn on; server on clears the wedge; idle
    repeats motor off; LED on at request start.
    Claude-Session: https://claude.ai/c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
    [console.c, console.h, fstore.c, fstore.h, ipc.h, main.c, mech_server.c]
2026-10-13 fix(m7): STATUS $05 byte 7 is $FF as on the UniDisk; at most 5 re-sends per reply
    SPCOMPARE on the working UniDisk returns 00x7 FF for STATUS $05. The re-send
    cap stops the loop seen during the M7 brown-out (190 re-sends of a stale reply).
    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
    [fstore.c, ramdisk.c, sp_bus.c, sp_bus.h, test_fstore.c, test_sp_bus.c]
2026-10-13 docs: close answered open items (ACK wait, host pinout, working unit, daisy chain next)
    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
2026-10-13 feat(m7): eject button on by default: a plain switch straight to GP22
    Rico settled the wiring: no shifter, internal pull-up, so an unwired
    button reads released. U5 carries LASTONE/ only.
    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
2026-10-13 docs(m7): eject button wording inline
    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
2026-10-13 feat(pcb): KiCad project with the IF-83 board outline
    Start the Phase 2 PCB. FABRICATION.md holds the hand-solder rule
    (SOIC 8T245DWR, Pico 2 soldered flat by its castellated pads), the
    board requirements carried from the bench, and the outline numbers.
    The outline and the first two M3 holes are drawn on Edge.Cuts by
    tools/kicad_outline.py through the KiCad IPC API. Step depth is
    still read off the photo; tab and section widths are calipered.
    [a2m2053.kicad_pcb, a2m2053.kicad_sch]
2026-10-13 feat(pcb): outline fitted against the IF-83 by test print
    A 3D-printed outline was laid on the original board and both M3
    holes line up. Hole 1 moved up 3 mm and 0.5 mm toward the edge;
    the steps are not level (8 mm deep left, 13 mm right). The outline
    is now a hard constraint for the PCB.
    [a2m2053.kicad_pcb]
2026-10-13 feat(pcb): frame-ground mounting holes H1/H2
    Both M3 holes become plated footprints on net FG, placed from the
    schematic. H2 uses the stock MountingHole_3.2mm_M3_Pad_Via. H1 sits
    3.1 mm from the board edge, so it gets a project footprint with a
    5.2 mm pad to keep 0.5 mm copper-to-edge. DRC: 0 violations; the
    only unconnected item is FG between H1 and H2, not routed yet.
    The outline script no longer draws hole circles; it positions H1/H2,
    with a warning that footprint moves through the API crashed KiCad.
    [a2m2053.kicad_pcb, a2m2053.kicad_sch]
2026-10-14 feat(pcb): rear DB-19 J1 placed and fit-checked, step depths corrected
    - J1: female right-angle DB-19 (daisy-chain port), 38.8 mm board-lock
    footprint on FG, face at the 94 mm top edge. Placement checked with a
    3D print holding the real connector on the IF-83 mounting points and
    in the case opening.
    - Outline steps are 12 mm deep on the left and 6 mm on the right, checked
    on the IF-83. kicad_outline.py gains --outline-only.
    - Photos of the fit check, EXIF stripped.
    Claude-Session: https://claude.ai/code/session_019cEGosXJSu4icn9o4uaZwB
    [a2m2053.kicad_pcb, a2m2053.kicad_sch]
2026-10-15 feat(m8): loop console command for the rear-port loopback test
    Drives PH3_OUT, ENBL_OUT, host RD and ACK one at a time through a fixed
    32-step pattern and reports which host/rear inputs followed. Requires
    server off and sp off; U3 drives J1 meanwhile, so the host cable must be
    off the Liron card.
    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
    [console.c, console.h, loop.c, loop.h, main.c, sp_hw.c, sp_hw.h, test_console.c]
2026-10-16 feat(pcb): schematic wired, parts placed, board autorouted
    Schematic: Pico 2 (A1), five SN74LVC8T245 (U1-U5) with one 100 nF per
    rail, pull-ups/pull-downs, D1 Schottky to VSYS, 4.7 uF 50 V bulk caps,
    J2 (CN104) and J3 (CN102) 2x10 headers, J4 eject and J5 LED headers.
    Board: all parts placed inside the IF-83 outline, Pico USB at the bottom
    edge. Netclasses Power (+5V, +12V, -12V: 1.0 mm), Rail (+3V3, VSYS:
    0.5 mm). GND pour on B.Cu, +5V pour on F.Cu. Tracks from Freerouting
    2.1.0 (r5, 80 vias); -12V J1.5 to J3.9 routed by hand at 0.25 mm.
    Routing scratch (DSN/SES runs, DRC dumps, helper scripts) lives in
    hardware/kicad/scratch/, git-ignored except for its .gitkeep.
    DRC: 0 unconnected. Ope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
    [a2m2053.kicad_pcb, a2m2053.kicad_sch]
2026-10-16 feat(m8): rear-port pass-through after INIT, no stale re-send in a chain
    PIO2 copies host PH3 -> PH3_OUT and host /ENBL -> ENBL_OUT once INIT has
    given us an ID (ROM PH3EN, $44); a bus reset returns both to their idle
    levels. sp_bus drives it through a new set_chain HAL hook, before our INIT
    reply goes out. A command packet that is not ours (or fails its checksum)
    now drops the saved reply, so the re-read path no longer re-sends our old
    reply over the reply of the drive behind us. `loop` parks the pass-through
    while it runs.
    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
    [main.c, sp_bus.c, sp_bus.h, sp_hw.c, sp_hw.h, test_sp_bus.c]
2026-10-16 docs(m8): chain passed on the bench, M7.5 host power, +5 path, eject button
    M7.5: board and mechanism on the IIe rails, sentinel boot and SPCOMPARE
    match M7. M8: rear port proven by loopback and end-to-end beep; chain
    works with the working UniDisk in front of and behind our board; a full
    disk copied to the UniDisk boots the sentinel. The UniDisk behind us was
    starved at 4.3 V by thin +5 jumpers; 24 AWG brings it to 4.7 V.
    FABRICATION gains the missing LSTRB pull-down and wide rear-port rails.
    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
2026-10-16 docs(m8): Pico powered from the IIe through a diode, rig standalone
    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
2026-10-16 docs(m8): bench photo of the chain on the IIe (EXIF stripped)
    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
2026-10-16 docs(m8): clean-boot check on IIe power closes the M8 and M7.5 open items
    Cold boot with 24 AWG on +5: 0 timeouts, 0 re-reads, 0 checksum errors.
    SPCOMPARE write-protected and no-disk match M7. Full read scan matches the
    reference image apart from two files added to the disk later. Drop the
    stale "commit the firmware" next steps; point the handoff at M9.
    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
2026-10-16 docs(m9): robustness passed on the bench; no 3V3 supervisor
    Swaps, swap-then-write, write-protected and empty drives, eject and resets
    mid-transfer behave like the UniDisk; 1610 writes with 0 errors in one
    session. Drop the 3V3 supervisor (the power-edge LSTRB strobe can at worst
    step or blip the mechanism at power-on, as stock drives do). Confirm the
    LED polarity and the Pico diode. The eject button is a changeover switch,
    not a plain one; J4 still works, revisit at PCB design.
    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
2026-10-16 feat(pcb): place and route the controller board
    Schematic: add R18 (10k LSTRB pull-down to GND, matches the rig) and
    re-order 8T245 channels on U1, U2 and U5 so the fan-outs do not cross.
    HANDOFF lists the eight prototype rewires.
    PCB: place all parts, route host, rear, mechanism and Pico fan-outs,
    +5V and GND pours, a +12V band under the mechanism power path, stitch
    the Pico GND castellations and the host pull-up pour strips. DRC with
    zone refill: 0 errors; one stray via to delete in pcbnew (noted in
    HANDOFF).
    [a2m2053.kicad_pcb, a2m2053.kicad_sch]
2026-10-16 fix(pcb): tie the mechanism +5V group to the host +5V feed
    J2.11/J2.20, C12 and the U5 feed were an island of the +5V pour, walled
    off by the SEL/ENBL/WRTDATA drops and the +12V band. Add a 1.2 mm B.Cu
    run at y 76.3 from the J2 strap to the x 151 host feed, stitch the two
    small pour slivers near C12 and J2.11, drop the stray via. DRC with zone
    refill: 0 errors, 0 unconnected.
    [a2m2053.kicad_pcb]
2026-10-16 experiment(pcb): Freerouting 2.5 clean-field result imported for comparison
    All tracks and vias wiped, Freerouting routed every net from scratch
    with no pours visible to it, session imported, zones refilled. 862
    segments, 73 vias. Not DRC clean (import left 50 segments at 0.187 mm,
    two ENBL_OUT pieces missing, GND traces on the board edge). Kept on this
    branch for comparison only; main carries the hand-routed board.
    [a2m2053.kicad_pcb]
2026-10-16 experiment(pcb): Freerouting result hand-fixed to DRC clean
    Narrow neck-down segments widened, ENBL_OUT completed, GND traces
    pulled off the board edge, a few vias dragged. DRC with zone refill:
    0 errors, 0 unconnected. +5V, +12V and GND each verify as one
    connectivity cluster. 870 segments, 81 vias.
    [a2m2053.kicad_pcb]
2026-10-16 feat(pcb): Byte Hamr logo and board text, FG merged into GND
    Silkscreen: logo_sm footprint from Byte Hamr rev 2 (copied into the
    project library), title, revision and ID block in the bottom-right
    corner. Board named Disk Hamr.
    Schematic: the three FG global labels on H1, H2 and the J1 shield become
    GND power symbols; FG was a fit-test placeholder, frame ground is the
    same return. PCB pads were already on GND. Schematic parity, DRC with
    refill and ERC are clean apart from the pre-existing Pico AGND/GND pin
    type error.
    [a2m2053.kicad_pcb, a2m2053.kicad_sch]
2026-10-16 docs: HANDOFF for the Disk Hamr board state after the Freerouting pass
2026-10-16 fix(pcb): remove two dangling vias left from hand edits
    [a2m2053.kicad_pcb]
2026-10-18 docs(pcb): bill of materials for Disk Hamr rev 1.0
    Add hardware/bom.md (every schematic reference with part number, vendor,
    per-board cost and purpose) and hardware/bom.csv (15 order lines grouped
    by part). Link both from FABRICATION.md and the CLAUDE.md layout table.
    Prices: the 8T245 figure is from FABRICATION.md, the Pico 2 is $12 per
    unit (Rico, 2026-10-18), everything else is unverified and marked so.
    Board estimate about $35 to $40. The DB-19 female right-angle connector
    has no confirmed vendor yet.
    Claude-Session: https://claude.ai/code/session_01DXbgAAL8jgkXdR17j5AhX6
    [bom.csv]
2026-10-25 feat(pcb): second layout of Disk Hamr rev 1.0, hand placed, +5V as traces
    The 3D print put the mechanism header (J2) 11 mm too far from the
    board edge, so the board was placed again by hand and re-routed with
    Freerouting, then fixed up by hand.
    - Shifters next to the connectors they serve: U2/U5 by J2, U1/U3/U4
    under J1/J3, Pico along the left edge.
    - +5V pour on F.Cu removed. +5V is a Power net class now (1 mm
    track, 1 mm via) and is routed as traces; the pour had split into
    eleven islands under the signal traces and Freerouting treats a
    plane as already connected.
    - +12V zone moved to B.Cu. GND stays a B.Cu plane; a fenced GND pocket
    under J1 is bridged with a top-side jumper.
    -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
    [a2m2053.kicad_pcb, a2m2053.kicad_sch]
2026-10-25 docs: IF-83 LED and eject circuits, tab header order, BOM open items
    - research_notes: CN107/CN108 order from the photo; the in-use LED is
    pulled up to +5V on the IF-83 and switched by Q101 ("L-5"), base
    through 10k to the CXD1013, so the plug is active low; both eject
    contacts go to separate CXD1013 pins. Tagged [measured] 2026-10-24.
    - FABRICATION, HANDOFF, bom: J4/J5 placed in the IF-83's order and
    shroud orientation; read the original pull-up to size R17; the
    LED wire-to-pin and the second eject contact are still open.
    - SOURCES: the two TE 292161 STEP models and where they came from.
    [bom.csv]
2026-10-25 fix(pcb): R17 is 180 ohm, the IF-83's LED anode pull-up
    Measured the LED pull-up on the IF-83: 180 ohm to +5V. Our board drives
    the LED the same way (U4 output through R17, cathode to GND), so R17
    takes the same value for the same brightness. About 17 mA from 5 V,
    inside the 8T245's 32 mA output rating.
    - Schematic and board: R17 value 330 -> 180. Footprint unchanged, so
    the fabrication outputs are unaffected.
    - bom.csv / bom.md: R17 = 180 (Yageo RC1206FR-07180RL, DigiKey
    311-180FRCT-ND); the "keep 220 and 470 on hand" note is gone and the
    open item on the R17 value is closed.
    - FABRICATION.md and research_notes.md record the measurement,
    2026-10-25.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
    [a2m2053.kicad_pcb, a2m2053.kicad_sch, bom.csv]
2026-10-25 build(pcb): fabrication outputs for Disk Hamr rev 1.0, as sent to PCBWay
    Gerber X2 set (F/B copper, mask, paste, silk, Edge.Cuts, job file) and
    Excellon PTH/NPTH drills from KiCad 10.0.4, plus the zip uploaded to
    PCBWay on 2026-10-25. Board 100.1 x 110.1 mm, 2 layers, 1.6 mm, 1 oz,
    min track 0.25 mm, clearance 0.2 mm, min drill 0.3 mm, every via ring
    at least 0.15 mm.
    [a2m2053-B_Cu.gbr, a2m2053-B_Mask.gbr, a2m2053-B_Paste.gbr, a2m2053-B_Silkscreen.gbr, a2m2053-Edge_Cuts.gbr, a2m2053-F_Cu.gbr, a2m2053-F_Mask.gbr, a2m2053-F_Paste.gbr]
2026-10-25 docs: HANDOFF for 2026-10-25, second layout sent to PCBWay
2026-10-25 docs: J1 DB-19 is purchased and fit-tested, drop the sourcing notes
    The DB-19 female right-angle connectors are in hand and were fit-tested
    in the printed outline and the case opening (M7.2). Remove the
    "hard to source", "buy a spare", "verify a new seller" and pins-to-face
    notes from the BOM, FABRICATION.md and the M9 open list.
    [bom.csv]
2026-10-25 docs(bom): DB-19 at $15 from eBay, DigiKey prices as of 2026-10-25
    J1 is the rarest and most expensive part on the board. Shifters at the
    DigiKey list price, cost summary and total updated.
    [bom.csv]
2026-10-25 fix(pcb): swap J5 pins to match the IF-83 LED header, re-plot Gerbers
    Measured on the IF-83 (2026-10-25): the CN107 pin nearer the 3-pin eject
    header goes to the Q101 sink (cathode side); the far pin carries the
    180 ohm pull-up to +5V (anode side). Our J5 had /LED on the near pin and
    GND on the far pin, so the drive's own LED lead would have sat
    reverse-biased.
    - Schematic and board: J5 pin 1 (nearer J4) is GND, pin 2 (toward the
    board edge) is /LED through R17. Two stubs re-routed. DRC: 0 errors,
    0 unconnected.
    - Gerbers and drills re-plotted with kicad-cli, same layer set and
    formats as the 08:38 plot. Zip disk_hamr_2026_10_25b.zip replaces the
    earlier upload; the first zip has J5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
    [a2m2053-B_Cu.gbr, a2m2053-B_Mask.gbr, a2m2053-B_Paste.gbr, a2m2053-B_Silkscreen.gbr, a2m2053-Edge_Cuts.gbr, a2m2053-F_Cu.gbr, a2m2053-F_Mask.gbr, a2m2053-F_Paste.gbr]
2026-10-25 docs: per-board cost from the 2026-10-25 orders, DigiKey order placed
    DigiKey web ID 378380678 (5 assemblies, 10% attrition, $109.20 landed).
    PCBWay PCB W936711ASX11 and stencil S-X12W936711A in the cart, unpaid
    until PCBWay answers on sponsorship. Per board: $41.75 parts and board,
    about $57 landed with shipping, tariff and tax.
2026-10-25 docs: user manual draft for Disk Hamr rev 1.0
    First draft of the guide that ships with the board as a QR link:
    which drive it is for (A2M2053, and the drives it is not for), what it
    is tested on, box contents, the three rails on the drive's cables and
    the IWM warning, how to tell a dead IF-83 from a dirty mechanism, the
    board swap step by step with full-width photos, first boot, daisy
    chain, a troubleshooting ladder, firmware update over BOOTSEL, how it
    was built with a link to every build log, specifications. A design
    notes section at the top for the styled version. Photo and confirm
    markers inline.
    BOM: 20-way IDC ribbon (CBL1) ships with the board, part number and
    length still a guess. H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
    [bom.csv]
2026-10-25 docs: HANDOFF end of 2026-10-25, project paused until parts and boards land
    Prototype rewire dropped (same chips and Pico pins, nothing to learn,
    risk to the prototype). Open items: PCBWay payment, J4 cable pinout,
    optional silk labels before PCBWay is paid, build plan, manual photo
    session and confirms, rev 1.1 notes.
2026-10-25 docs: PCB bring-up plan for Disk Hamr rev 1.0
    Four gates for the first soldered board: meter checks before power,
    host-line contention proof on the bench supply, mechanism channel check,
    Apple IIe function tests, then stress on the RAM disk with the mechanism
    idle. Includes a per-board mechanism wear budget and the three console
    commands wanted before bring-up (vsys, led, sp clear).
    HANDOFF: next steps for the bring-up firmware (spec, plan, TDD) and the
    bench gates, numbered into the existing list.
2026-10-27 docs: untrack HANDOFF.md, move the channel map into PCB_BRINGUP.md
    HANDOFF.md is personal workflow state (resume order, order numbers, bench state) and stays local. The prototype vs PCB channel map it held is the one part other docs cite, so it moves to an appendix in PCB_BRINGUP.md and the citations point there.
2026-10-27 docs: remove the owner's name from workflow and source tags
    Plans, specs, build logs, console-log annotations and the reference docs named the owner as the bench actor and as a measurement source. Bench actor is now the operator; source tags keep their dates or become [measured]. No fact, date or value changed. Author attribution in LICENSE, README and the silkscreen stays.
    [bom.csv]
2026-10-27 chore: public-repo pass on firmware and tools comments
    Comment-only changes from an audit of every source file: milestone and plan-task numbers used as identifiers become the thing they named, one stale pass-through note and one stale 'not yet confirmed' note are corrected, an old-code/new-code narrative in a Python test becomes the invariant it checks, and restating comments are dropped. The CMake note now tells a reader how to build the optional ProDOS image. Host tests: 15 suites, 0 failures.
    [flux.py, gcr.py, main.c, sp_dev.h, sync_core1.h, test_flux_dec.c]
